PLAN-IT-B/BachelorProefTrappenMaar/Components/SnelheidViaESP/opstelling.jpg

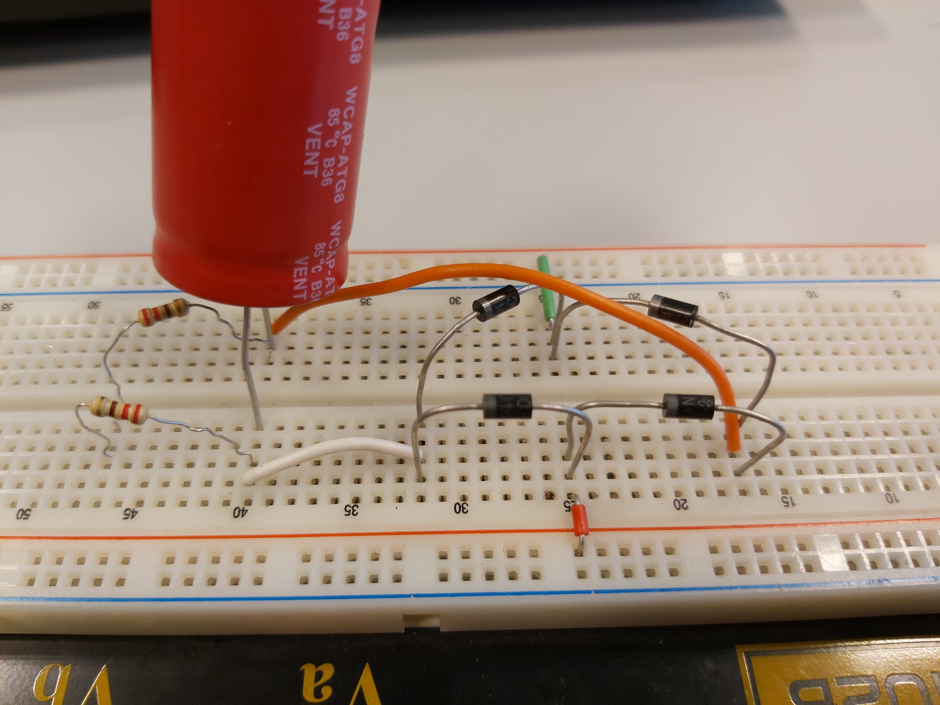
Components/SnelheidViaESP/opstelling.jpg
