PLAN-IT-B/BachelorProefTrappenMaar/documentatie/trappenMaar Gantt_chart.pdf

13 | 20 | 27
| 2/22 3/22 4/22 5/22
6 | 13 | 20 | 27 | 3 | 10 | 17 | 24 | 1 | 8 | 15
Gantt chart trappen maar | start | end | 0h | 0%
First Group (click to rename) | 14/02/22 | 17/05/22 | 0h | 0%
Planning maken | 14/02 | 20/02 | 0 | 0%
brainstormen | 21/02 | 21/02 | 0 | 0%
Opzoeken technologieën | 21/02 | 21/02 | 0 | 0%
onderdelen (stapsgewijs) testen | 21/02 | 22/03 | 0 | 0%
Componenten bestellen | 22/02 | 01/03 | 0 | 0%
Alles connecteren | 22/03 | 22/03 | 0 | 0%
PCB ontwerp maken | 23/03 | 29/03 | 0 | 0%
PCB etsen, testen en verifiëren | 29/03 | 29/03 | 0 | 0%
PCB bestellen | 12/04 | 12/04 | 0 | 0%
inkleding eigen puzzels | 08/03 | 03/05 | 0 | 0%
documentatie | 22/02 | 17/05 | 0 | 0%
presentatie maken | 10/05 | 17/05 | 0 | 0%
finale testing en presentatie | 17/05 | 17/05 | 0 | 0%
inkleding escape room | 19/04 | 03/05 | 0 | 0%
integratie alle opdrachten | 03/05 | 03/05 | 0 | 0%
1e test (wij) | 03/05 | 03/05 | 0 | 0%
2e test (derden) | 10/05 | 10/05 | 0 | 0%

Powered by TCPDF (www.tcpdf.org)
