PLAN-IT-B/BachelorProefTrappenMaar/documentatie/fotos voor presentatie/2014-flappybird-gr%20%281%29.jpg

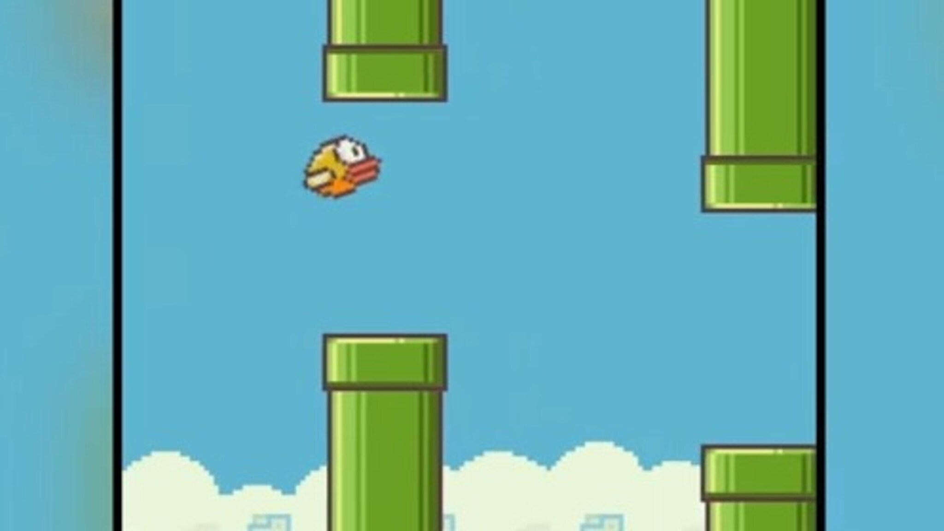
documentatie/fotos voor presentatie/2014-flappybird-gr%20%281%29.jpg
