PLAN-IT-B/BachelorProefTrappenMaar/documentatie/fotos voor presentatie/Desktop-Verstelbare-DC-DC-Converter-USB-en-Micro-USB-1-1500x1500w.jpg

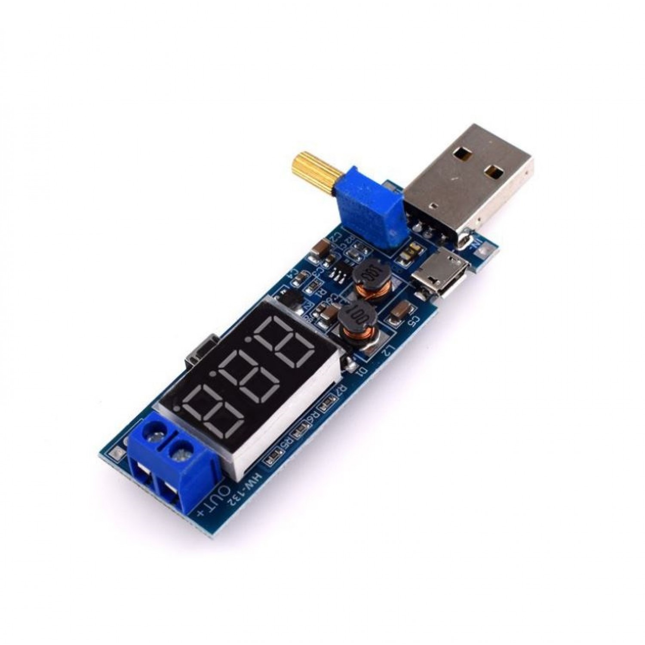
documentatie/fotos voor presentatie/Desktop-Verstelbare-DC-DC-Converter-USB-en-Micro-USB-1-1500x1500w.jpg
