PLAN-IT-B/BachelorProefTrappenMaar/documentatie/fotos voor presentatie/Geel licht.jpg

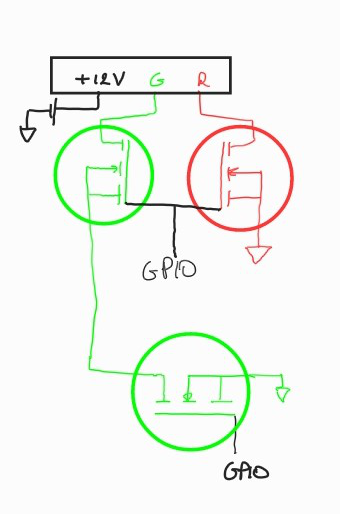
documentatie/fotos voor presentatie/Geel licht.jpg
