PLAN-IT-B/BachelorProefTrappenMaar/documentatie/fotos voor presentatie/uv.jpg

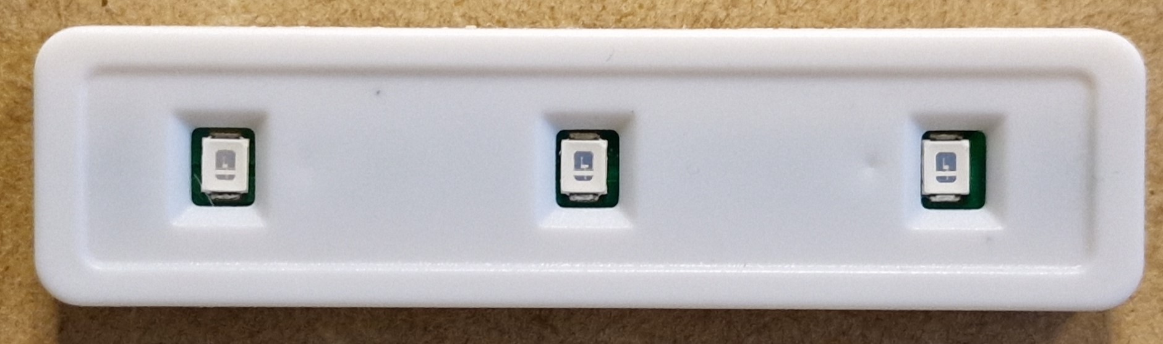
documentatie/fotos voor presentatie/uv.jpg
