PLAN-IT-B/BachelorProefTrappenMaar/documentatie/fotos voor presentatie/Vernieuwd geel licht_1.jpg

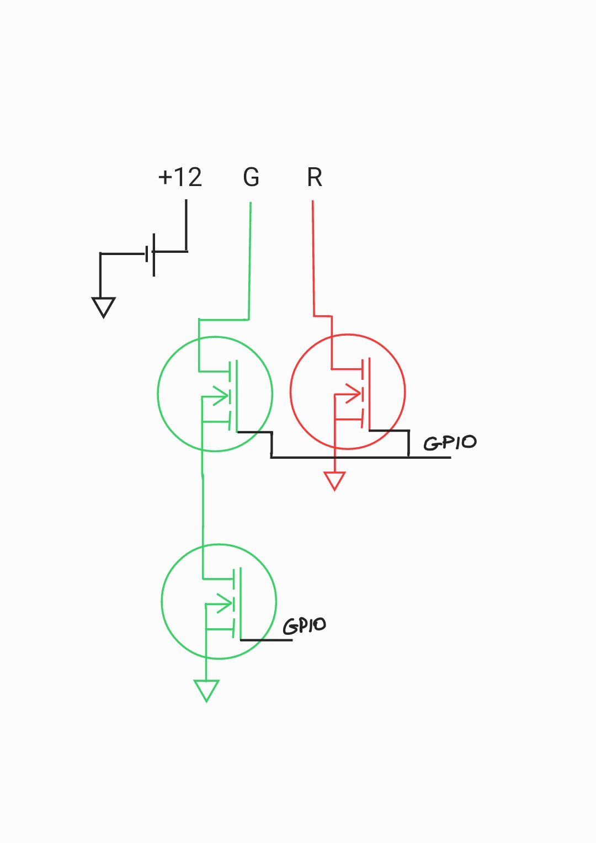
documentatie/fotos voor presentatie/Vernieuwd geel licht_1.jpg
