PLAN-IT-B/BachelorProefTrappenMaar/probeersels code/poging 1/rgbDriverOrangeYellow/WerkendeMetVeelTransistoren/20220328_114709.jpg

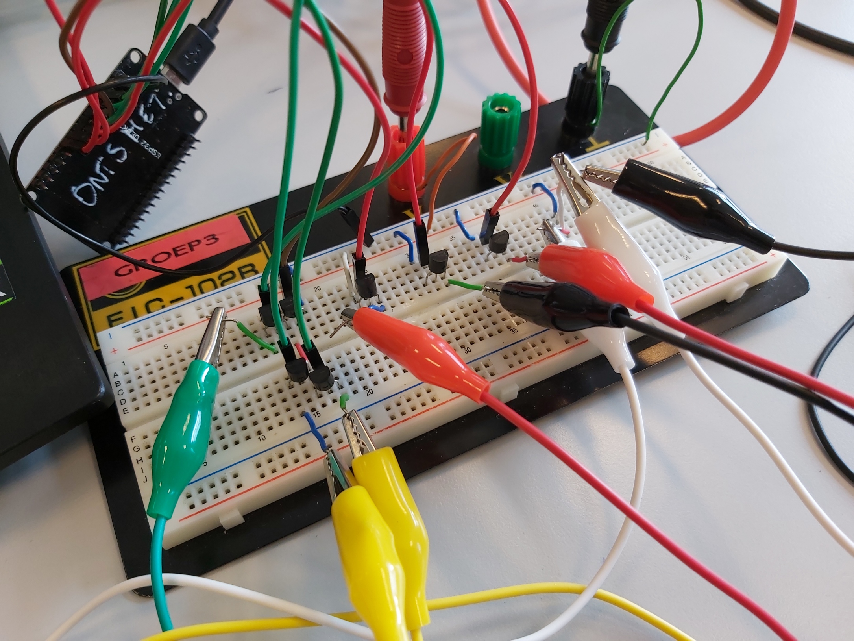
probeersels code/poging 1/rgbDriverOrangeYellow/WerkendeMetVeelTransistoren/20220328_114709.jpg
