PLAN-IT-B/BachelorProefTrappenMaar/Screenshot_1.png

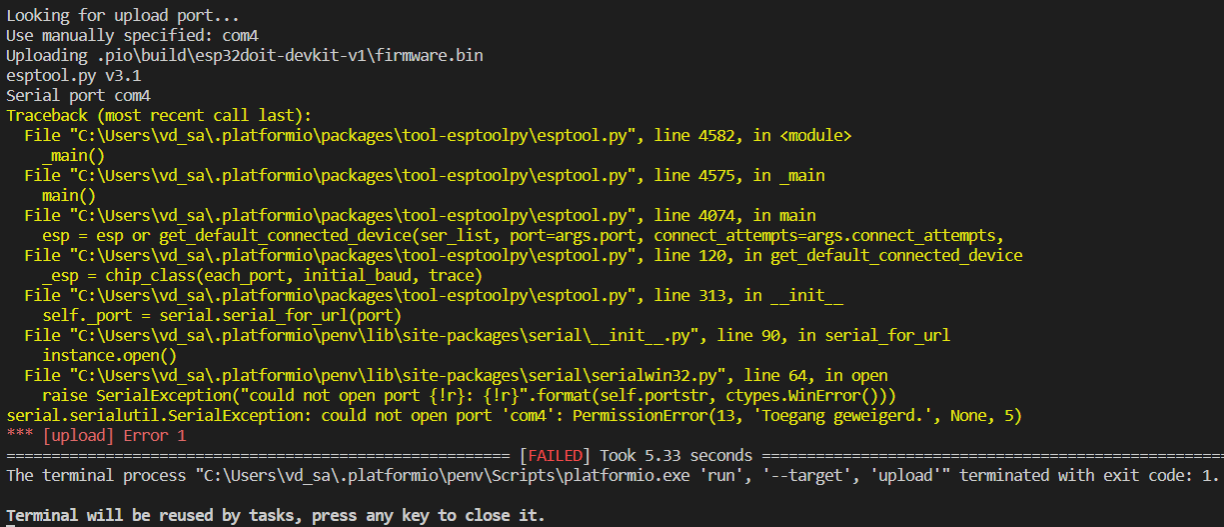
Screenshot_1.png
