PLAN-IT-B/BachelorProefTrappenMaar/website/blokschema.png

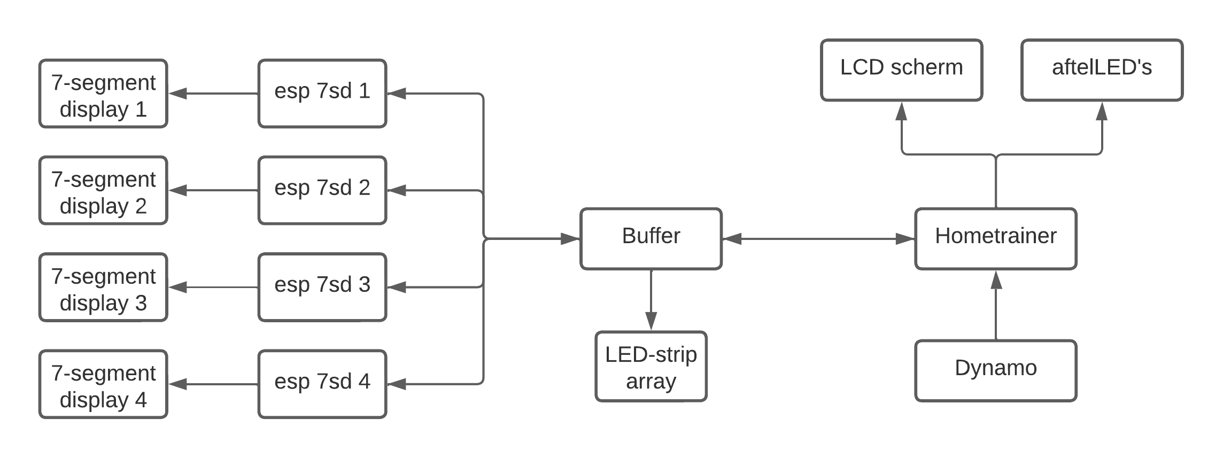
website/blokschema.png
