PLAN-IT-B/BachelorProefTrappenMaar/website/flowchart.png

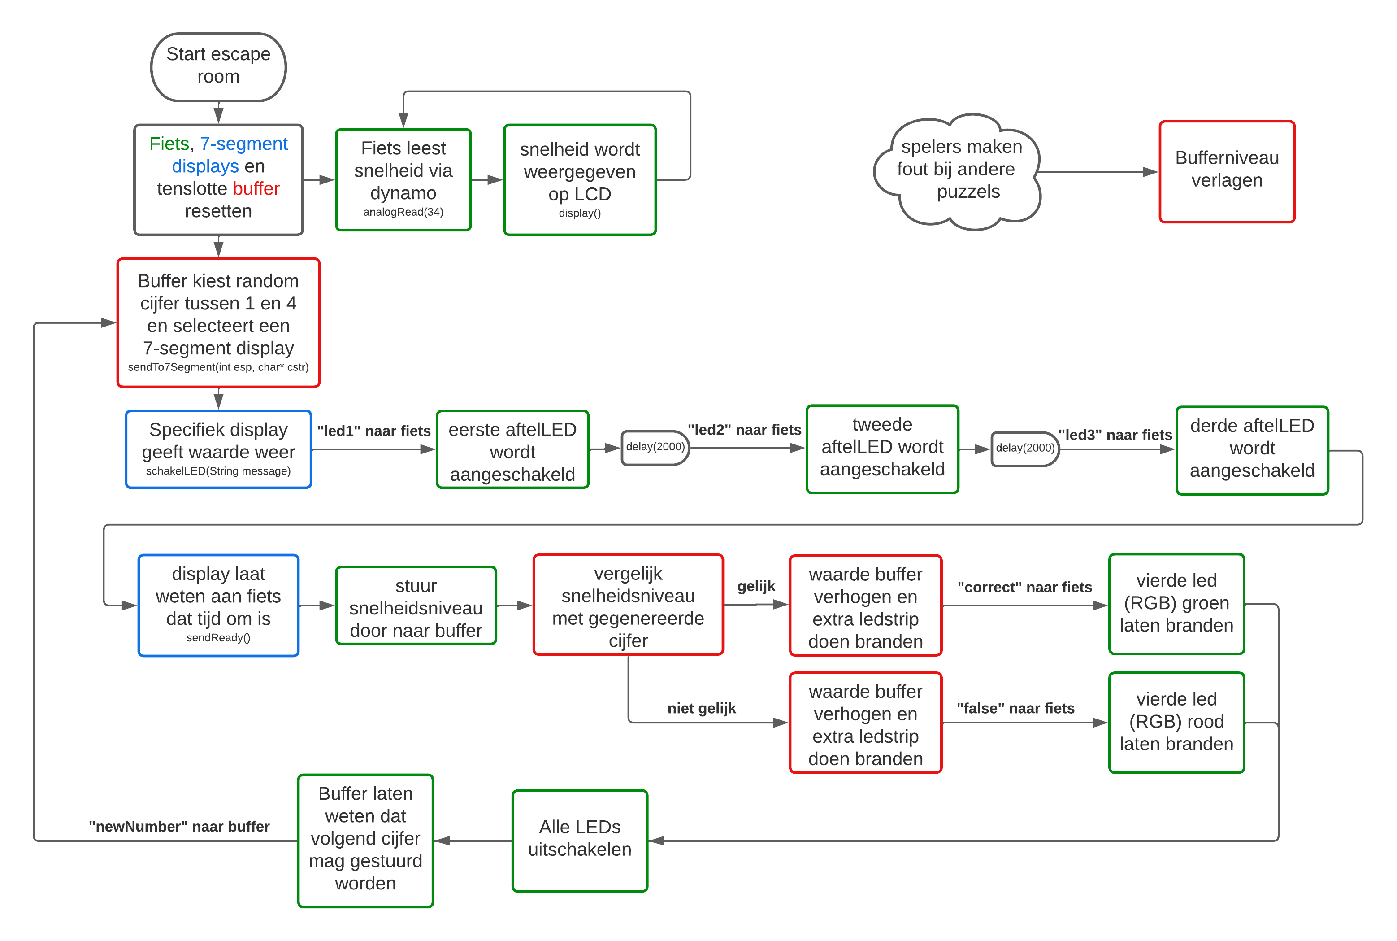
website/flowchart.png
