PLAN-IT-B/BachelorProefTrappenMaar/website/foto's/7segment/7segment.jpg

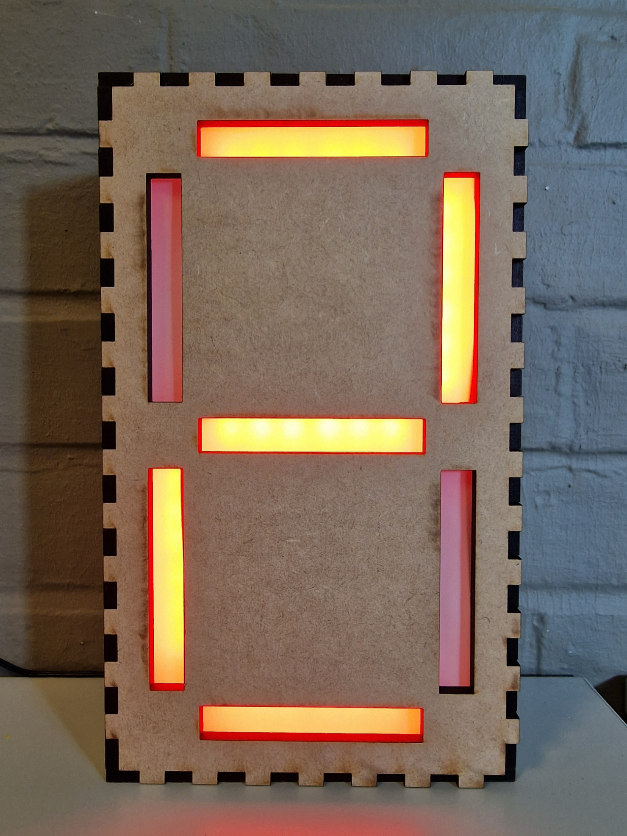
website/foto's/7segment/7segment.jpg
