PLAN-IT-B/BachelorProefTrappenMaar/website/foto's/alles.jpg

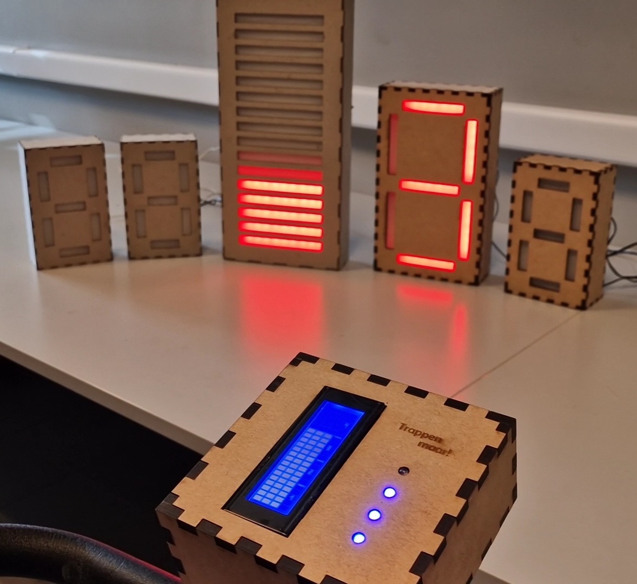
website/foto's/alles.jpg
