PLAN-IT-B/BachelorProefTrappenMaar/website/foto's/Buffer/20220517_134410.jpg

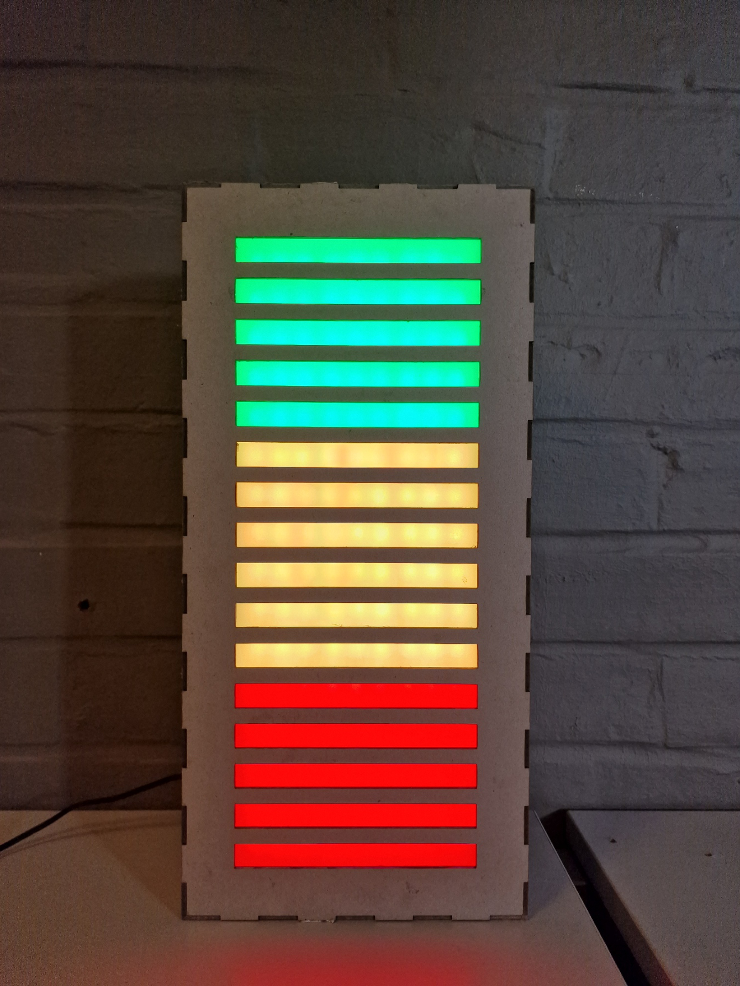
website/foto's/Buffer/20220517_134410.jpg
