PLAN-IT-B/BachelorProefTrappenMaar/website/foto's/Buffer/buffer.jpg

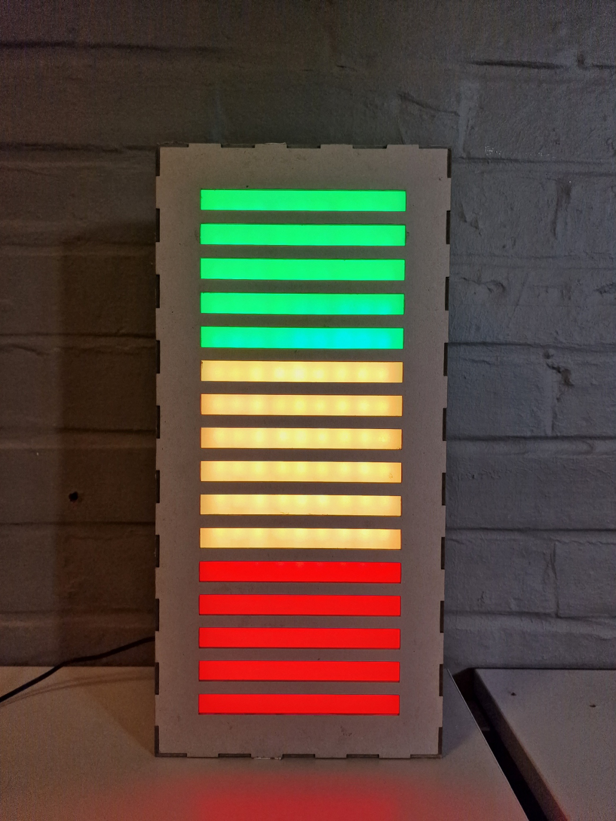
website/foto's/Buffer/buffer.jpg
