PLAN-IT-B/BachelorProefTrappenMaar/website/foto's/Fiets/20220517_134557.jpg

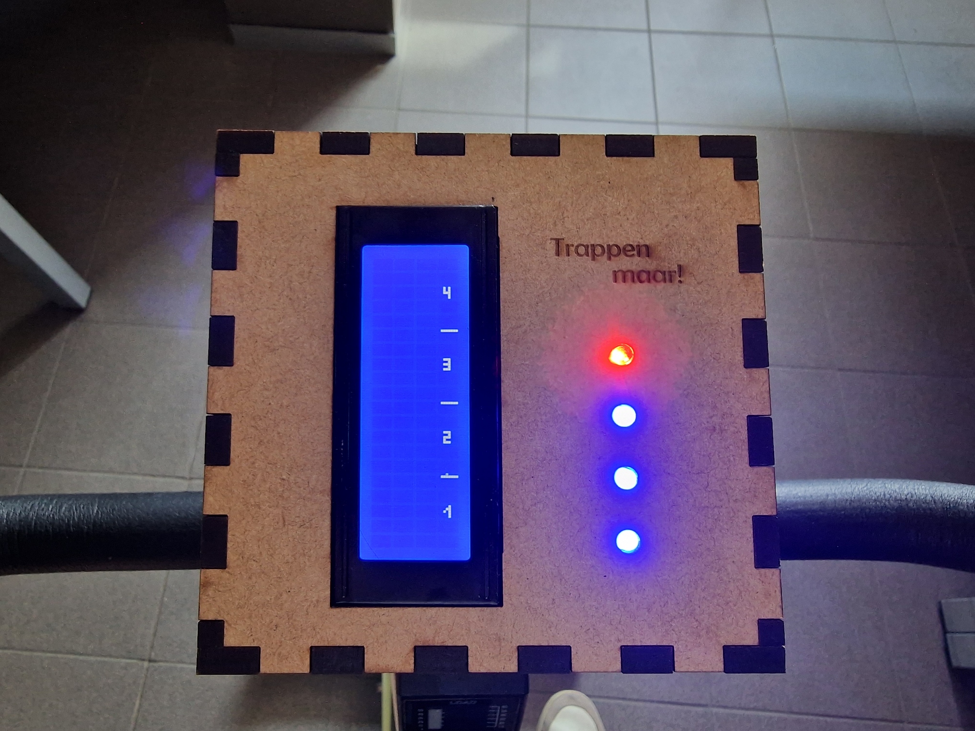
website/foto's/Fiets/20220517_134557.jpg
