PLAN-IT-B/BachelorProefTrappenMaar/website/foto's/Fiets/20220517_134650.jpg

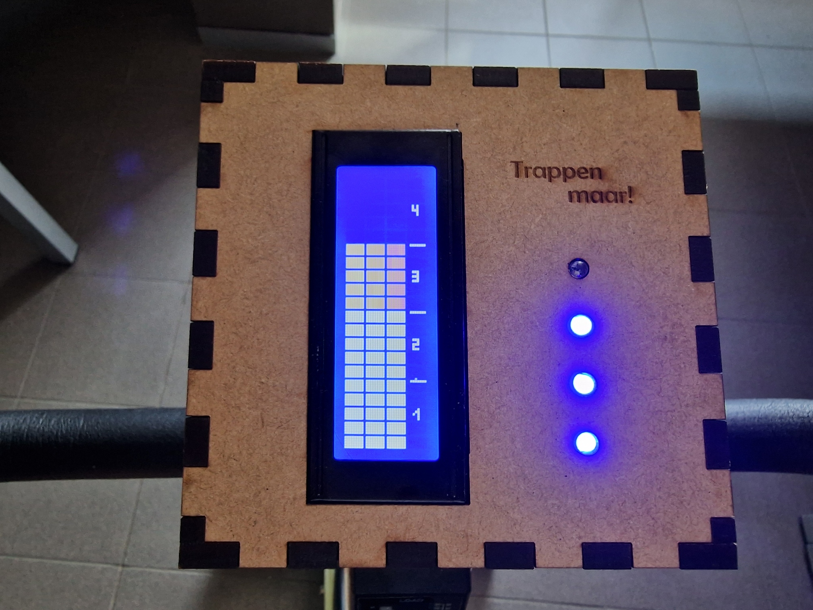
website/foto's/Fiets/20220517_134650.jpg
