PLAN-IT-B/BachelorProefTrappenMaar/website/foto's/Fiets/hometrainer.jpg

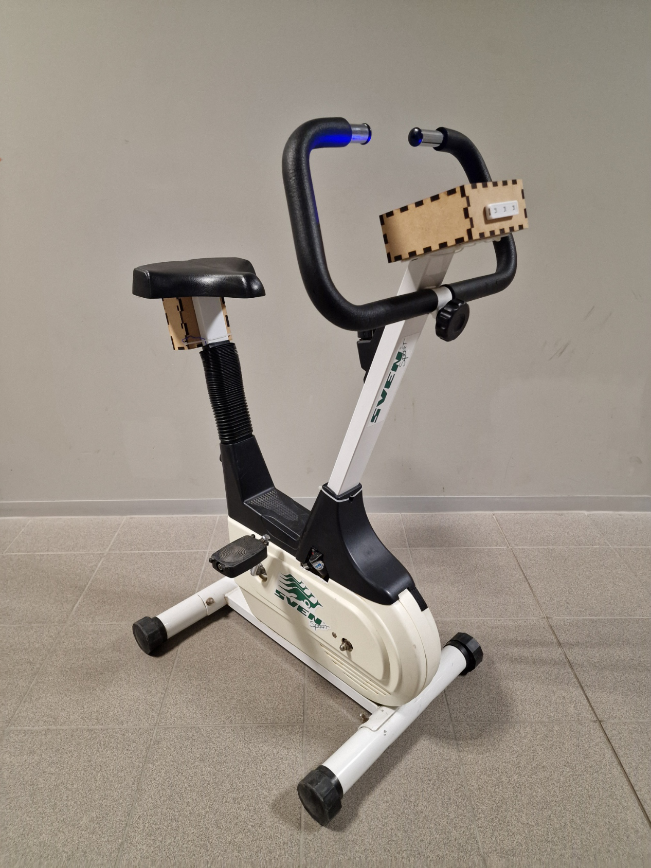
website/foto's/Fiets/hometrainer.jpg
