PLAN-IT-B/BachelorProefTrappenMaar/website/foto's/Fiets/juistGetrapt.jpg

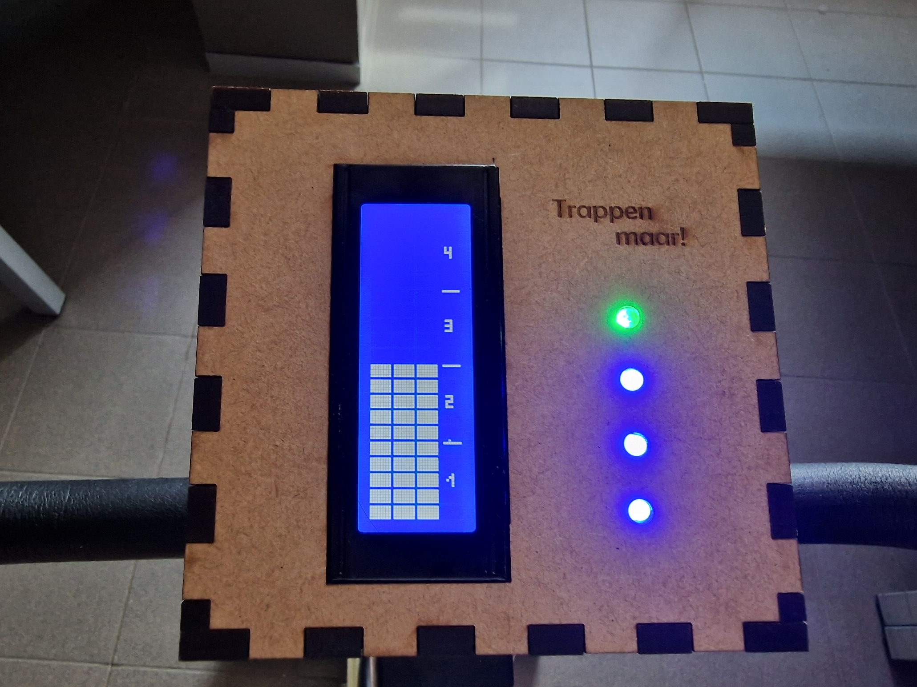
website/foto's/Fiets/juistGetrapt.jpg
