PLAN-IT-B/BachelorProefTrappenMaar/website/foto's/Fiets/lcd2.jpg

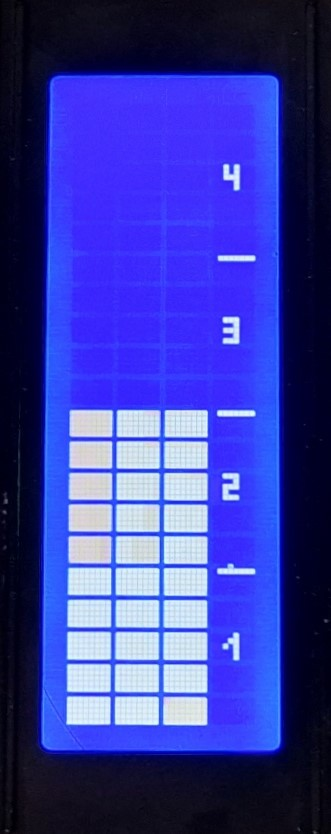
website/foto's/Fiets/lcd2.jpg
