PLAN-IT-B/BachelorProefTrappenMaar/website/foto's/Fiets/lcd.jpg

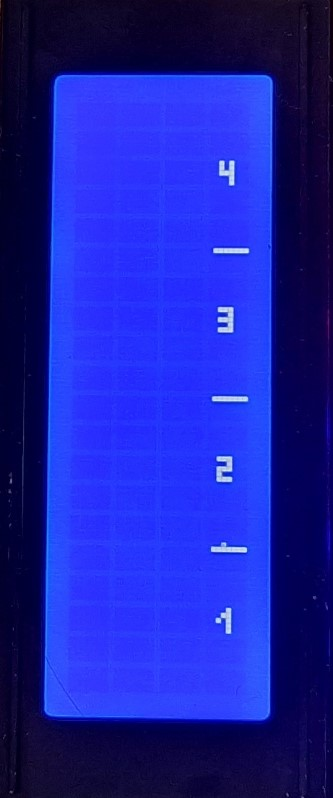
website/foto's/Fiets/lcd.jpg
