PLAN-IT-B/BachelorProefTrappenMaar/website/foto's/Fiets/lcd_collage.jpg

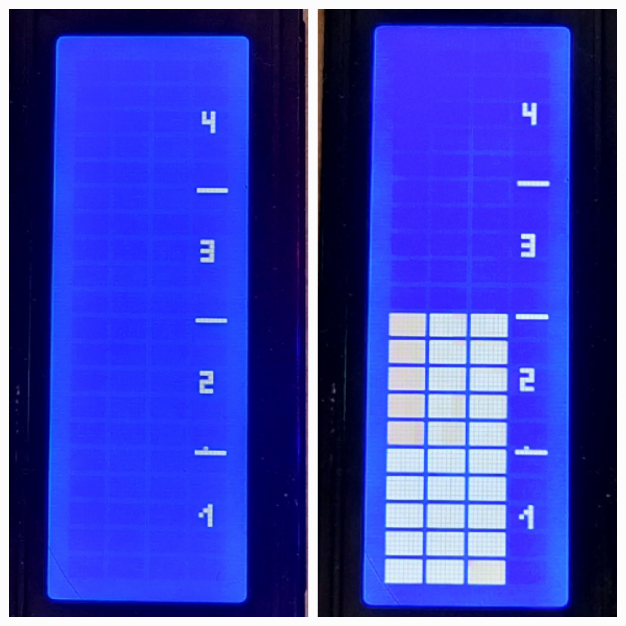
website/foto's/Fiets/lcd_collage.jpg
