PLAN-IT-B/BachelorProefTrappenMaar/website/Kicad_screenshots/7Segment/EEschema.png

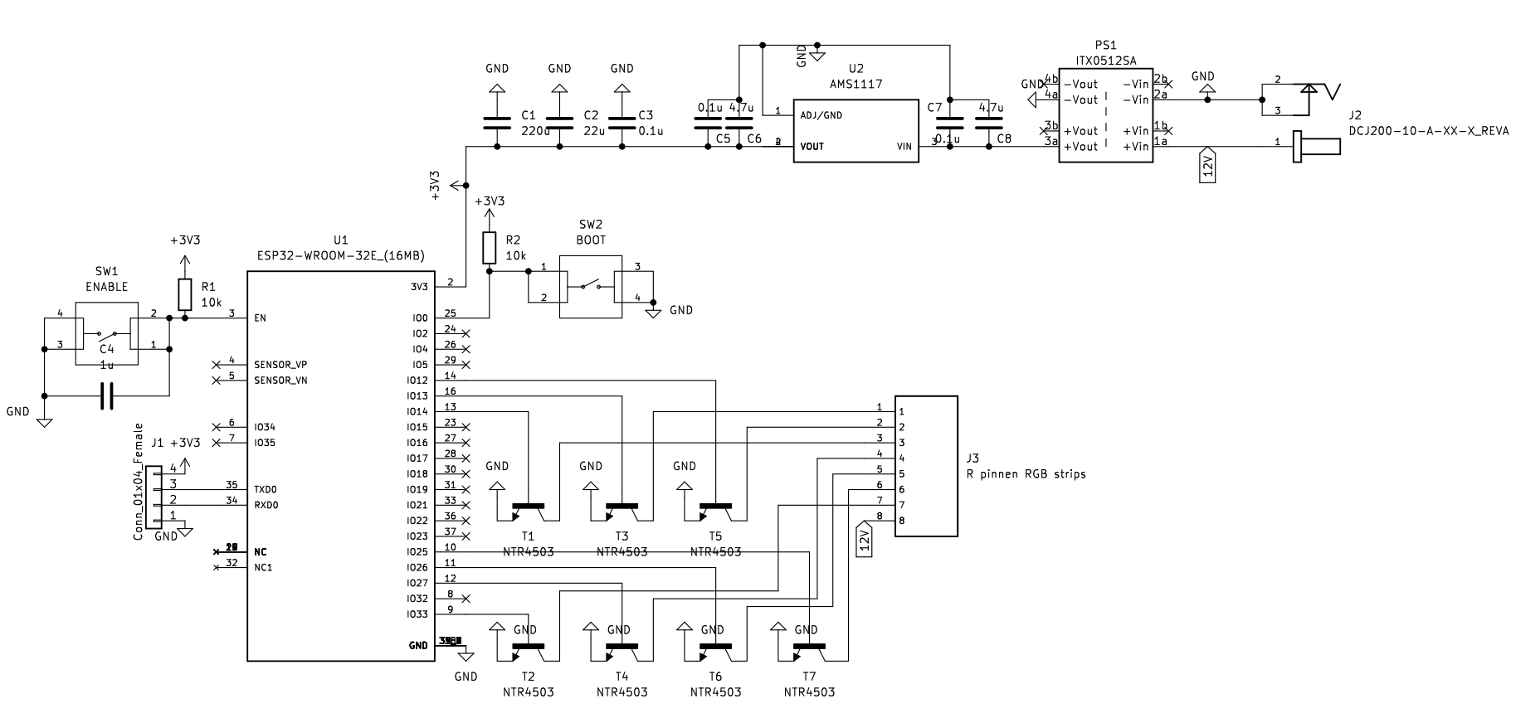
website/Kicad_screenshots/7Segment/EEschema.png
