PLAN-IT-B/BachelorProefTrappenMaar/website/Kicad_screenshots/7Segment/PCB_achterkant.png

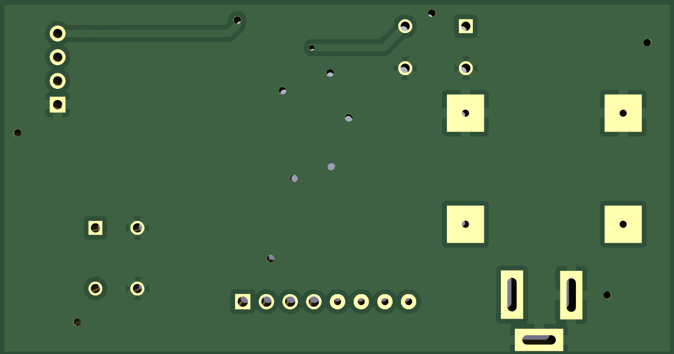
website/Kicad_screenshots/7Segment/PCB_achterkant.png
