PLAN-IT-B/BachelorProefTrappenMaar/website/Kicad_screenshots/7Segment/PCB_voorkant.png

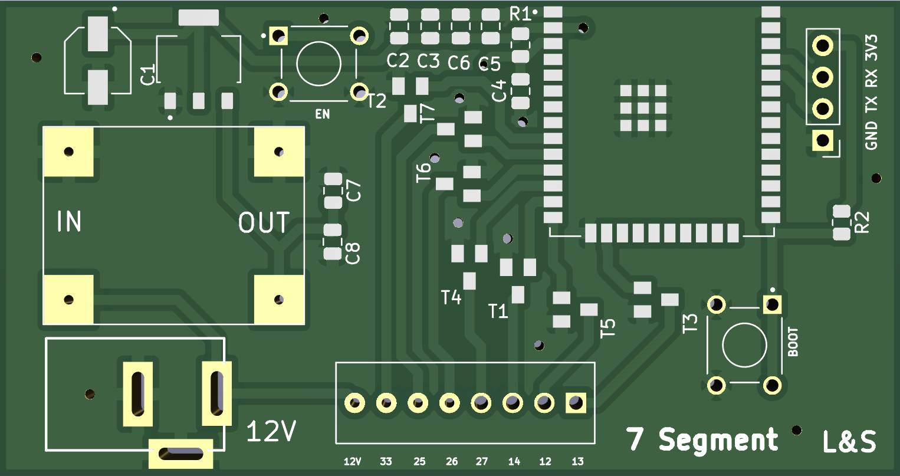
website/Kicad_screenshots/7Segment/PCB_voorkant.png
