PLAN-IT-B/BachelorProefTrappenMaar/website/Kicad_screenshots/Buffer/EEschema.png

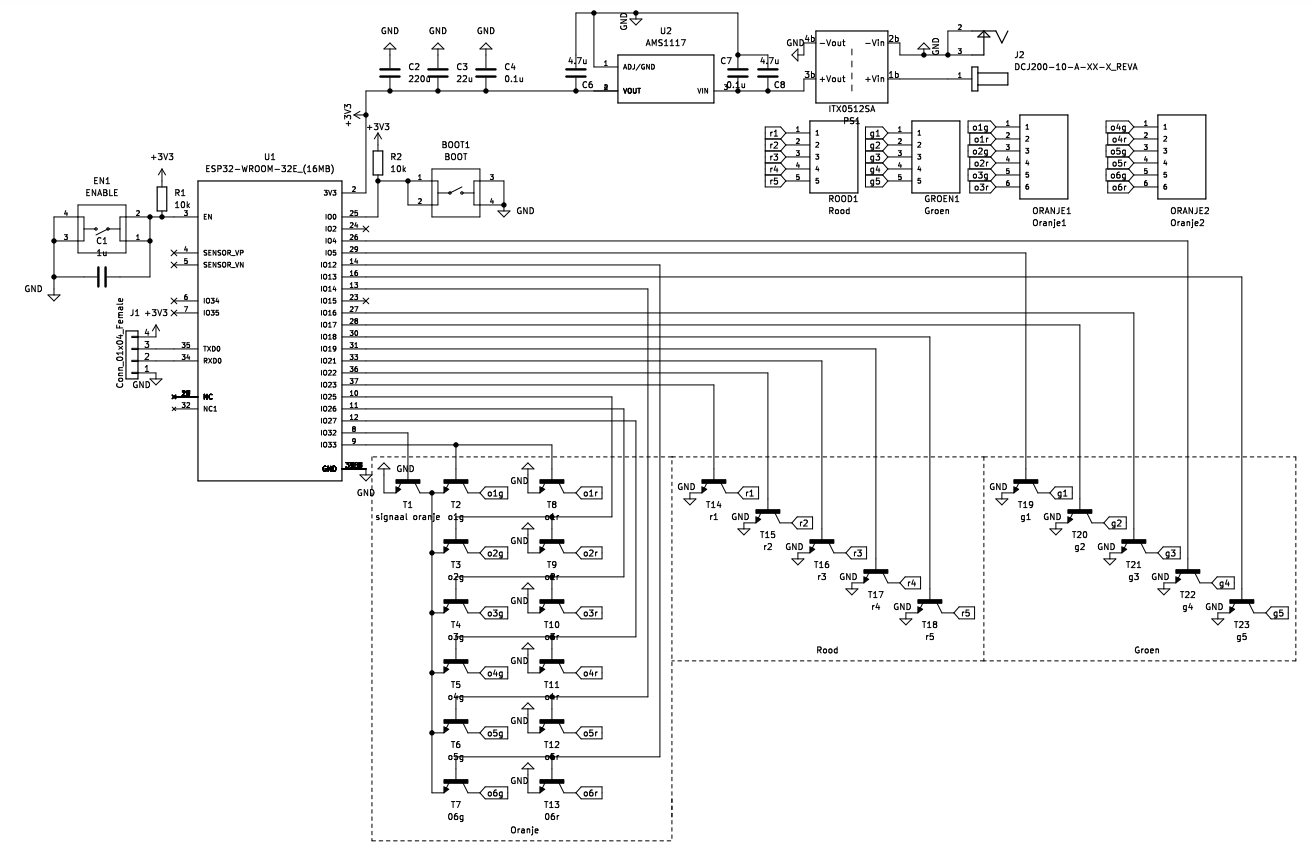
website/Kicad_screenshots/Buffer/EEschema.png
