PLAN-IT-B/BachelorProefTrappenMaar/website/Kicad_screenshots/Buffer/PCB_achterkant.png

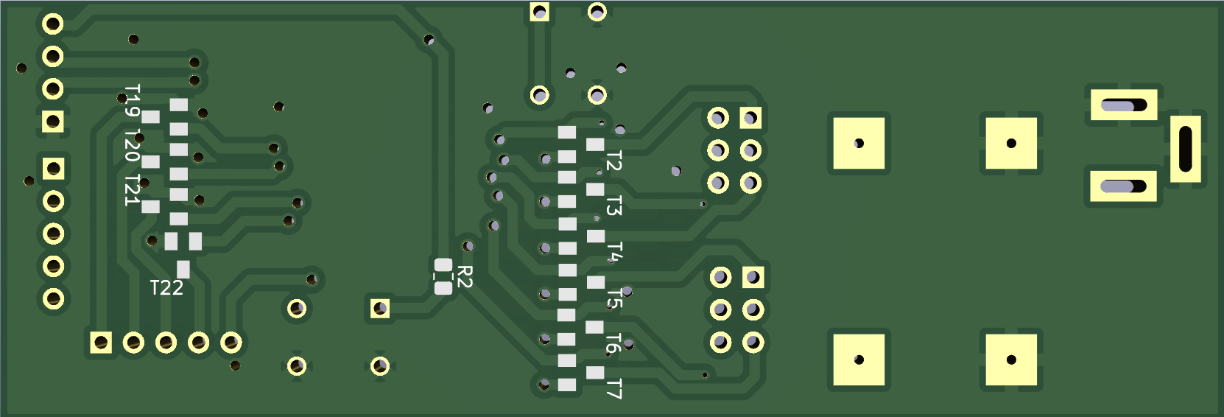
website/Kicad_screenshots/Buffer/PCB_achterkant.png
