PLAN-IT-B/BachelorProefTrappenMaar/website/Kicad_screenshots/Buffer/PCB_voorkant.png

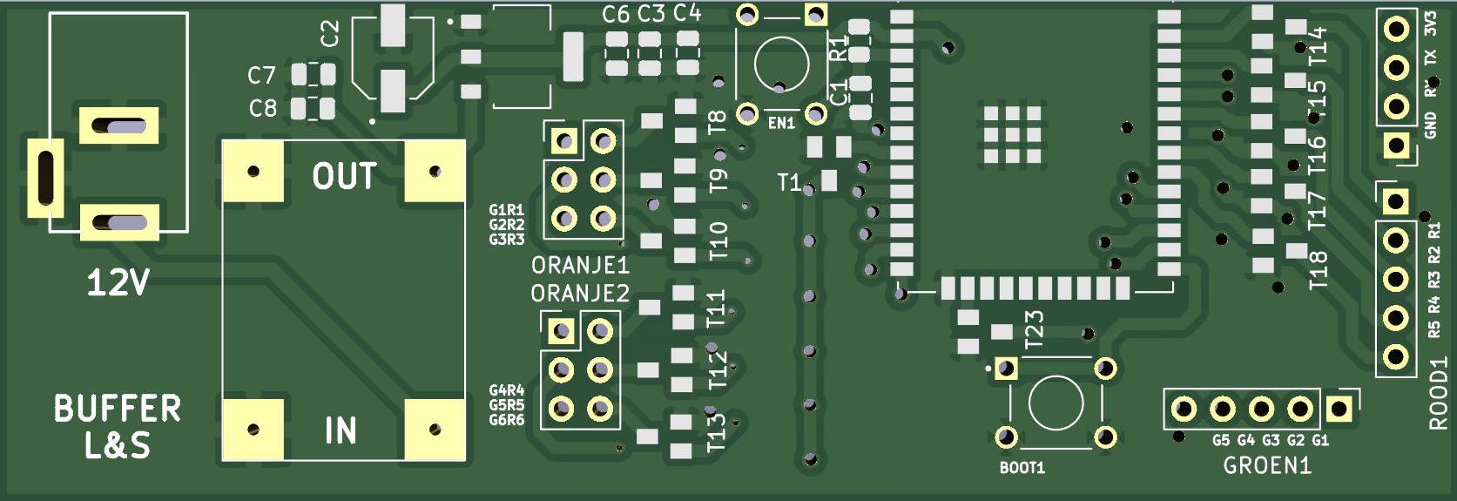
website/Kicad_screenshots/Buffer/PCB_voorkant.png
