PLAN-IT-B/BachelorProefTrappenMaar/website/Kicad_screenshots/Fiets/EEschema.png

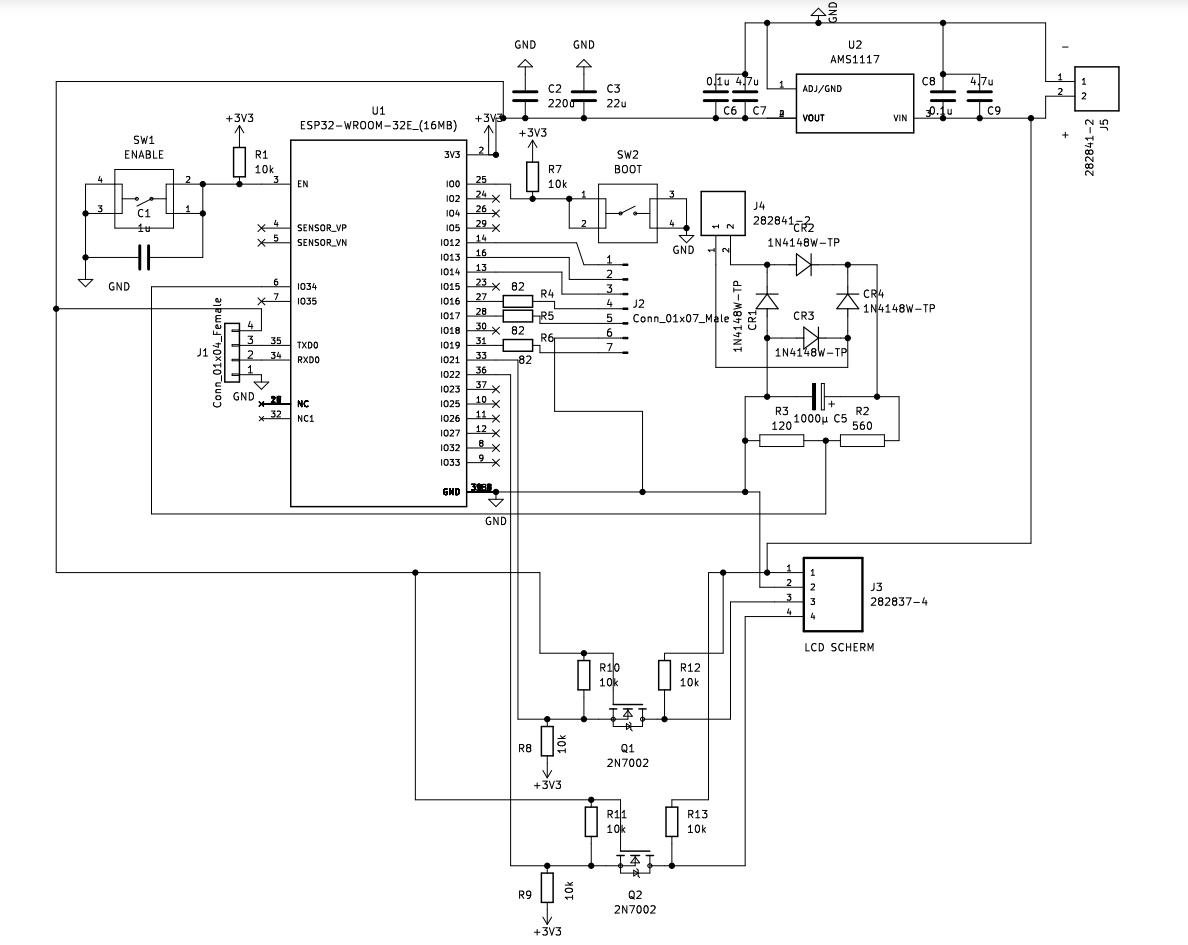
website/Kicad_screenshots/Fiets/EEschema.png
