PLAN-IT-B/BachelorProefTrappenMaar/website/Kicad_screenshots/Fiets/pcb.png

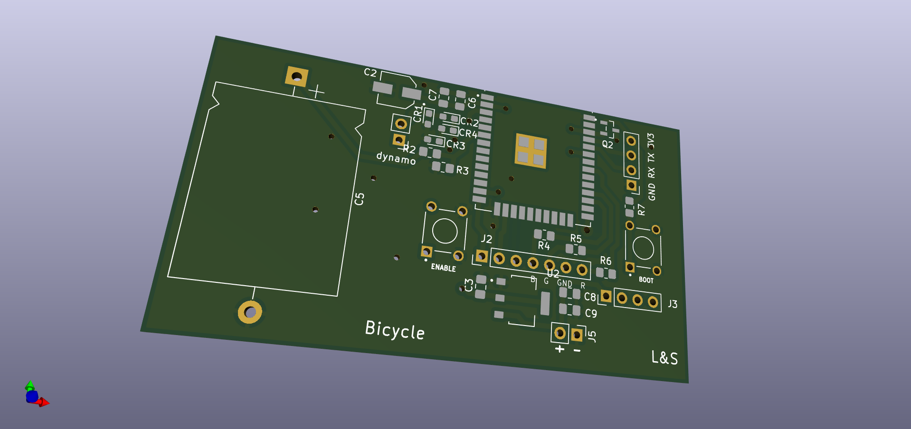
website/Kicad_screenshots/Fiets/pcb.png
