PLAN-IT-B/BachelorProefTrappenMaar/website/Kicad_screenshots/Fiets/PCB_achterkant.png

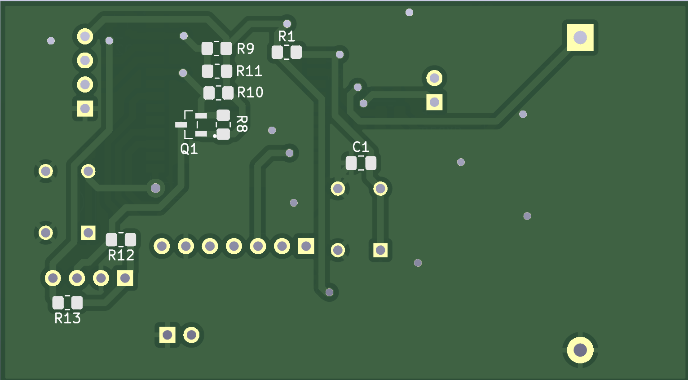
website/Kicad_screenshots/Fiets/PCB_achterkant.png
