PLAN-IT-B/BachelorProefTrappenMaar/website/Kicad_screenshots/Fiets/pcb_voorkant.png

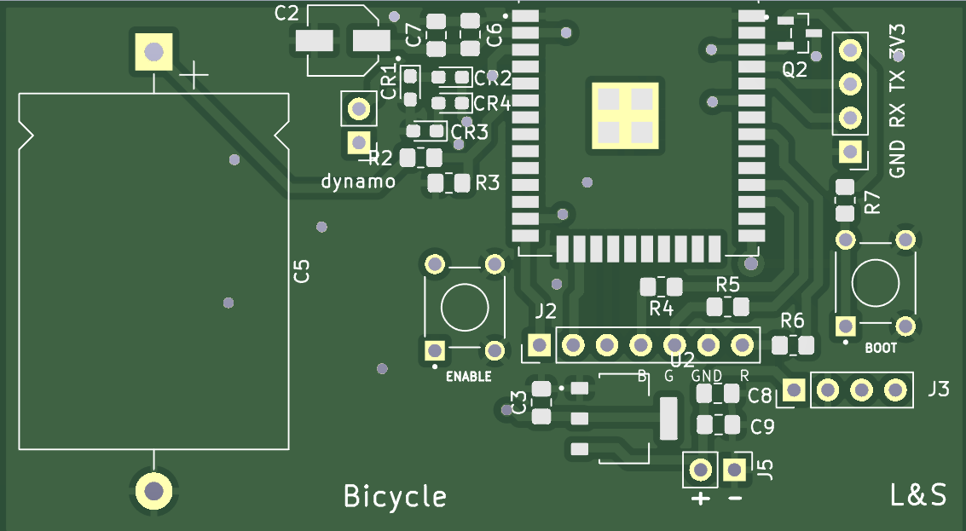
website/Kicad_screenshots/Fiets/pcb_voorkant.png
