PLAN-IT-B/BachelorProefTrappenMaar/documentatie/BOM.docx

# Verhaal schetsen om BOM op te stellen

Het fietsspel op zich bestaat uit:

De hometrainer met paneel

Verschillende 7 segment displays

Een buffer die dient opgevuld te worden

Op het wiel van de hometrainer monteren we een reed relay die aangesloten is op een esp32.

Diezelfde (?) esp is verbonden met het paneel van de fiets waarop het huidige snelheidsniveau, de score en de tijd worden weergegeven. Het paneel zal bestaan uit een lcd scherm om het snelheidsniveau aan te duiden, 2(?) 7-segment displays om de score weer te geven en 4 leds om af te tellen

De buffer zal bestaan uit gestapelde ledstrips die per horizontaal niveau kunnen aangestuurd worden (aan/uit + kleuronderscheid rood, oranje en groen).

# BOM

- Reed relay ( eventueel meerdere om defecten voor te zijn) + weerstand 1kOhm
- Lcd scherm → oke? Hebben we uit de les
- double 7-segment displays
- 4 leds (3 leds in een kleur bv WIT, 1 in een ander om de beslissende tel aan te duiden bv ROOD)
- 1 esp32 voor centrale puzzel

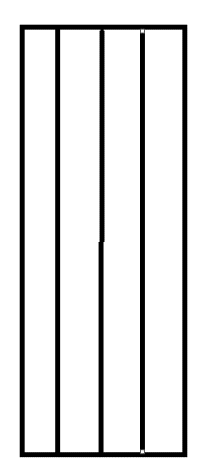
[picture p36: figure]

- 1 esp32 voor buffer
- Ledstrips voor elk niveau van de buffer ( eventueel door 1 lange ledstrip in stukken te knippen) https://www.youtube.com/watch?v=5M24QUVE0iU

2 opties:

a) Aantal ledstrips naast elkaar

Soorten ledstrips: WS2811 of WS2812B
(4 dollar per meter)
makkelijker te programmeren

Indien deze individueel adresseerbare leds binnen ons budget passen, is dit principe goed voor mij!

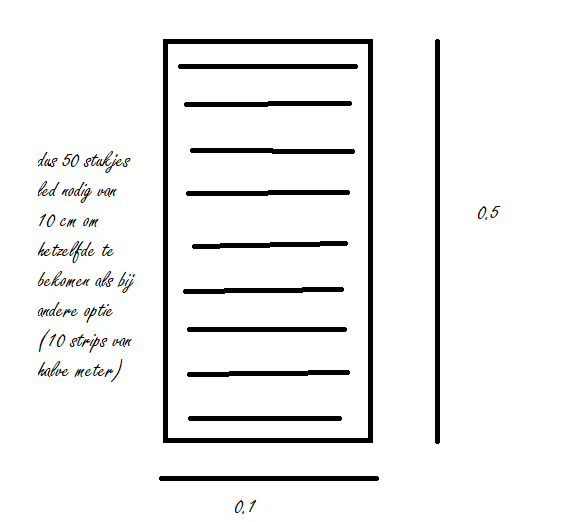
[picture p37: figure]

Bv: https://diamantled.nl/digitale-led-strip-los-ws2811-60led-m-ip20.html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

→kdenk da 5meter (en dan 10cm x 50cm breedte buffer) wel oke is

b) Aantal strips boven elkaar

SMD5050

(1 dollar per meter)

Moeilijker te programmeren, meer werk.. ipv 10strips hier 50 strips!

Deze methode kunnen we doen indien ons budget het anders niet aankan.

- (diffusers voor ledstrip)

Bv:

- https://www.edmundoptics.eu/p/100-x-100mm-Light-Diffusing-Film/45304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

OF

- https://www.lampdirect.be/nl/ledvance-led-strip-profile-cover-ls-ay-pc-r02-d-1-wit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

Dit zal de goedkoopste optie zijn

- 4 (?) esp32’s voor cijfers weer te geven
- 4 7-segment displays (eventueel wat grotere dan de standaard/zelf maken)
- https://www.youtube.com/watch?v=MxvVChXsETc
- https://www.youtube.com/watch?v=c-fH5WEvn8M

(zelfde principe als eerste link, maar minder mooi afgewerkt)

Denk dat eerste link inderdaad het mooiste resultaat gaat geven en ook wat minder prutswerk inhoudt

Benodigdheden (per 7-segment display):

1. Dik Isomo (1 à 2 cm doorsnede)
2. Dun isomo (zo dun mogelijk, werkt als diffuser voor leds)
3. 7 leds (zelfde kleur)
4. 7 koolweerstanden van 220 ohm
- Fietsgenerator

(zie vragen/opmerkingen hieronder)

VRAGEN BERT:

- Generator? Bike generator? Wat is er?

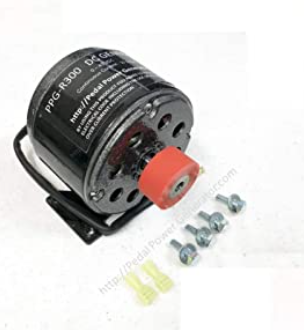
[picture p38: figure]

best zo principe, dat we da oranje dan tegen ons wiel kunnen zetten

Opties?

1) Fietsdynamo: produceert 6V (3W) maar dan is de vraag, welke lamp??
2) Grotere generator: maar dit kost veel.. hebben ze dit op de campus?
3) Eventueel gewone alternator (in alle vormen en maten verkrijgbaar)
4) Desnoods dc-motor aansluiten op wiel zodat die als alternator fungeert

Hoe zorgen we hier voor een constante stroom zodat de lamp weldegelijk kan aangedreven worden?
