PLAN-IT-B/BachelorProefTrappenMaar/documentatie/BOM(final version).xlsx

WAT | LINK | AANTAL | PRIJS/STUK | TOTAAL
blacklight | https://www.bol.com/be/nl/p/mini-16cm-uv-blacklight-met-zaklamp/9200000083518615/ | 1 | 16.44 | 16.44
kroonsteentje 2 | https://www.tinytronics.nl/shop/nl/kabels-en-connectoren/connectoren/schroefterminals/2-pin-schroef-terminal-block-connector-2.54mm-afstand | 1 | 0.3 | 0.3
kroonsteentje 4 | https://www.tinytronics.nl/shop/nl/kabels-en-connectoren/connectoren/schroefterminals/4-pin-schroef-terminal-block-connector-2.54mm-afstand | 1 | 0.45 | 0.45
kroonsteentje 5 | https://www.tinytronics.nl/shop/nl/kabels-en-connectoren/connectoren/schroefterminals/5-pin-schroef-terminal-block-connector-2.54mm-afstand | 2 | 0.5 | 1 |  | (eventuele) EXTRA KOSTEN
kroonsteentje 8 | https://www.tinytronics.nl/shop/nl/kabels-en-connectoren/connectoren/schroefterminals/8-pin-schroef-terminal-block-connector-2.54mm-afstand | 4 | 0.8 | 3.2 |  | lasercutten | ongeveerd 20 euro
ldo ams1117 |  | 6 | 0.25 | 1.5 |  | hometrainer | -
level shifter |  | 1 |  |  |  | fietsdynamo | -
buck converter |  | 5 | 2.39 | 11.95
esp |  | 6 | 4 | 24
pin header Female 4 |  | 6 | 0.4 | 0.4
dc jack |  | 5 | 0.5 | 2.5
buttons |  | 12 | 0.15 | 1.8
C 100uF |  | 6
C 22uF |  | 6
C 0.1uF |  | 18
C 1mF (THT) |  | 1
C 1uF |  | 6
C 4.7uF |  | 12 |  |  | 2 euro
R 10k |  | 12
R 560 |  | 1
R 120 |  | 1
R 82 |  | 3
mosfet NTR4503 |  | 51 |  |  | n-kanaals mosfet met toegelaten source-drainspanning van minstens 20V
ledstrip |  | 1 | 9 | 9 | RGB-ledstrip (hoeven geen afzonderlijk adresseerbare leds te zijn)
 |  |  |  | 74.54
AANTAL COMPONENTEN PER PCB
7 segments (4) |  |  |  |  |  |  |  | buffer |  |  | fiets
C 100uF |  | 1 | 4 |  |  |  |  | C 100uF | 1 |  | C 100uF | 1
C 22uF |  | 1 | 4 |  |  |  |  | C 22uF | 1 |  | C 22uF | 1
C 0.1uF |  | 3 | 12 |  |  |  |  | C 0.1uF | 3 |  | C 0.1uF | 3
C 1uF |  | 1 | 4 |  |  |  |  | C 1uF | 1 |  | C 1uF | 1
C 4.7uF |  | 2 | 8 |  |  |  |  | C 4.7uF | 2 |  | C 4.7uF | 2
R 10k |  | 2 | 8 |  |  |  |  | R 10k | 2 |  | R 10k | 2
pin header Female 4 |  | 1 | 4 |  |  |  |  | pin header Female 4 | 1 |  | pin header Female 4 | 1
kroonsteen 2 |  | 1 | 4 |  |  |  |  | dc jack female (laptoplader) | 1 |  | buttons | 2
kroonsteen 8 |  | 1 | 4 |  |  |  |  | kroonsteen 5 | 2 |  | C 1mF (THT) | 1
buck converter |  | 1 | 4 |  |  |  |  | buck converter | 1 |  | diode 1n4148 | 4 | gelijkrichter (brug van Graetz)
buttons |  | 2 | 8 |  |  |  |  | buttons | 2 |  | kroonsteen 4 | 1
mosfet NTR4503 |  | 7 | 28 |  | n-kanaals mosfet met toegelaten source-drainspanning van minstens 20V |  |  | mosfet NTR4503 | 23 | n-kanaals mosfet met toegelaten source-drainspanning van minstens 20V | R 560 | 1
esp |  | 1 | 4 |  |  |  |  | esp | 1 |  | R 120 | 1
ldo ams1117 |  | 1 | 4 |  |  |  |  | ldo ams1117 | 1 |  | R 82 | 3
 |  |  |  |  |  |  |  |  |  |  | esp | 1
 |  |  |  |  |  |  |  |  |  |  | ldo ams1117 | 1
 |  |  |  |  |  |  |  |  |  |  | level shifter | 1
