PLAN-IT-B/BachelorProefTrappenMaar/documentatie/BOM.xlsx

BOM 2e aankoop
WAT | LINK | AANTAL | PRIJS/STUK | TOTAAL
energie opwekken met fiets
blacklight | https://www.bol.com/be/nl/p/mini-16cm-uv-blacklight-met-zaklamp/9200000083518615/ | 1 | 16.44 | 16.44
BOM
WAT | LINK | AANTAL | PRIJS/STUK | TOTAAL
snelheidsmeter
reed relay | https://www.tinytronics.nl/shop/nl/schakelaars/magneetschakelaars/reed-relais-2*14mm | 2 | 0.3 | 0.6
Weerstand 1kOhm | / | 1 | /
lcd scherm 4x20 | / | 1 | / | / | (aanwezig op school)
7 segment display | https://www.tinytronics.nl/shop/nl/displays/segmenten/segmenten-display-1-karakter-rood | 1 | 0.75 | 0.75
blauwe leds | https://www.tinytronics.nl/shop/nl/componenten/led's/led's/blauwe-led-5mm-diffuus | 3 | 0.1 | 0.3
groene led | https://www.tinytronics.nl/shop/nl/componenten/led's/led's/groene-led-5mm-diffuus | 1 | 0.1 | 0.1
esp 32 | / | 1 | / | /
buffer
esp 32 | / | 1 | / | /
ledstrip ??? |  |  |  |  | 3 meter liefst individueel adresseerbare leds maar indien dit niet haalbaar is, kunnen we ook werken met de goedkopere variant
Fietsspel
esp 32 | / | 4 | / | /
ledstrip (domme) | https://www.action.com/nl-be/p/grundig-multicolor-ledstrip/ | 1 | 9.95 | 9.95 | 3 meter, gaan we statisch houden qua kleur (rood), mogen dus heel simpele leds zijn
Generator Fiets
dynamo?
