PLAN-IT-B/BachelorProefTrappenMaar/boxes/7segmentGroot/assembly/assembly.SLDASM

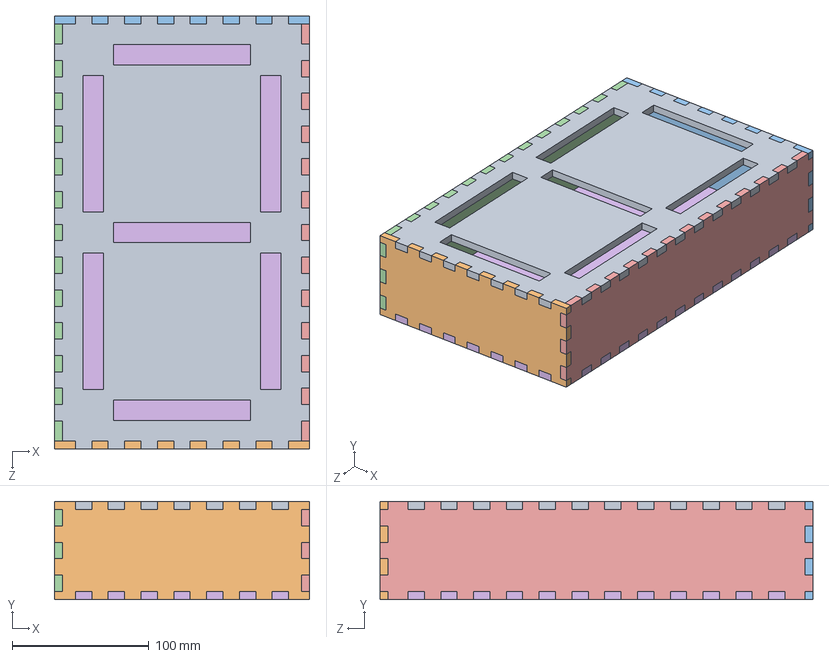
[picture p39: CAD file, 2022-04-26]
boxes/7segmentGroot/assembly/assembly.SLDASM
187.0 x 72.0 x 317.0 mm
TOP_PLANE
FRONT_PLANE
BACK_PLANE
LEFT_SIDE_PLANE
RIGHT_SIDE_PLANE
BOTTOM_PLANE
