PLAN-IT-B/BachelorProefTrappenMaar/boxes/7segmentKlein/assembly/3mm_Assem1.SLDASM

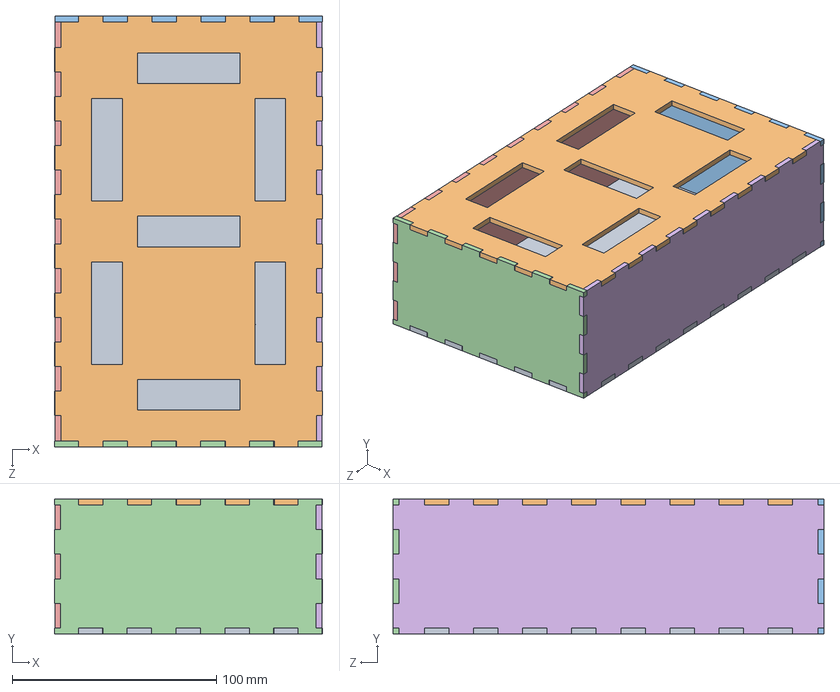
[picture p40: CAD file, 2022-05-09]
boxes/7segmentKlein/assembly/3mm_Assem1.SLDASM
131.2 x 66.0 x 211.0 mm
BOTTOM_PLANE
TOP_PLANE
BACK_PLANE
FRONT_PLANE
LEFT_SIDE_PLANE
RIGHT_SIDE_PLANE
