PLAN-IT-B/BachelorProefTrappenMaar/boxes/Buffer/hout_6mm/Assem1.SLDASM

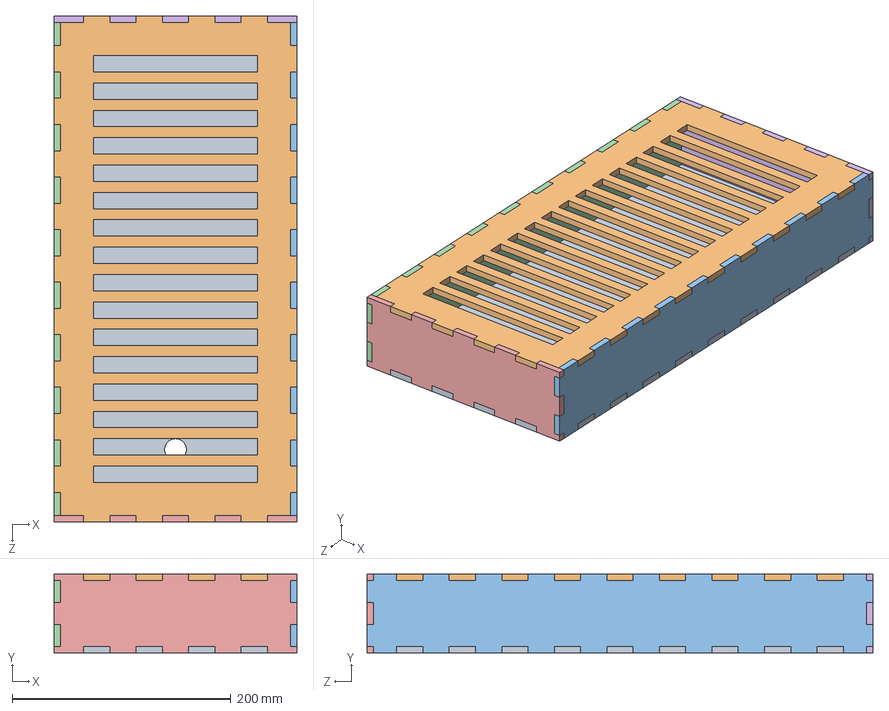
[picture p41: CAD file, 2022-05-03]
boxes/Buffer/hout_6mm/Assem1.SLDASM
222.0 x 72.0 x 462.0 mm
onderkant
bovenkant
lange_zijkant2
lange_zijkant1
voorkant
achterkant
