PLAN-IT-B/BachelorProefTrappenMaar/boxes/Buffer/karton_3mm/Assem1.SLDASM

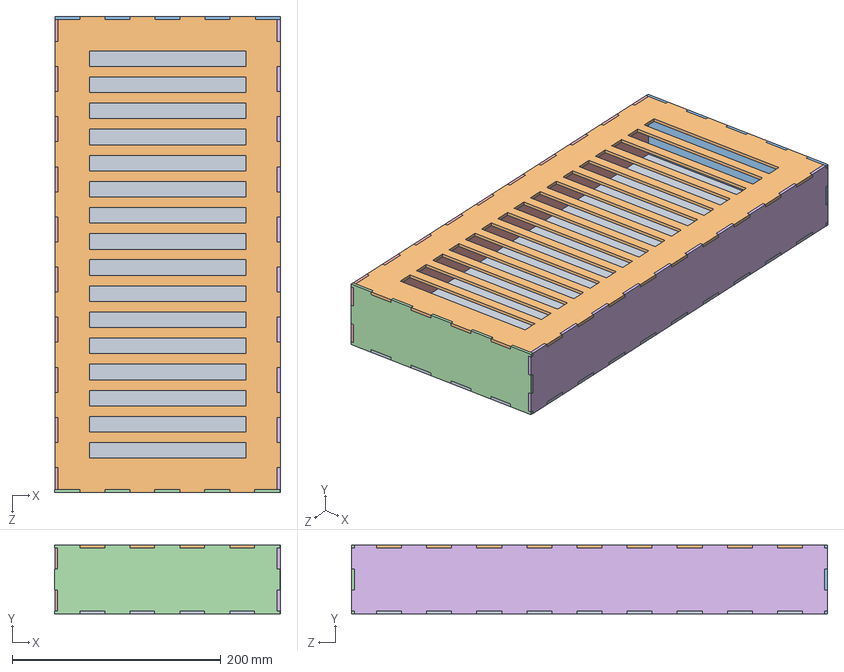
[picture p42: CAD file, 2022-05-09]
boxes/Buffer/karton_3mm/Assem1.SLDASM
216.4 x 66.0 x 456.0 mm
onderkant
bovenkant
achterkant
voorkant
lange_zijkant1
lange_zijkant2
