PLAN-IT-B/BachelorProefTrappenMaar/boxes/Fiets/parts + assembly/BOX.SLDASM

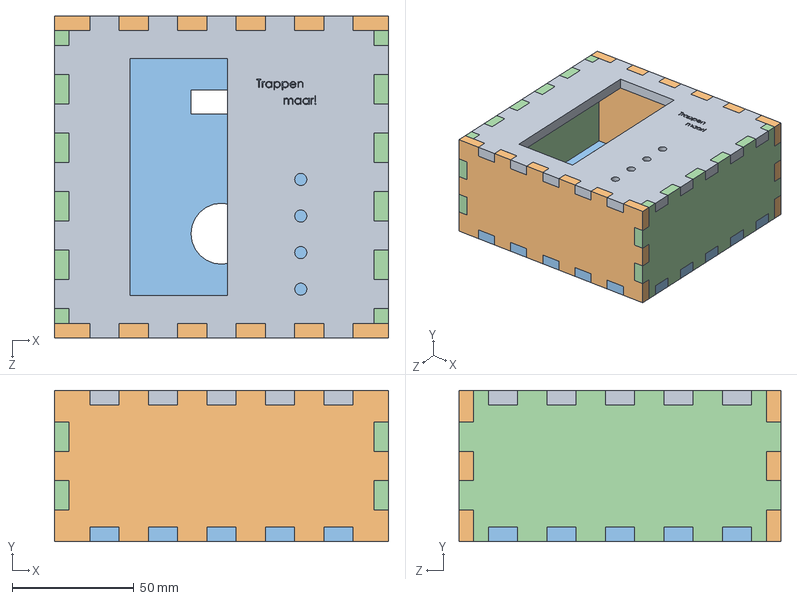
[picture p43: CAD file, 2022-05-02]
boxes/Fiets/parts + assembly/BOX.SLDASM
137.0 x 62.0 x 132.0 mm
bovenkant
korte zijkant x 2
onderkant
lange zijkant x 2
