PLAN-IT-B/BachelorProefTrappenMaar/boxes/7segmentKlein/assembly/Assem1.SLDASM

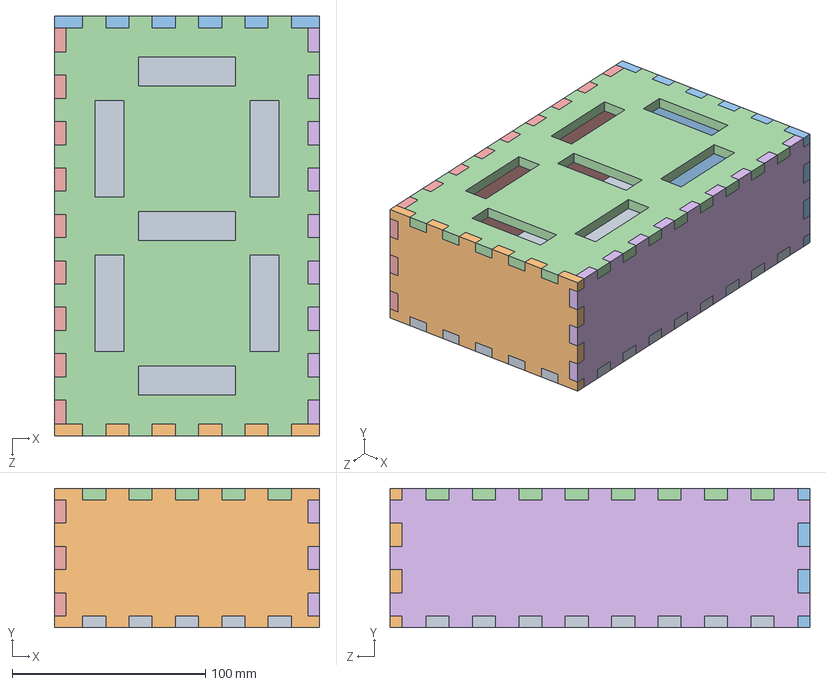
[picture p44: CAD file, 2022-05-02]
boxes/7segmentKlein/assembly/Assem1.SLDASM
137.0 x 72.0 x 217.0 mm
BOTTOM_PLANE
BACK_PLANE
TOP_PLANE
RIGHT_SIDE_PLANE
LEFT_SIDE_PLANE
