PLAN-IT-B/BachelorProefTrappenMaar/boxes/7segmentGroot/assembly/front plane in solidworks/Bovenzijde.SLDPRT

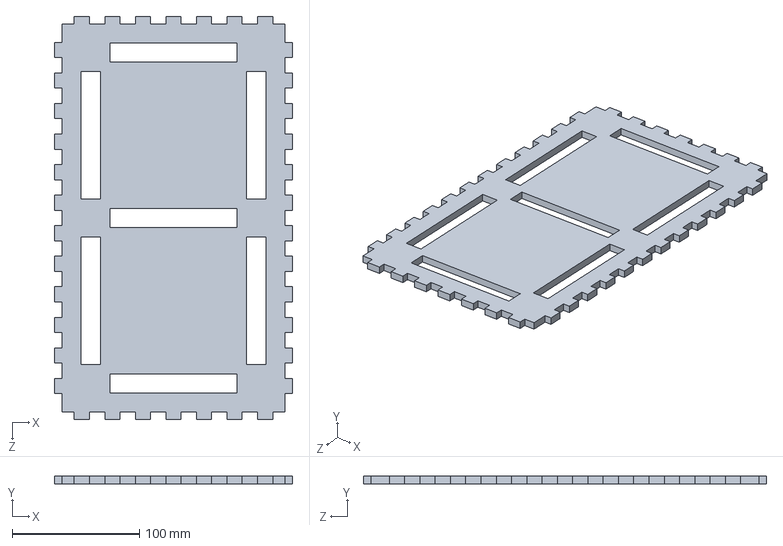
[picture p45: CAD file, 2022-04-19]
boxes/7segmentGroot/assembly/front plane in solidworks/Bovenzijde.SLDPRT
187.0 x 6.00 x 317.0 mm
