PLAN-IT-B/BachelorProefTrappenMaar/boxes/7segmentKlein/parts/hout 6mm/BACK_PLANE.SLDPRT

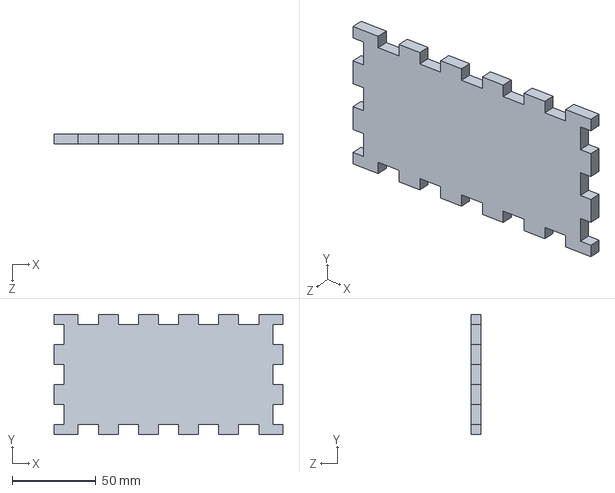
[picture p48: CAD file, 2022-05-09]
boxes/7segmentKlein/parts/hout 6mm/BACK_PLANE.SLDPRT
137.0 x 72.0 x 6.00 mm
