PLAN-IT-B/BachelorProefTrappenMaar/boxes/7segmentKlein/parts/karton 3mm/TOP_PLANE.SLDPRT

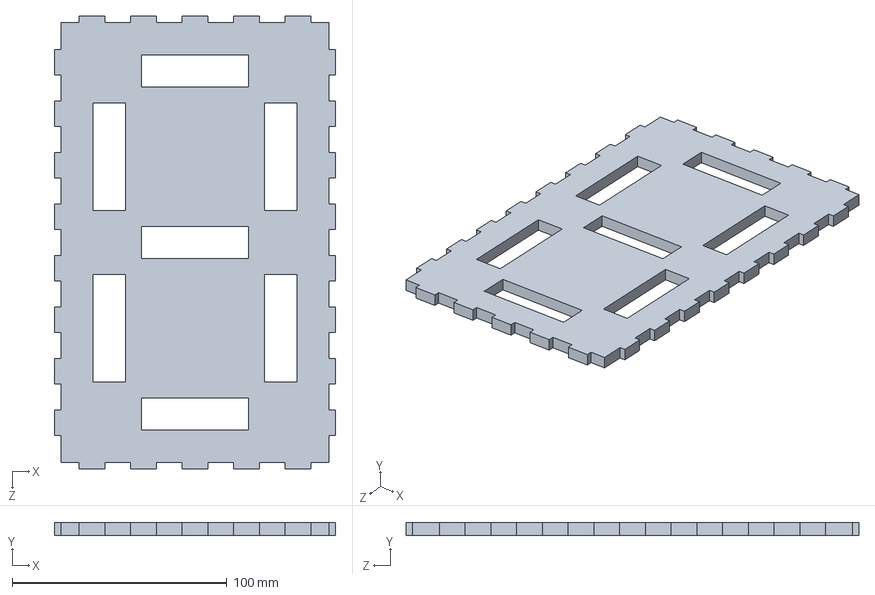
[picture p49: CAD file, 2022-05-09]
boxes/7segmentKlein/parts/karton 3mm/TOP_PLANE.SLDPRT
131.0 x 6.00 x 211.0 mm
