PLAN-IT-B/BachelorProefTrappenMaar/boxes/Buffer/hout_6mm/Parts/onderkant.SLDPRT

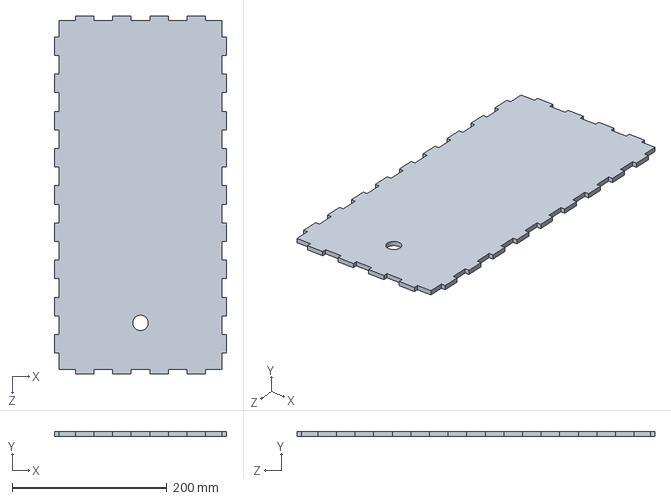
[picture p50: CAD file, 2022-05-03]
boxes/Buffer/hout_6mm/Parts/onderkant.SLDPRT
222.0 x 6.00 x 462.0 mm
