PLAN-IT-B/BachelorProefTrappenMaar/boxes/Buffer/karton_3mm/parts/voorkant.SLDPRT

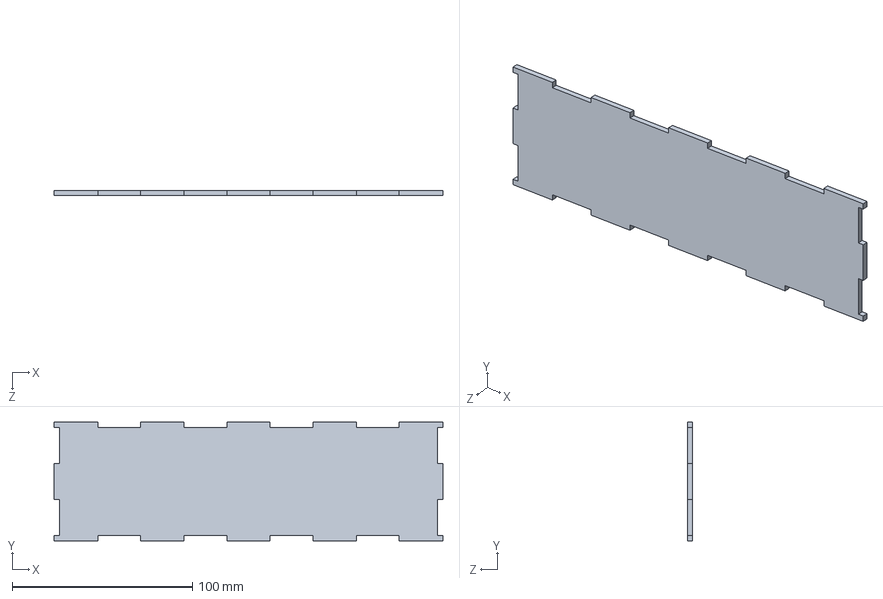
[picture p51: CAD file, 2022-05-09]
boxes/Buffer/karton_3mm/parts/voorkant.SLDPRT
216.0 x 66.0 x 3.00 mm
