PLAN-IT-B/BachelorProefTrappenMaar/boxes/Fiets/parts to lasercut (dxf)/bovenkant.DXF

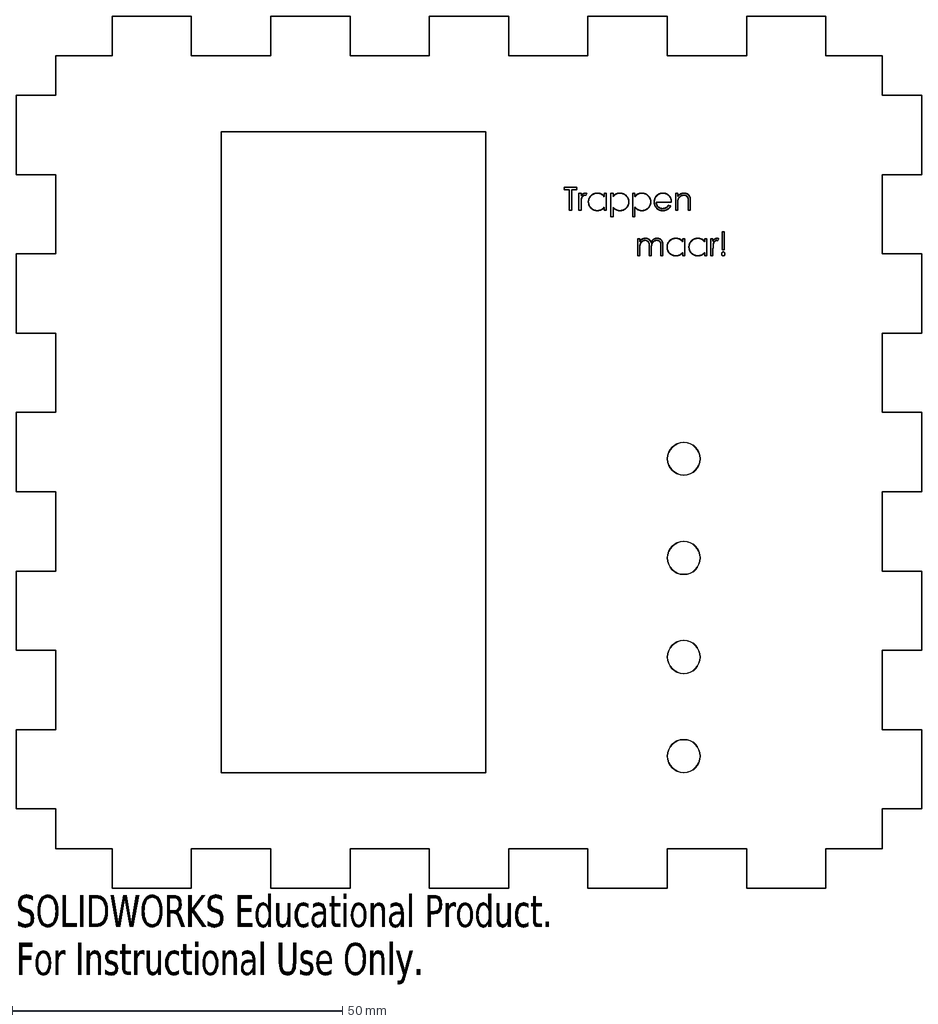
[picture p52: CAD file, 2022-05-02]
boxes/Fiets/parts to lasercut (dxf)/bovenkant.DXF
SOLIDWORKS Educational Product.
For Instructional Use Only.
