PLAN-IT-B/BachelorProefTrappenMaar/KiCad/Kicad-versie Bert/Fiets - zelfgemaakte level shifter/Fiets - zelfgemaakte level shifter/ESP32-WROOM-32_8MB_ - Copy.step

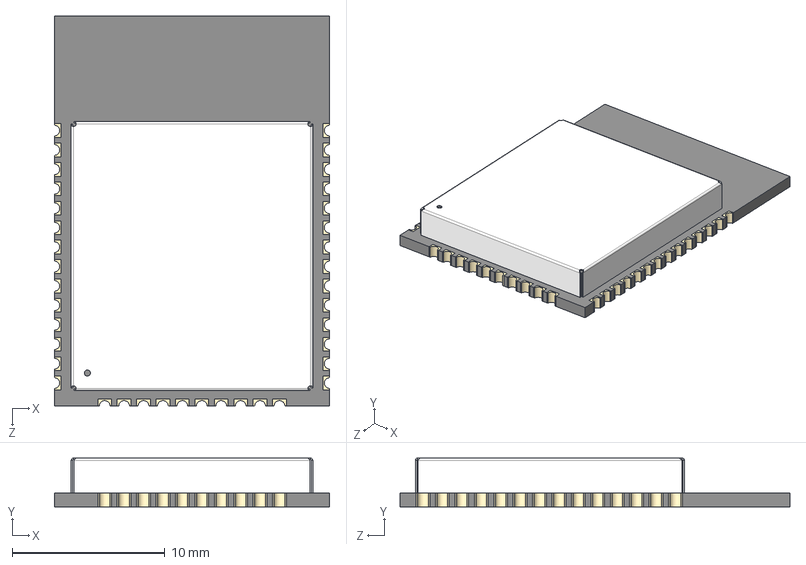
[picture p53: CAD file, 2022-04-19]
KiCad/Kicad-versie Bert/Fiets - zelfgemaakte level shifter/Fiets - zelfgemaakte level shifter/ESP32-WROOM-32_8MB_ - Copy.step
18.0 x 3.20 x 25.5 mm
