PLAN-IT-B/BachelorProefTrappenMaar/boxes/7segmentKlein/parts/hout 6mm/TOP_PLANE.SLDPRT

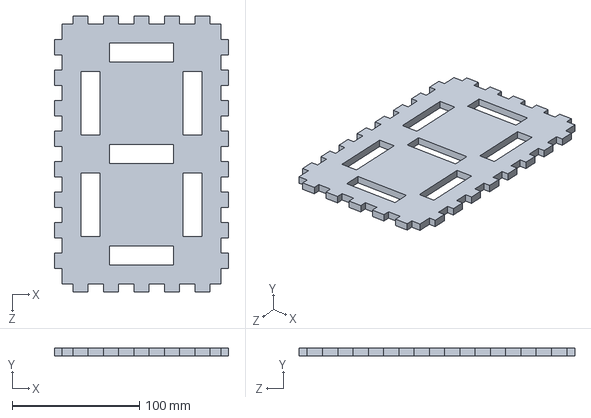
[picture p56: CAD file, 2022-05-02]
boxes/7segmentKlein/parts/hout 6mm/TOP_PLANE.SLDPRT
137.0 x 6.00 x 217.0 mm
