PLAN-IT-B/BachelorProefTrappenMaar/boxes/7segmentKlein/parts/karton 3mm/RIGHT_SIDE_PLANE.SLDPRT

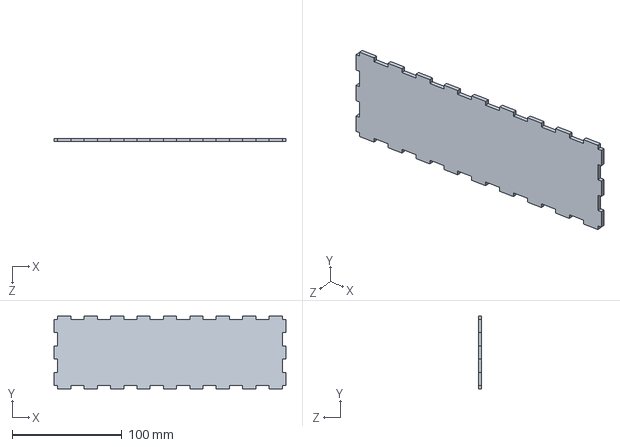
[picture p57: CAD file, 2022-05-09]
boxes/7segmentKlein/parts/karton 3mm/RIGHT_SIDE_PLANE.SLDPRT
211.0 x 66.0 x 3.00 mm
