PLAN-IT-B/BachelorProefTrappenMaar/boxes/Buffer/karton_3mm/parts/bovenkant.SLDPRT

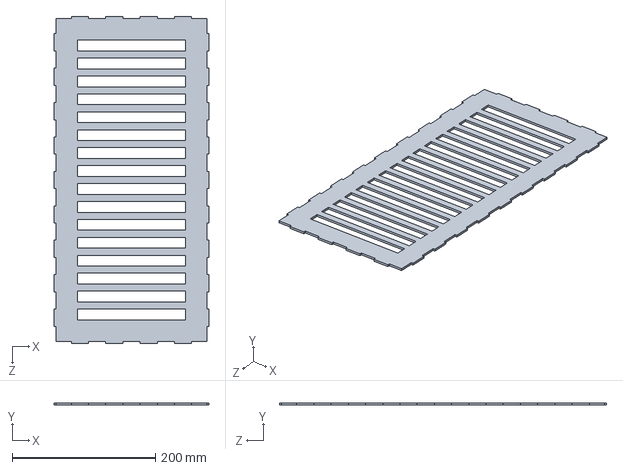
[picture p58: CAD file, 2022-05-09]
boxes/Buffer/karton_3mm/parts/bovenkant.SLDPRT
216.0 x 3.00 x 456.0 mm
