PLAN-IT-B/BachelorProefTrappenMaar/boxes/Fiets/parts + assembly/bovenkant.SLDPRT

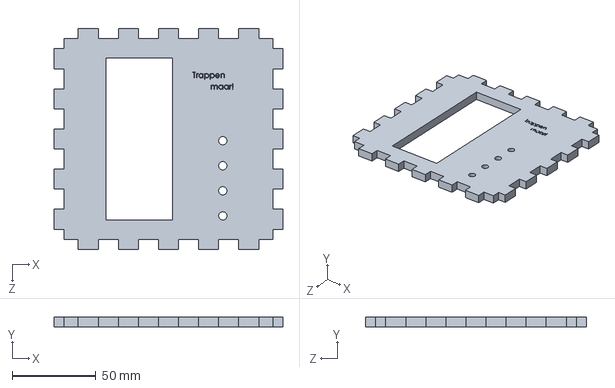
[picture p59: CAD file, 2022-05-02]
boxes/Fiets/parts + assembly/bovenkant.SLDPRT
137.0 x 6.00 x 132.0 mm
