PLAN-IT-B/BachelorProefTrappenMaar/boxes/7segmentKlein/parts/karton 3mm/FRONT_PLANE.SLDPRT

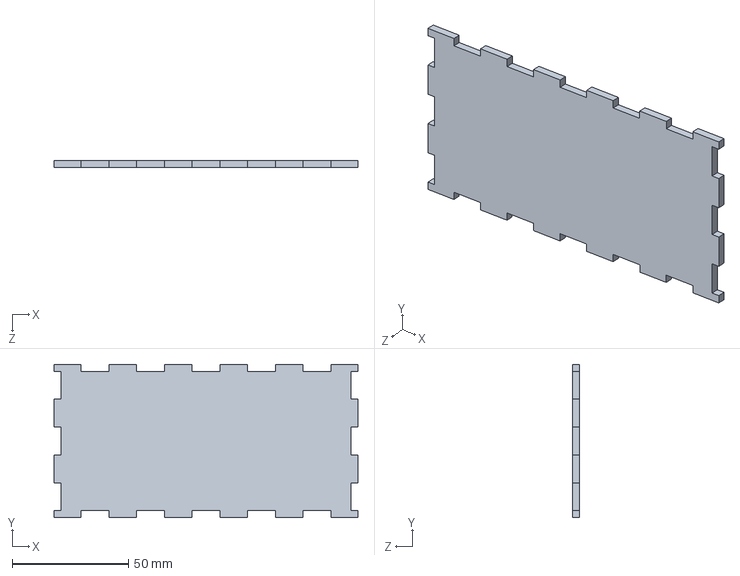
[picture p64: CAD file, 2022-05-09]
boxes/7segmentKlein/parts/karton 3mm/FRONT_PLANE.SLDPRT
131.0 x 66.0 x 3.00 mm
