PLAN-IT-B/BachelorProefTrappenMaar/boxes/Buffer/hout_6mm/Parts/bovenkant.SLDPRT

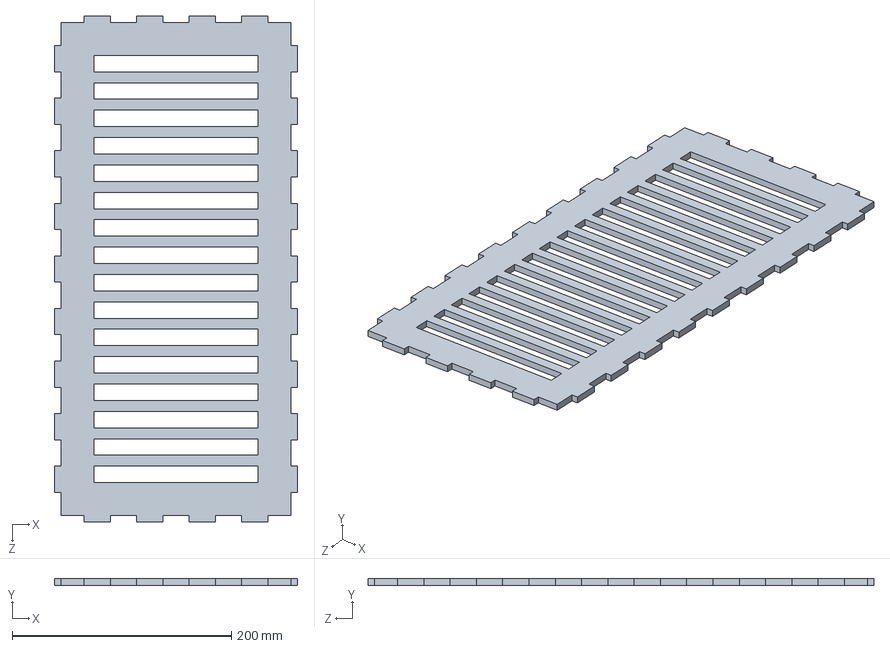
[picture p65: CAD file, 2022-05-03]
boxes/Buffer/hout_6mm/Parts/bovenkant.SLDPRT
222.0 x 6.00 x 462.0 mm
