PLAN-IT-B/BachelorProefTrappenMaar/boxes/Fiets/parts + assembly/onderkant.SLDPRT

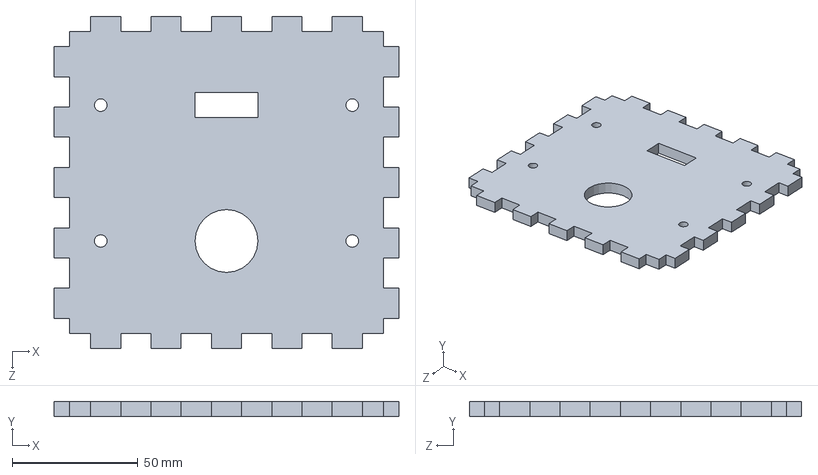
[picture p66: CAD file, 2022-05-02]
boxes/Fiets/parts + assembly/onderkant.SLDPRT
137.0 x 6.00 x 132.0 mm
