PLAN-IT-B/BachelorProefTrappenMaar/boxes/Fiets/parts to lasercut (dxf)/korte zijkant.DXF

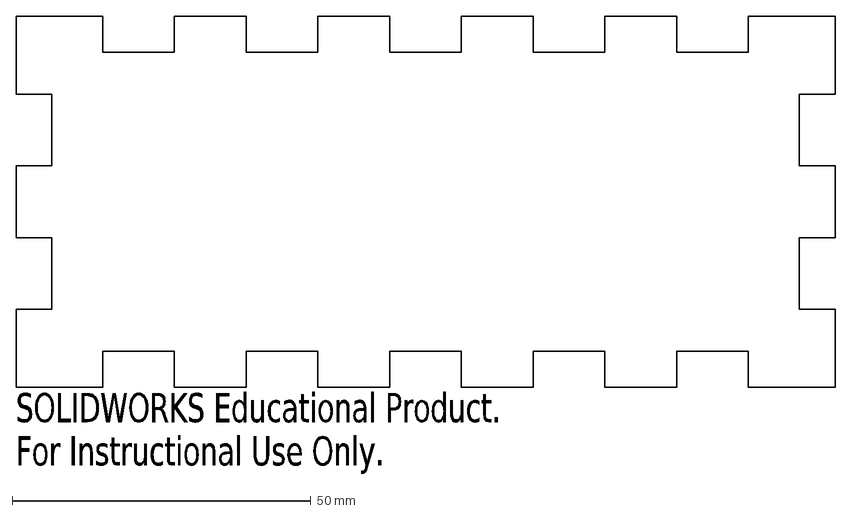
[picture p67: CAD file, 2022-05-02]
boxes/Fiets/parts to lasercut (dxf)/korte zijkant.DXF
SOLIDWORKS Educational Product.
For Instructional Use Only.
