PLAN-IT-B/BachelorProefTrappenMaar/boxes/7segmentKlein/parts/hout 6mm/RIGHT_SIDE_PLANE.SLDPRT

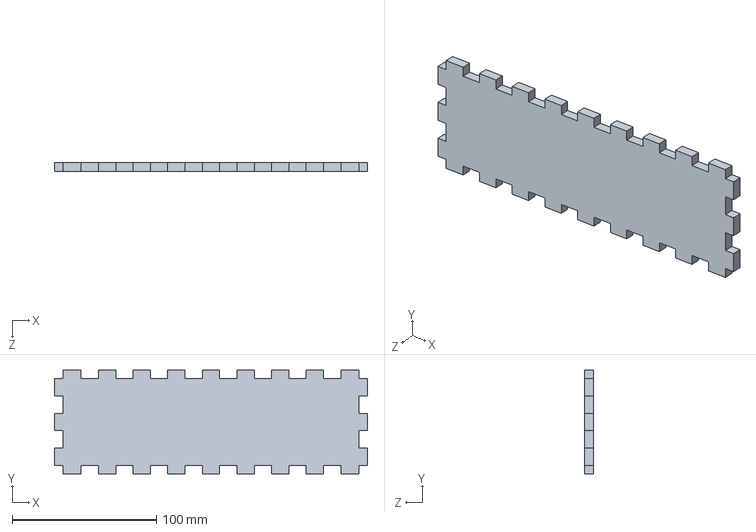
[picture p70: CAD file, 2022-05-02]
boxes/7segmentKlein/parts/hout 6mm/RIGHT_SIDE_PLANE.SLDPRT
217.0 x 72.0 x 6.00 mm
