PLAN-IT-B/BachelorProefTrappenMaar/boxes/Buffer/hout_6mm/Parts/lange_zijkant1.SLDPRT

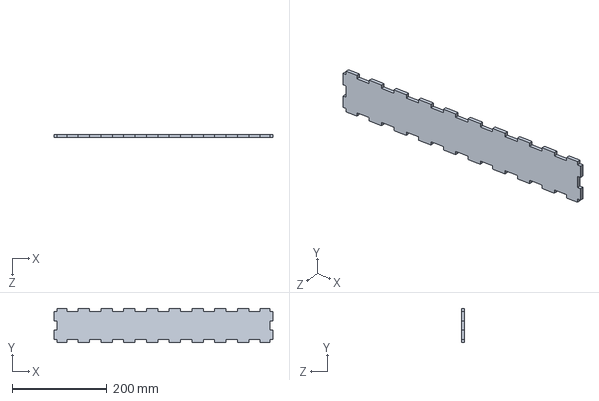
[picture p71: CAD file, 2022-05-03]
boxes/Buffer/hout_6mm/Parts/lange_zijkant1.SLDPRT
462.0 x 72.0 x 6.00 mm
