PLAN-IT-B/BachelorProefTrappenMaar/boxes/Buffer/karton_3mm/parts/lange_zijkant1.SLDPRT

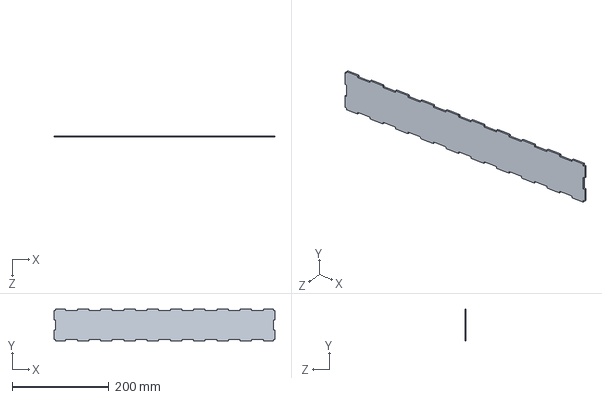
[picture p72: CAD file, 2022-05-09]
boxes/Buffer/karton_3mm/parts/lange_zijkant1.SLDPRT
456.0 x 66.0 x 3.00 mm
