PLAN-IT-B/BachelorProefTrappenMaar/boxes/Fiets/parts + assembly/korte zijkant.SLDPRT

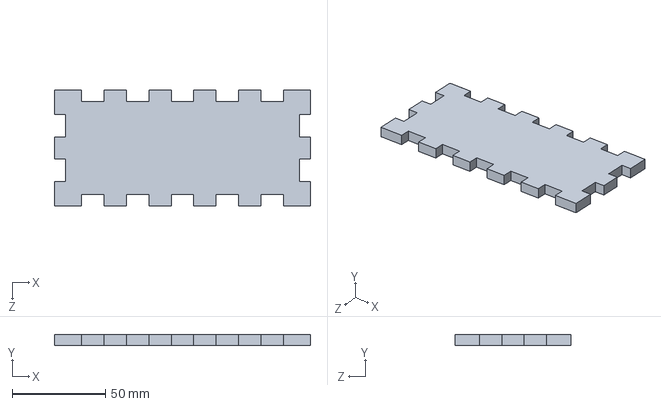
[picture p73: CAD file, 2022-04-26]
boxes/Fiets/parts + assembly/korte zijkant.SLDPRT
137.0 x 6.00 x 62.0 mm
