PLAN-IT-B/BachelorProefTrappenMaar/boxes/Fiets/parts to lasercut (dxf)/lange zijkant2.DXF

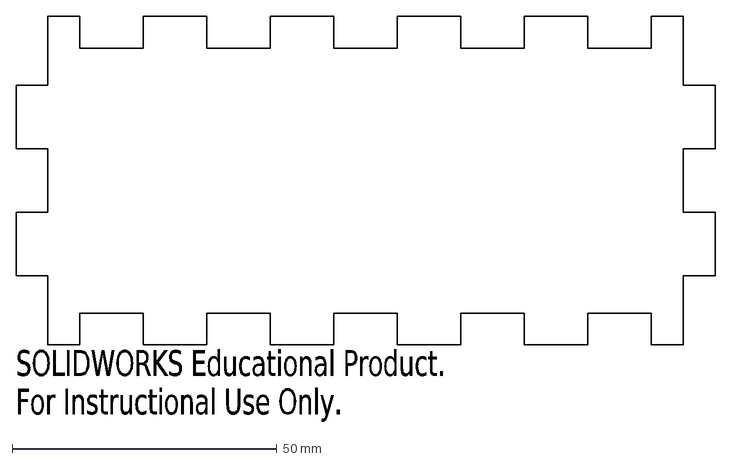
[picture p74: CAD file, 2022-05-02]
boxes/Fiets/parts to lasercut (dxf)/lange zijkant2.DXF
SOLIDWORKS Educational Product.
For Instructional Use Only.
