PLAN-IT-B/BachelorProefTrappenMaar/boxes/Fiets/parts + assembly/lange zijkant.SLDPRT

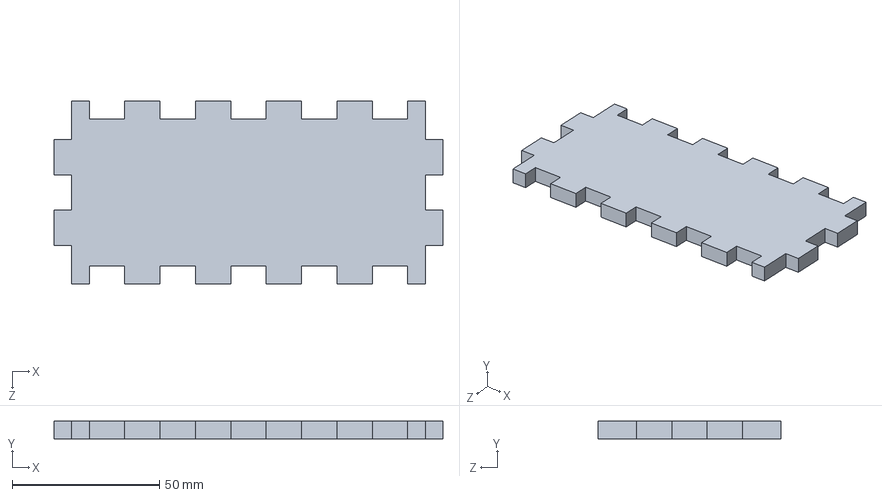
[picture p77: CAD file, 2022-04-26]
boxes/Fiets/parts + assembly/lange zijkant.SLDPRT
132.0 x 6.00 x 62.0 mm
