PLAN-IT-B/BachelorProefTrappenMaar/boxes/Fiets/parts to lasercut (dxf)/onderkant.DXF

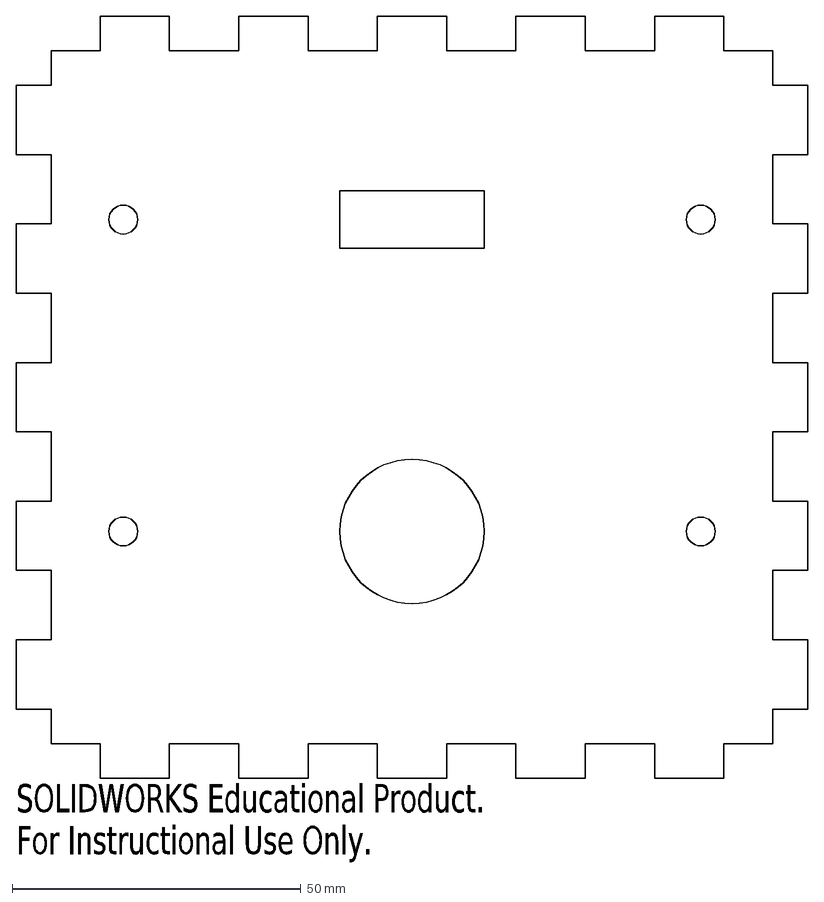
[picture p78: CAD file, 2022-05-02]
boxes/Fiets/parts to lasercut (dxf)/onderkant.DXF
SOLIDWORKS Educational Product.
For Instructional Use Only.
