PLAN-IT-B/BachelorProefTrappenMaar/boxes/7segmentKlein/parts to lasercut (dxf)/hout_6mm/RIGHT_SIDE_PLANE.DXF

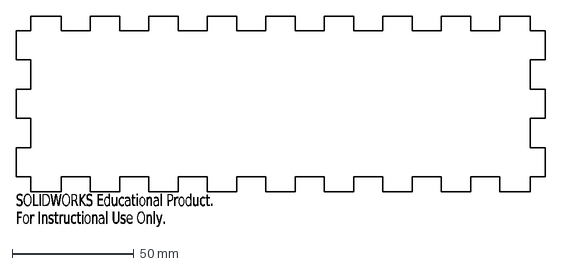
[picture p79: CAD file, 2022-05-02]
boxes/7segmentKlein/parts to lasercut (dxf)/hout_6mm/RIGHT_SIDE_PLANE.DXF
SOLIDWORKS Educational Product.
For Instructional Use Only.
