PLAN-IT-B/BachelorProefTrappenMaar/boxes/7segmentKlein/parts to lasercut (dxf)/karton_3mm/TOP_PLANE.DXF

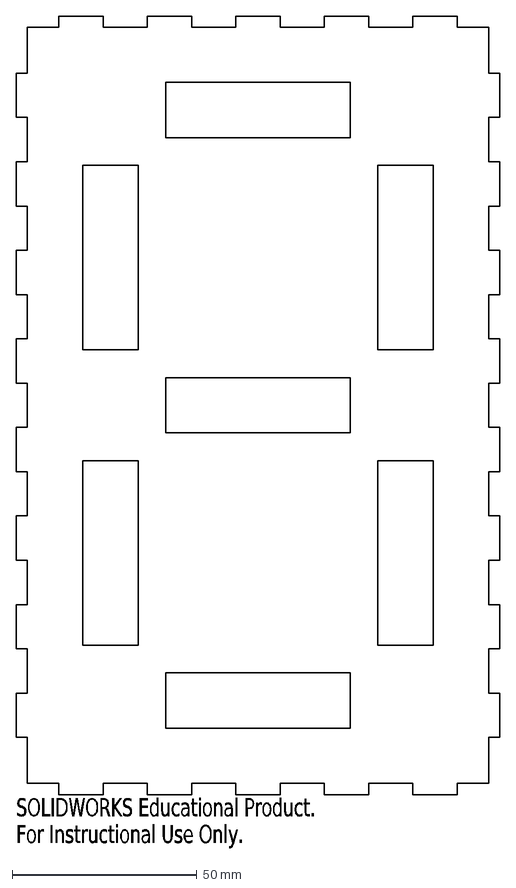
[picture p80: CAD file, 2022-05-09]
boxes/7segmentKlein/parts to lasercut (dxf)/karton_3mm/TOP_PLANE.DXF
SOLIDWORKS Educational Product.
For Instructional Use Only.
