PLAN-IT-B/BachelorProefTrappenMaar/boxes/Fiets/parts to lasercut (dxf)/lange zijkant.DXF

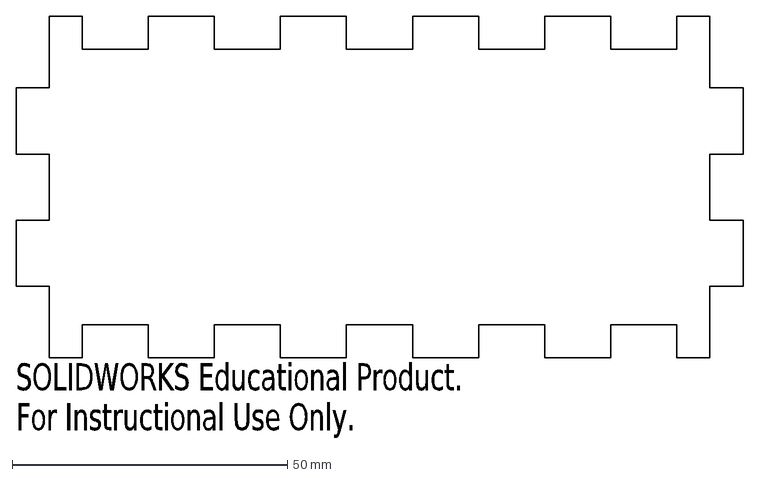
[picture p82: CAD file, 2022-05-02]
boxes/Fiets/parts to lasercut (dxf)/lange zijkant.DXF
SOLIDWORKS Educational Product.
For Instructional Use Only.
