PLAN-IT-B/BachelorProefTrappenMaar/(list of files, cad)

Other CAD files:
boxes/7segmentGroot/assembly/front plane/front plane.SLDPRT
boxes/7segmentGroot/assembly/Part4.SLDPRT
boxes/Buffer/hout_6mm/buffer_klein_doosje.dxf
boxes/Buffer/hout_6mm/Parts/voorkant.SLDPRT
boxes/7segmentGroot/assembly/Part5.SLDPRT
boxes/7segmentKlein/assembly/Part1.SLDPRT
boxes/Buffer/karton_3mm/parts/achterkant.SLDPRT
boxes/7segmentGroot/assembly/Part6.SLDPRT
boxes/7segmentKlein/parts/karton 3mm/BACK_PLANE.SLDPRT
boxes/7segmentGroot/assembly/back plane.SLDPRT
boxes/7segmentKlein/parts/hout 6mm/LEFT_SIDE_PLANE.SLDPRT
boxes/7segmentKlein/parts/karton 3mm/BOTTOM_PLANE.SLDPRT
boxes/Buffer/hout_6mm/Parts/achterkant.SLDPRT
boxes/Buffer/karton_3mm/parts/lange_zijkant2.SLDPRT
boxes/7segmentKlein/parts/hout 6mm/FRONT_PLANE.SLDPRT
boxes/7segmentKlein/parts/karton 3mm/LEFT_SIDE_PLANE.SLDPRT
boxes/Buffer/hout_6mm/Parts/lange_zijkant2.SLDPRT
boxes/7segmentGroot/parts to lasercut (dxf)/BACK_PLANE.DXF
boxes/7segmentGroot/parts to lasercut (dxf)/BOTTOM_PLANE.DXF
boxes/7segmentGroot/parts to lasercut (dxf)/FRONT_PLANE.DXF
boxes/7segmentGroot/parts to lasercut (dxf)/LEFT_SIDE_PLANE.DXF
boxes/7segmentGroot/parts to lasercut (dxf)/RIGHT_SIDE_PLANE.DXF
boxes/7segmentGroot/parts to lasercut (dxf)/TOP_PLANE.DXF
boxes/7segmentGroot/parts/BACK_PLANE.SLDPRT
boxes/7segmentGroot/parts/BOTTOM_PLANE.SLDPRT
boxes/7segmentGroot/parts/FRONT_PLANE.SLDPRT
boxes/7segmentGroot/parts/LEFT_SIDE_PLANE.SLDPRT
boxes/7segmentGroot/parts/RIGHT_SIDE_PLANE.SLDPRT
boxes/7segmentGroot/parts/TOP_PLANE.SLDPRT
boxes/Buffer/hout_6mm/dxf files/achterkant.DXF
boxes/Buffer/hout_6mm/dxf files/bovenkant.DXF
boxes/Buffer/hout_6mm/dxf files/lange_zijkant1.DXF
boxes/Buffer/hout_6mm/dxf files/lange_zijkant2.DXF
boxes/Buffer/hout_6mm/dxf files/onderkant.DXF
boxes/Buffer/hout_6mm/dxf files/voorkant.DXF
boxes/Buffer/karton_3mm/dxf files/achterkant.DXF
boxes/Buffer/karton_3mm/dxf files/bovenkant.DXF
boxes/Buffer/karton_3mm/dxf files/lange_zijkant1.DXF
boxes/Buffer/karton_3mm/dxf files/lange_zijkant2.DXF
boxes/Buffer/karton_3mm/dxf files/onderkant.DXF
boxes/Buffer/karton_3mm/dxf files/voorkant.DXF
