PLAN-IT-B/BachelorProefTrappenMaar/website/Solidworks/Assembly7Segment.png

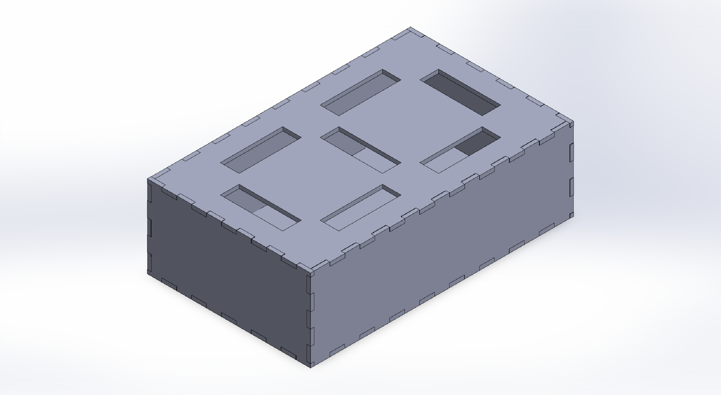
website/Solidworks/Assembly7Segment.png
