PLAN-IT-B/BachelorProefTrappenMaar/website/Solidworks/Assembly7Segment_screen.png

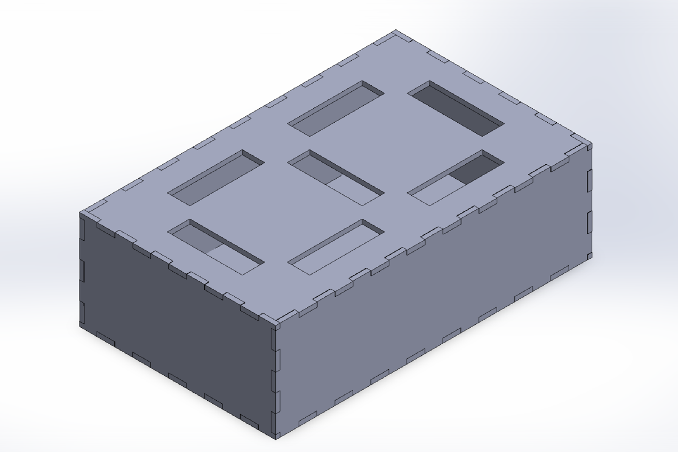
website/Solidworks/Assembly7Segment_screen.png
