PLAN-IT-B/BachelorProefTrappenMaar/website/Solidworks/AssemblyBuffer.png

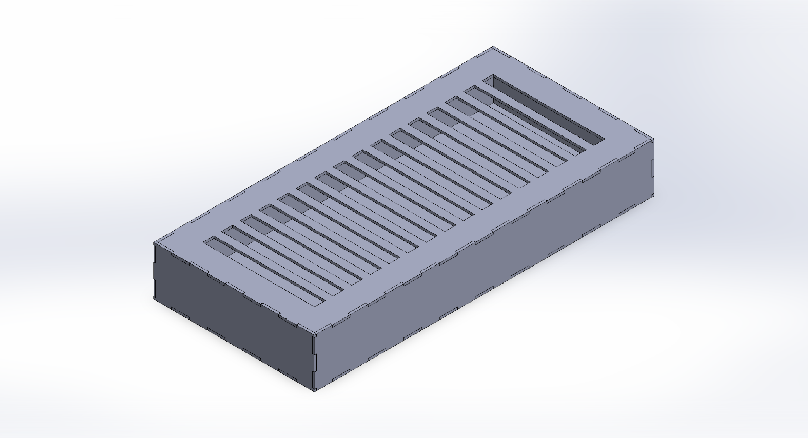
website/Solidworks/AssemblyBuffer.png
