PLAN-IT-B/BachelorProefTrappenMaar/website/Solidworks/AssemblyFiets.png

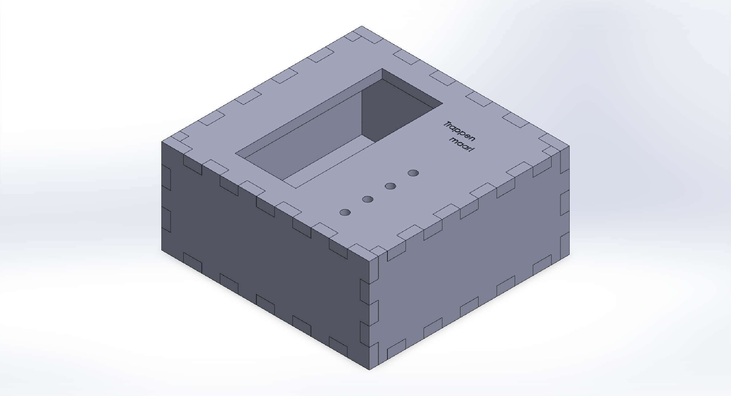
website/Solidworks/AssemblyFiets.png
