PLAN-IT-B/BachelorProefTrappenMaar/website/Kicad_screenshots/7Segment/EEschema.pdf

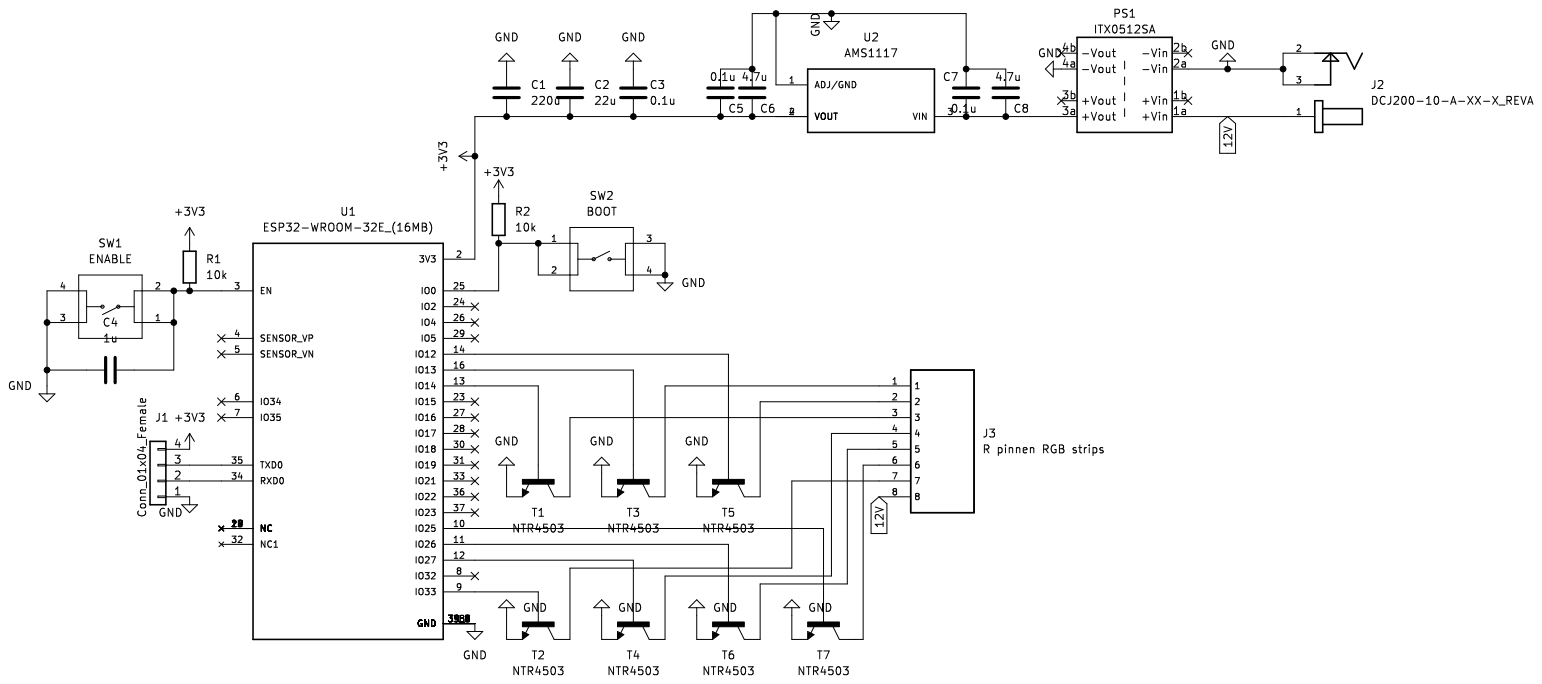
[picture p87: page 1]
