PLAN-IT-B/BachelorProefTrappenMaar/website/Kicad_screenshots/Buffer/EESchema.pdf

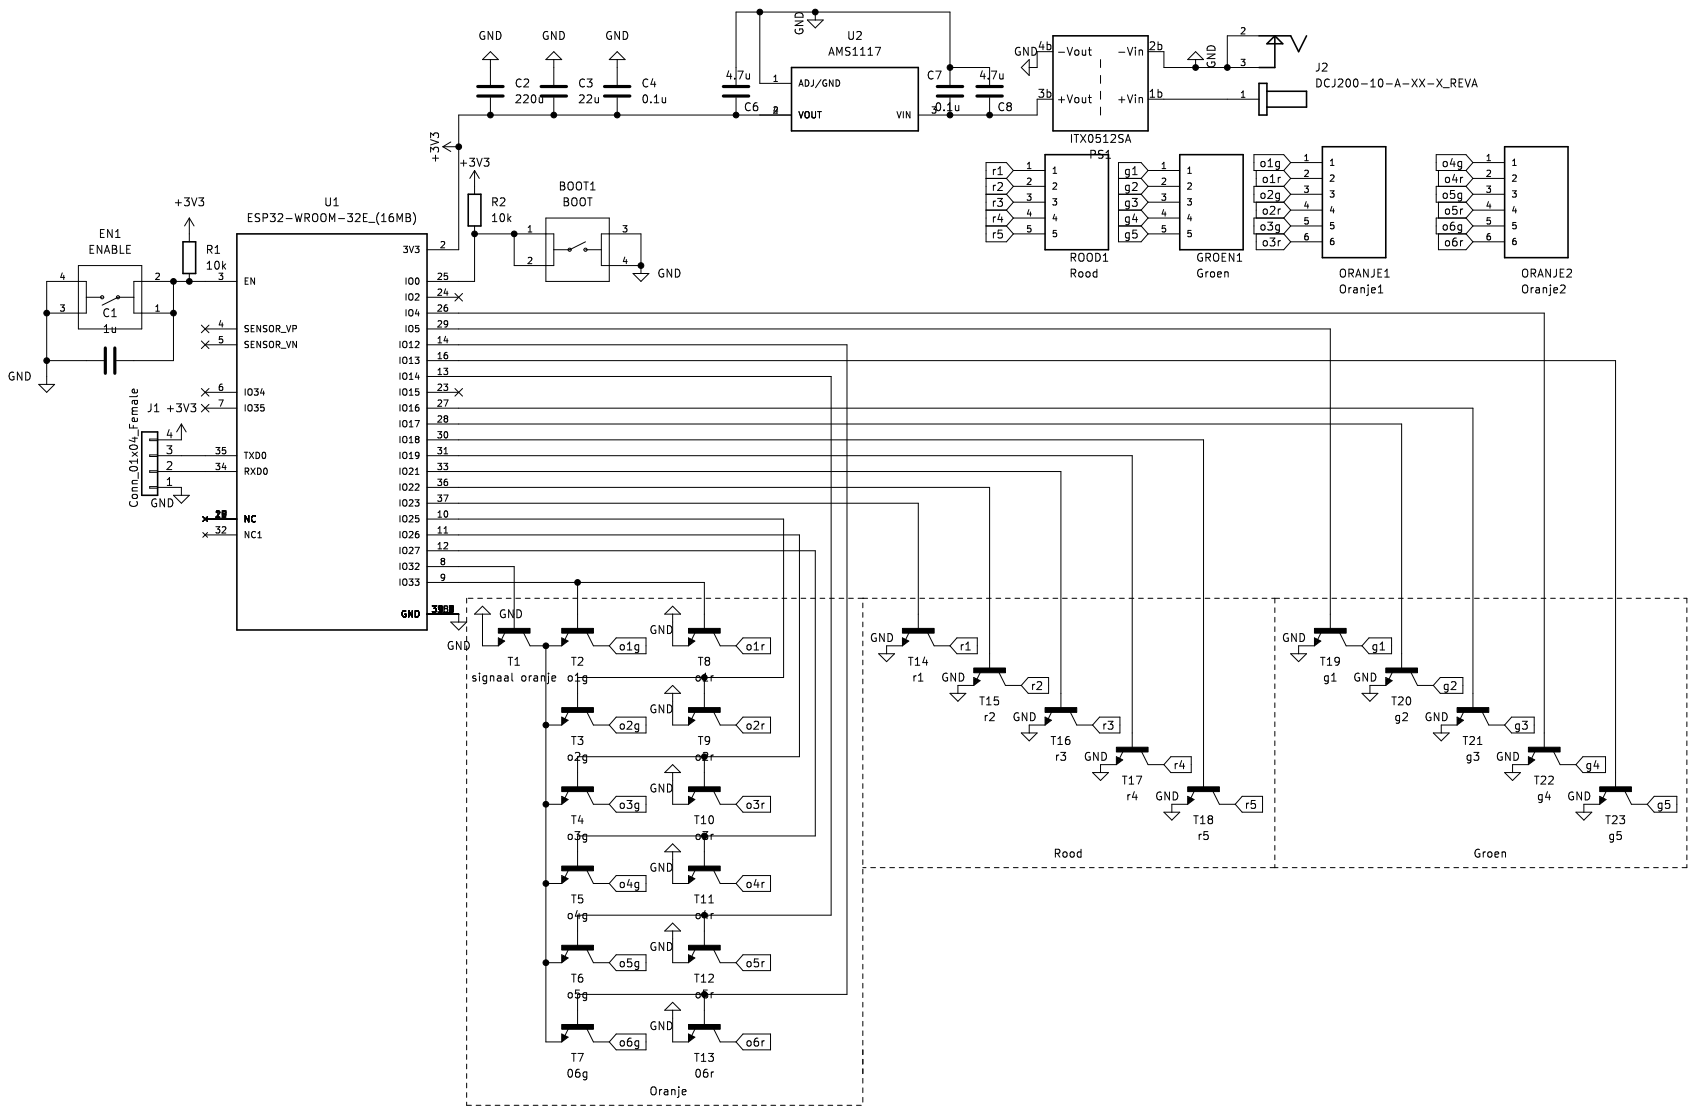
[picture p88: page 1]
