PLAN-IT-B/BachelorProefTrappenMaar/website/Kicad_screenshots/Fiets/eeschema.pdf

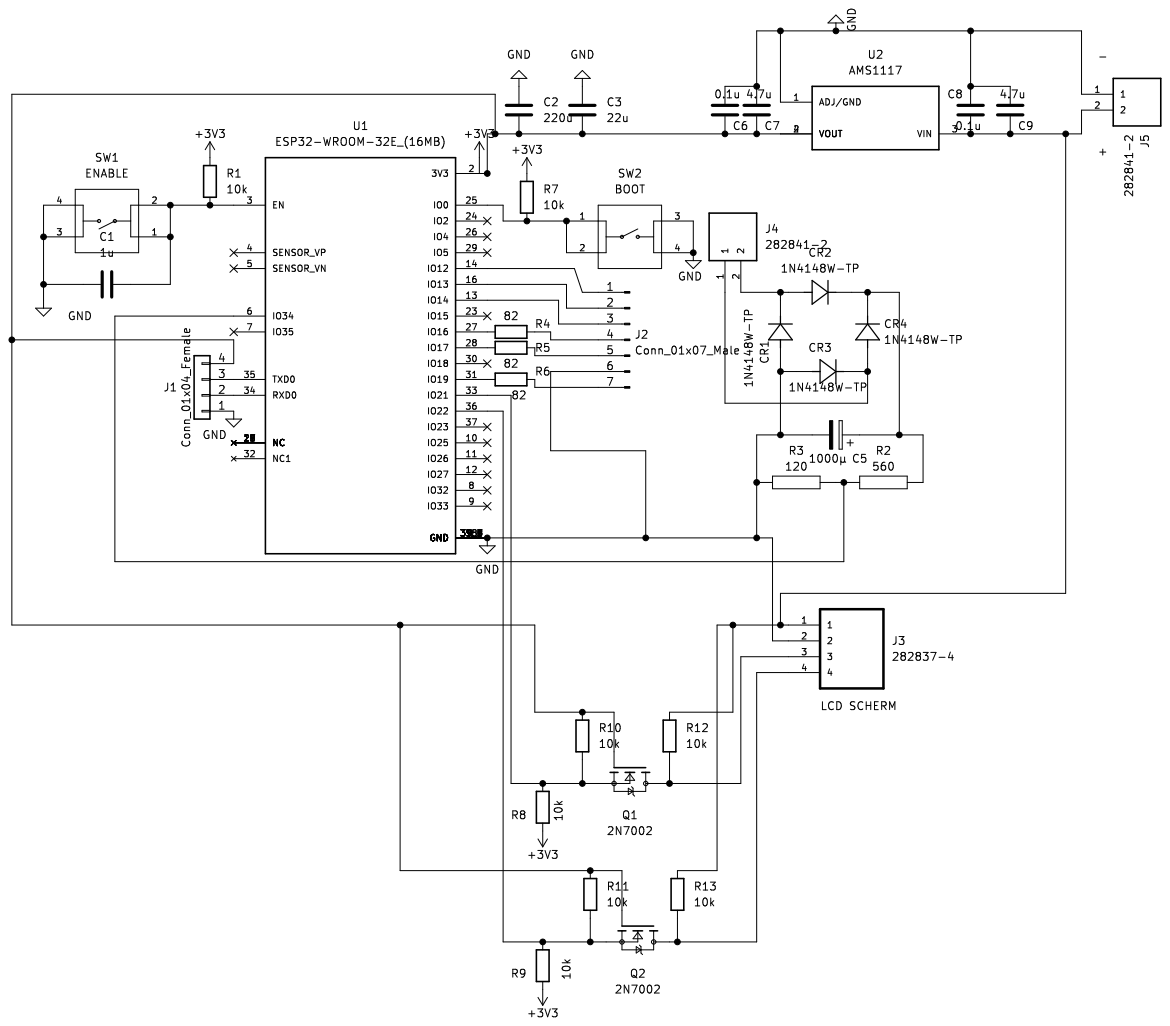
[picture p89: page 1]
