PLAN-IT-B/BachelorProefTrappenMaar/KiCad/Kicad-versie Bert/7 segment/7 segment/BCU.pdf

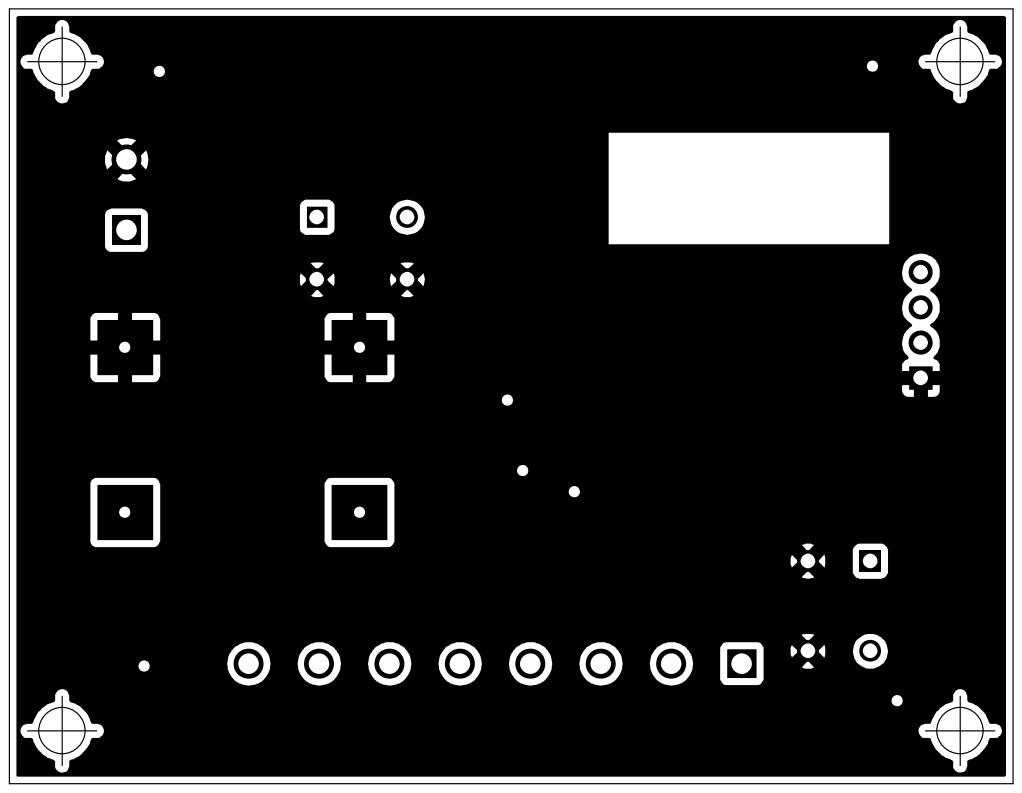
[picture p90: page 1]
