PLAN-IT-B/BachelorProefTrappenMaar/KiCad/Kicad-versie Bert/7 segment/7 segment/FCU.pdf

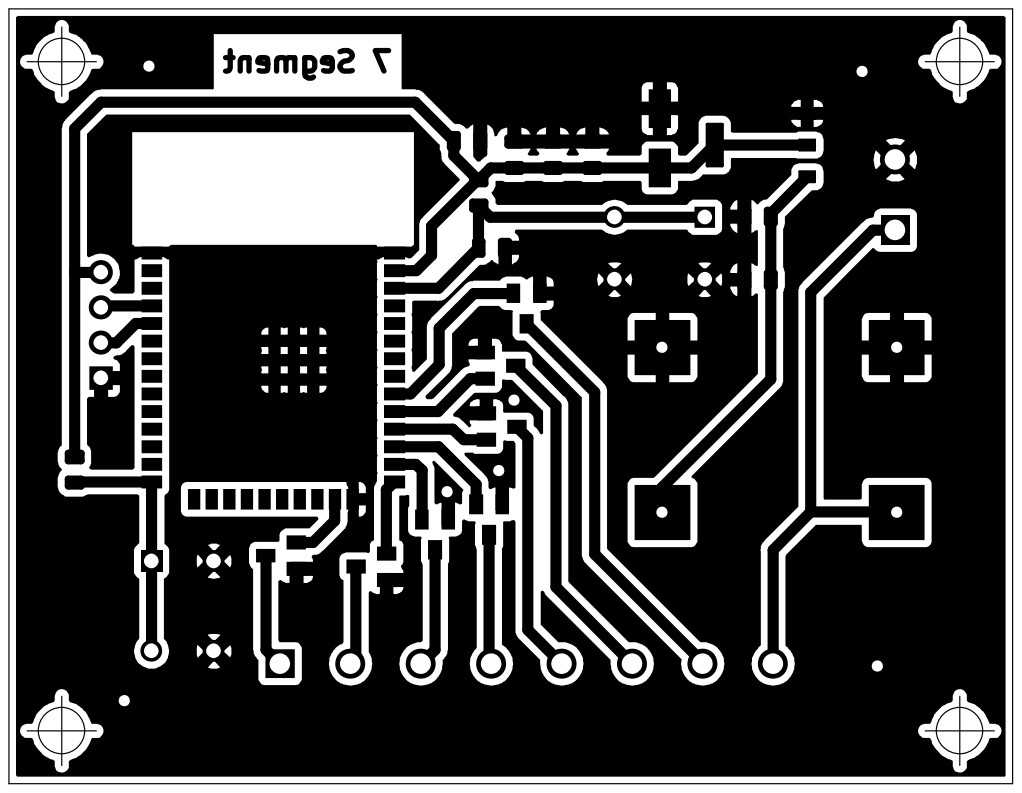
[picture p91: page 1]
