PLAN-IT-B/BachelorProefTrappenMaar/KiCad/Kicad-versie Bert/Buffer/Buffer/namen en waarden.pdf

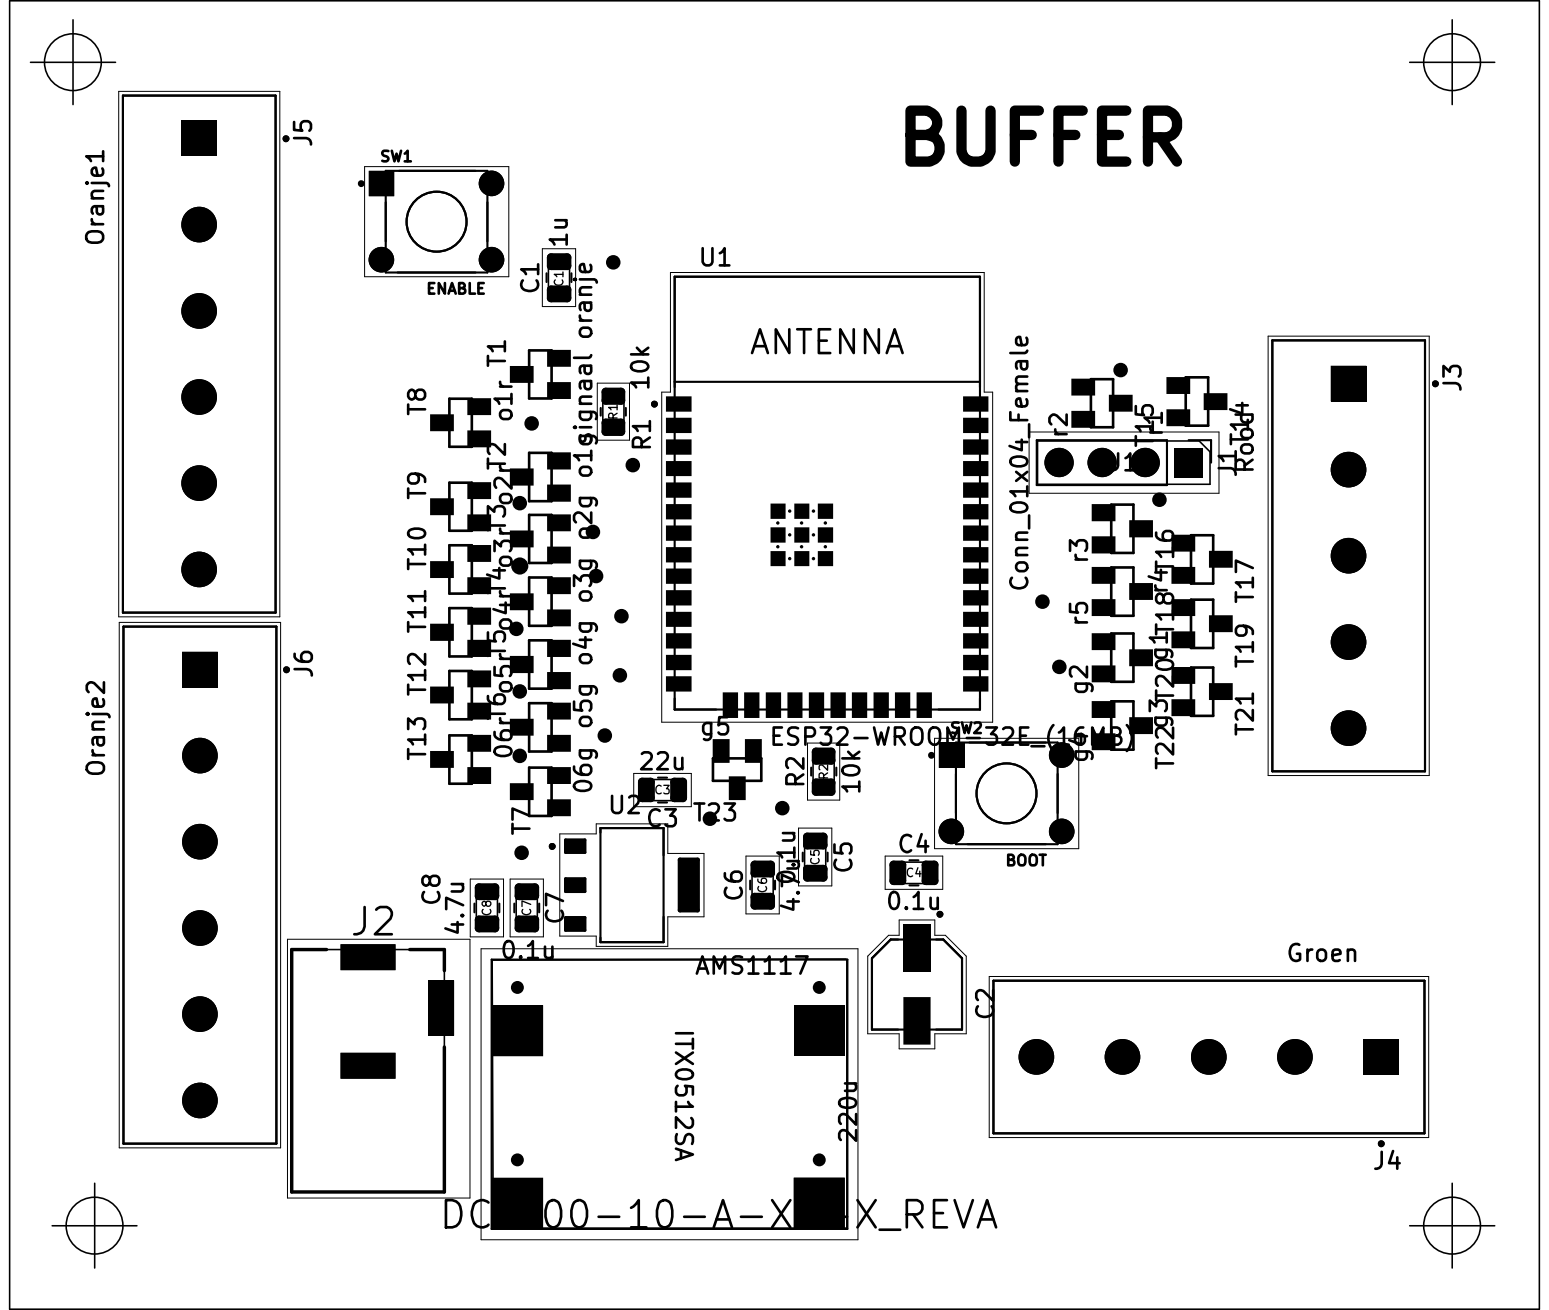
[picture p92: page 1]
