PLAN-IT-B/BachelorProefTrappenMaar/KiCad/Kicad-versie Bert/Fiets - zelfgemaakte level shifter/Fiets - zelfgemaakte level shifter/standaard.kicad_pcb

## KiCad design KiCad/Kicad-versie Bert/Fiets - zelfgemaakte level shifter/Fiets - zelfgemaakte level shifter/standaard.kicad_pcb (2022-05-15)

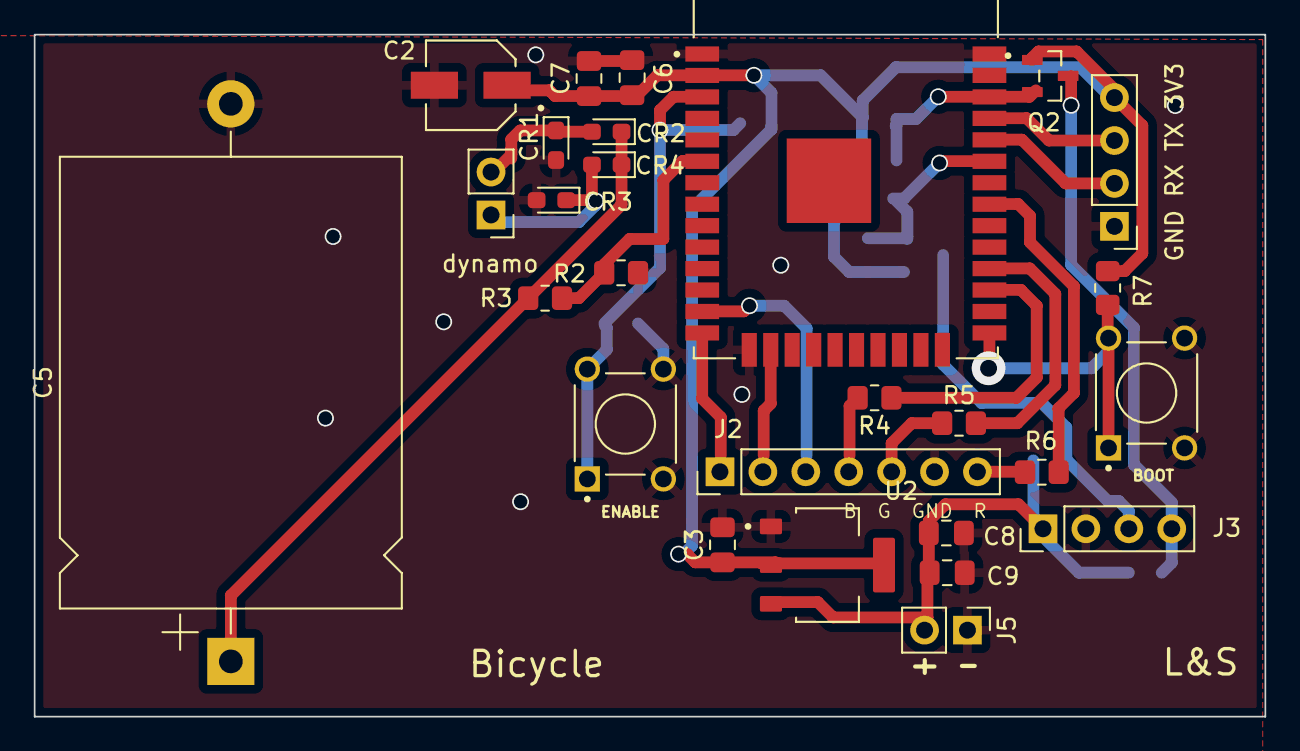
[picture p93: board standaard.kicad_pcb from above]

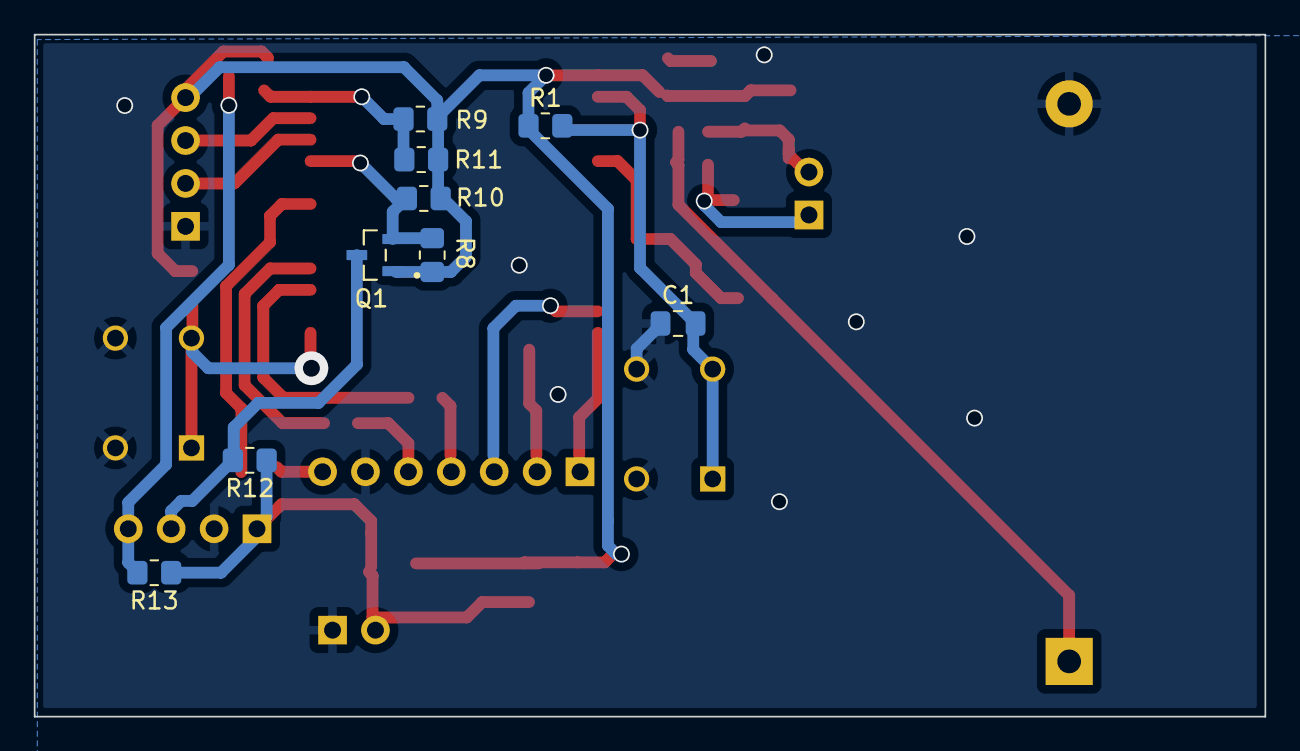
[picture p94: board standaard.kicad_pcb from below]

Board: 2 copper layers, 72.8 x 40.4 mm, 36 parts (9 on the bottom side), 24 nets.

Parts:
C1: 1u; C_0805_2012Metric_Pad1.18x1.45mm_HandSolder
C2: 220u; CAP_EEE0JA101WR
C3: 22u; C_0805_2012Metric_Pad1.18x1.45mm_HandSolder
C5: 1000µ; CP_Axial_L26.5mm_D20.0mm_P33.00mm_Horizontal
C6, C8: 0.1u; C_0805_2012Metric_Pad1.18x1.45mm_HandSolder
C7, C9: 4.7u; C_0805_2012Metric_Pad1.18x1.45mm_HandSolder
CR1, CR2, CR3, CR4: 1N4148W-TP; D_0603_1608Metric_Pad1.05x0.95mm_HandSolder
J1: Conn_01x04_Female; PinHeader_1x04_P2.54mm_Vertical
J2: Conn_01x07_Male; PinHeader_1x07_P2.54mm_Vertical
J3: 282837-4; PinHeader_1x04_P2.54mm_Vertical
J4, J5: 282841-2; PinHeader_1x02_P2.54mm_Vertical
Q1, Q2: 2N7002; SOT95P240X111-3N
R1, R7, R8, R9, R10, R11, R12, R13: 10k; R_0805_2012Metric_Pad1.20x1.40mm_HandSolder
R2: 120; R_0805_2012Metric_Pad1.20x1.40mm_HandSolder
R3: 560; R_0805_2012Metric_Pad1.20x1.40mm_HandSolder
R4, R5, R6: 82; R_0805_2012Metric_Pad1.20x1.40mm_HandSolder
SW1: ENABLE; SW_1825910-6-4
SW2: BOOT; SW_1825910-6-4
U1: ESP32-WROOM-32E_(16MB); MODULE_ESP32-WROOM-32(8MB)
U2: AMS1117; SOT229P700X180-4N

Connections:
+3V3: C2.1, C3.1, C6.1, C7.1, J1.4, Q1.1, Q2.1, R1.1, R7.1, R8.1, R9.1, R10.1, R11.1, U1.2 (3V3), U2.2 (VOUT), U2.4 (VOUT)
GND: C1.1, C2.2, C3.2, C5.2, C6.2, C7.2, C8.1, C9.2, CR1.2, CR3.2, J1.1, J2.6, J3.2, J5.1, R2.1, SW1.3, SW1.4, SW2.3, SW2.4, U1.1 (GND), U1.15 (GND), U1.38 (GND), U2.1 (ADJ/GND)
unnamed: C1.2, R1.2, SW1.1, SW1.2, U1.3 (EN)
unnamed: C5.1, CR2.1, CR4.1, R3.2
unnamed: C8.2, C9.1, J3.1, J5.2, R12.1, R13.1, U2.3 (VIN)
unnamed: CR1.1, CR2.2, J4.2
unnamed: CR3.1, CR4.2, J4.1
unnamed: J1.2, U1.34 (RXD0)
unnamed: J1.3, U1.35 (TXD0)
unnamed: J2.1, U1.14 (IO12)
unnamed: J2.2, U1.16 (IO13)
unnamed: J2.3, U1.13 (IO14)
unnamed: J2.4, R4.2
unnamed: J2.5, R5.2
unnamed: J2.7, R6.2
unnamed: J3.3, Q1.3, R12.2
unnamed: J3.4, Q2.3, R13.2
unnamed: Q1.2, R8.2, R10.2, U1.33 (IO21)
unnamed: Q2.2, R9.2, R11.2, U1.36 (IO22)
unnamed: R2.2, R3.1, U1.6 (IO34)
unnamed: R4.1, U1.27 (IO16)
unnamed: R5.1, U1.28 (IO17)
unnamed: R6.1, U1.31 (IO19)
unnamed: R7.2, SW2.1, SW2.2, U1.25 (IO0)
