PLAN-IT-B/BachelorProefTrappenMaar/KiCad/Kicad-versie Bert/7 segment/7 segment/7segments_beide_groundplane.kicad_pcb

## KiCad design KiCad/Kicad-versie Bert/7 segment/7 segment/7segments_beide_groundplane.kicad_pcb (2022-04-19)

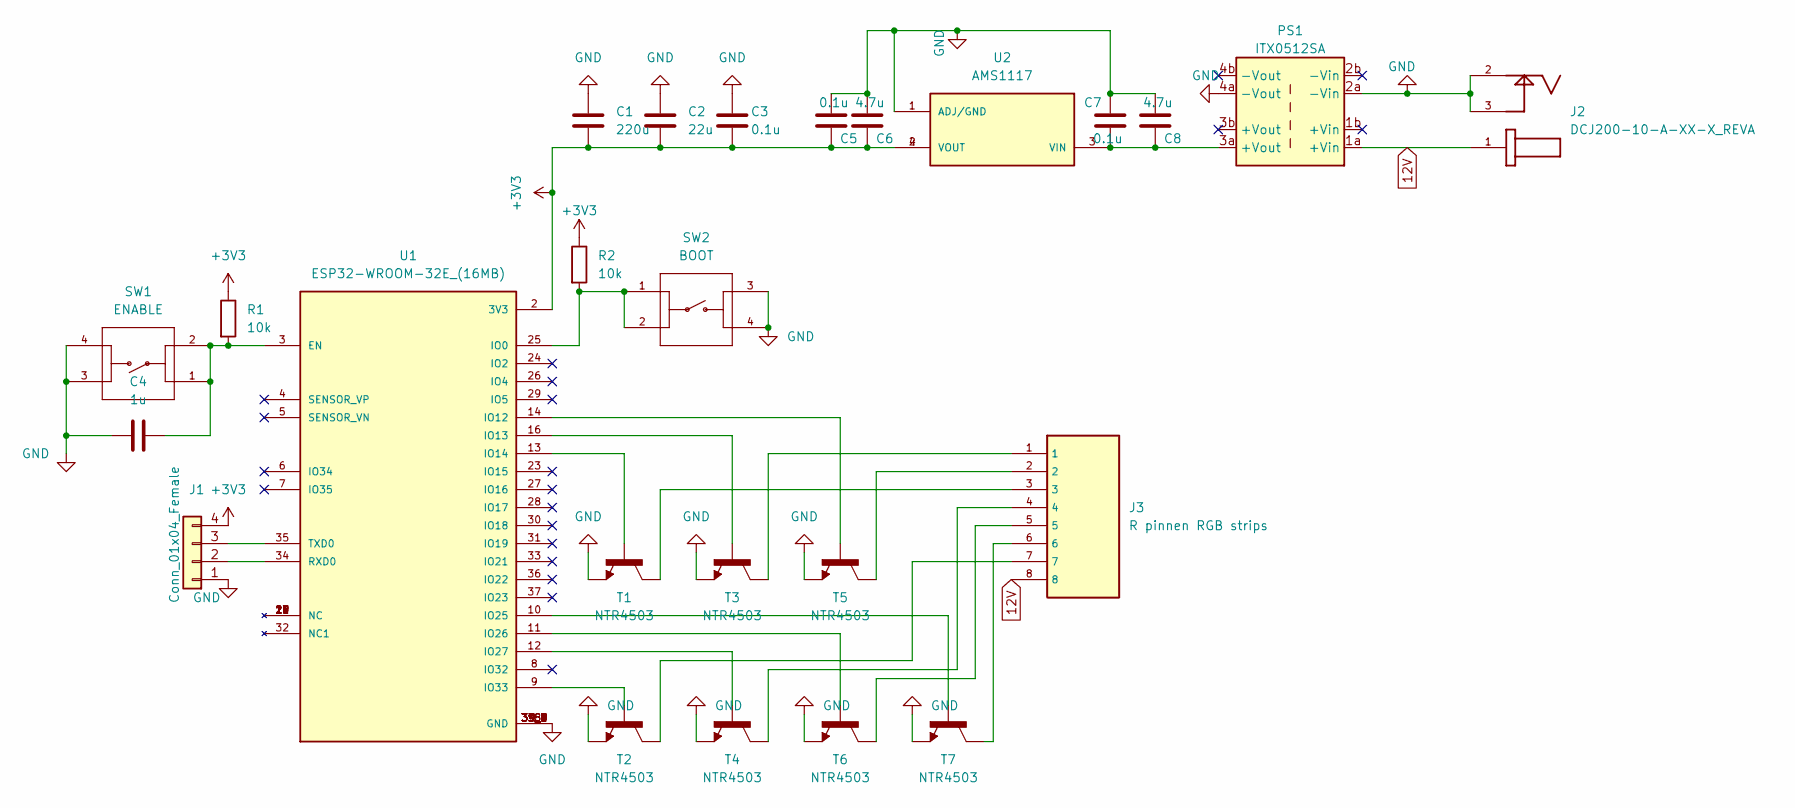
[picture p95: schematic 7segments_beide_groundplane.kicad_sch]

Parts:
C1: 220u; CAP_EEE0JA101WR
C2: 22u; C_0805_2012Metric
C3, C5, C7: 0.1u; C_0805_2012Metric
C4: 1u; C_0805_2012Metric
C6, C8: 4.7u; C_0805_2012Metric
J1: Conn_01x04_Female; PinHeader_1x04_P2.54mm_Vertical
J2: DCJ200-10-A-XX-X_REVA; GCT_DCJ200-10-A-XX-X_REVA
J3: R pinnen RGB strips; TE_1546215-8
PS1: ITX0512SA; Buck Converter
R1, R2: 10k; R_0805_2012Metric
SW1: ENABLE; SW_1825910-6-4
SW2: BOOT; SW_1825910-6-4
T1, T2, T3, T4, T5, T6, T7: NTR4503; SOT23
U1: ESP32-WROOM-32E_(16MB); XCVR_ESP32-WROOM-32E_(16MB); PARTREV 1.4
U2: AMS1117; SOT229P700X180-4N; PARTREV N/A

Connections:
12V: J2.1, J3.8, PS1.1a (+Vin)
+3V3: C1.1, C2.1, C3.1, C5.1, C6.1, J1.4, R1.1, R2.1, U1.2 (3V3), U2.2 (VOUT), U2.4 (VOUT)
GND: C1.2, C2.2, C3.2, C4.1, C5.2, C6.2, C7.1, C8.2, J1.1, J2.2, J2.3, PS1.2a (-Vin), PS1.4a (-Vout), SW1.3, SW1.4, SW2.3, SW2.4, T1.2, T2.2, T3.2, T4.2, T5.2, T6.2, T7.2, U1.1 (GND), U1.15 (GND), U1.38 (GND), U1.39_1 (GND), U1.39_2 (GND), U1.39_3 (GND), U1.39_4 (GND), U1.39_5 (GND), U1.39_6 (GND), U1.39_7 (GND), U1.39_8 (GND), U1.39_9 (GND), U2.1 (ADJ/GND); also elsewhere on the board
unnamed 3: C4.2, R1.2, SW1.1, SW1.2, U1.3 (EN); also elsewhere on the board
unnamed: C7.2, C8.1, PS1.3a (+Vout), U2.3 (VIN)
unnamed: J1.2, U1.34 (RXD0)
unnamed: J1.3, U1.35 (TXD0)
unnamed: J3.1, T3.3
unnamed: J3.2, T5.3
unnamed: J3.3, T1.3
unnamed: J3.4, T4.3
unnamed: J3.5, T6.3
unnamed: J3.6, T7.3
unnamed: J3.7, T2.3
unnamed 14: R2.2, SW2.1, SW2.2, U1.25 (IO0); also elsewhere on the board
unnamed: T1.1, U1.13 (IO14)
unnamed: T2.1, U1.9 (IO33)
unnamed: T3.1, U1.16 (IO13)
unnamed: T4.1, U1.12 (IO27)
unnamed: T5.1, U1.14 (IO12)
unnamed: T6.1, U1.11 (IO26)
unnamed: T7.1, U1.10 (IO25)

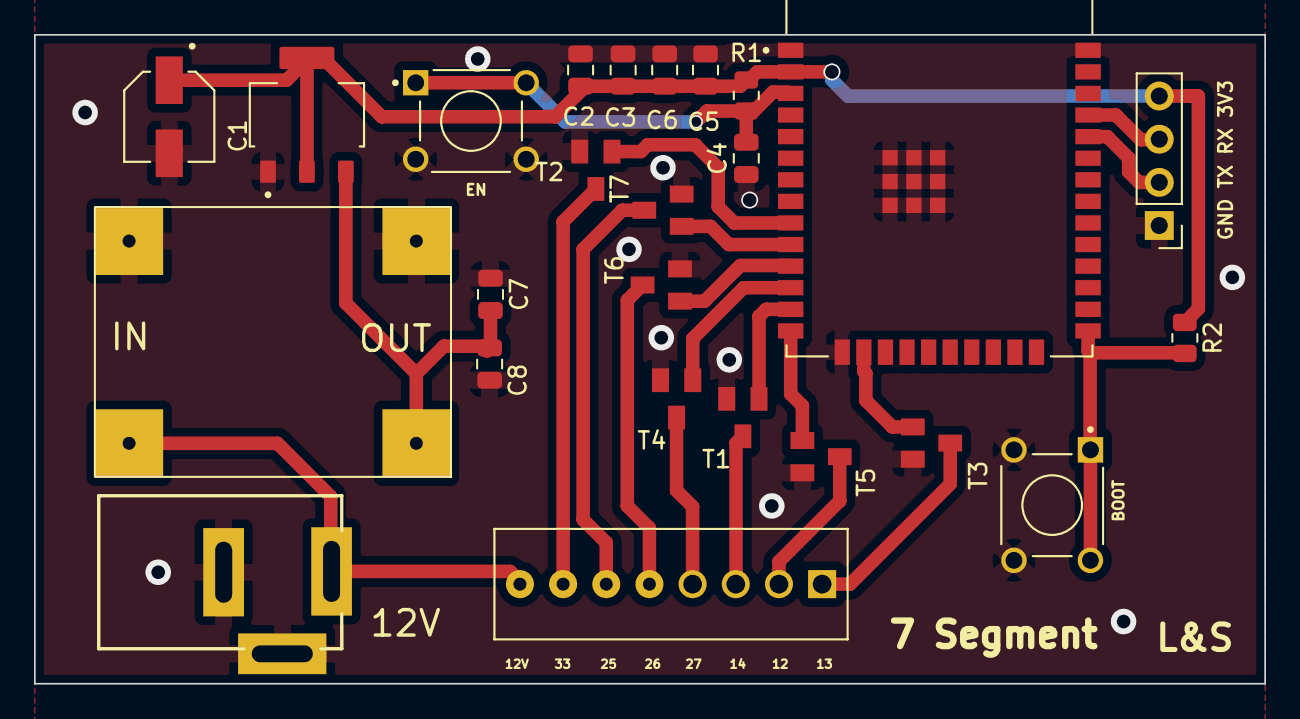
[picture p96: board 7segments_beide_groundplane.kicad_pcb from above]

Board: 2 copper layers, 72.4 x 38.2 mm, 25 parts (0 on the bottom side), 22 nets.

Other parts of the board:
BOOT: BOOT; SW_1825910-6-4
EN: ENABLE; SW_1825910-6-4

Their connections:
GND: BOOT.3, BOOT.4, EN.3, EN.4; also elsewhere on the board
unnamed 3: EN.1, EN.2; also elsewhere on the board
unnamed 14: BOOT.1, BOOT.2; also elsewhere on the board
