PLAN-IT-B/BachelorProefTrappenMaar/KiCad/Kicad-versie Bert/Buffer/Buffer/hernieuwdeBuffer_beide_groundplane.kicad_pcb

## KiCad design KiCad/Kicad-versie Bert/Buffer/Buffer/hernieuwdeBuffer_beide_groundplane.kicad_pcb (2022-04-19)

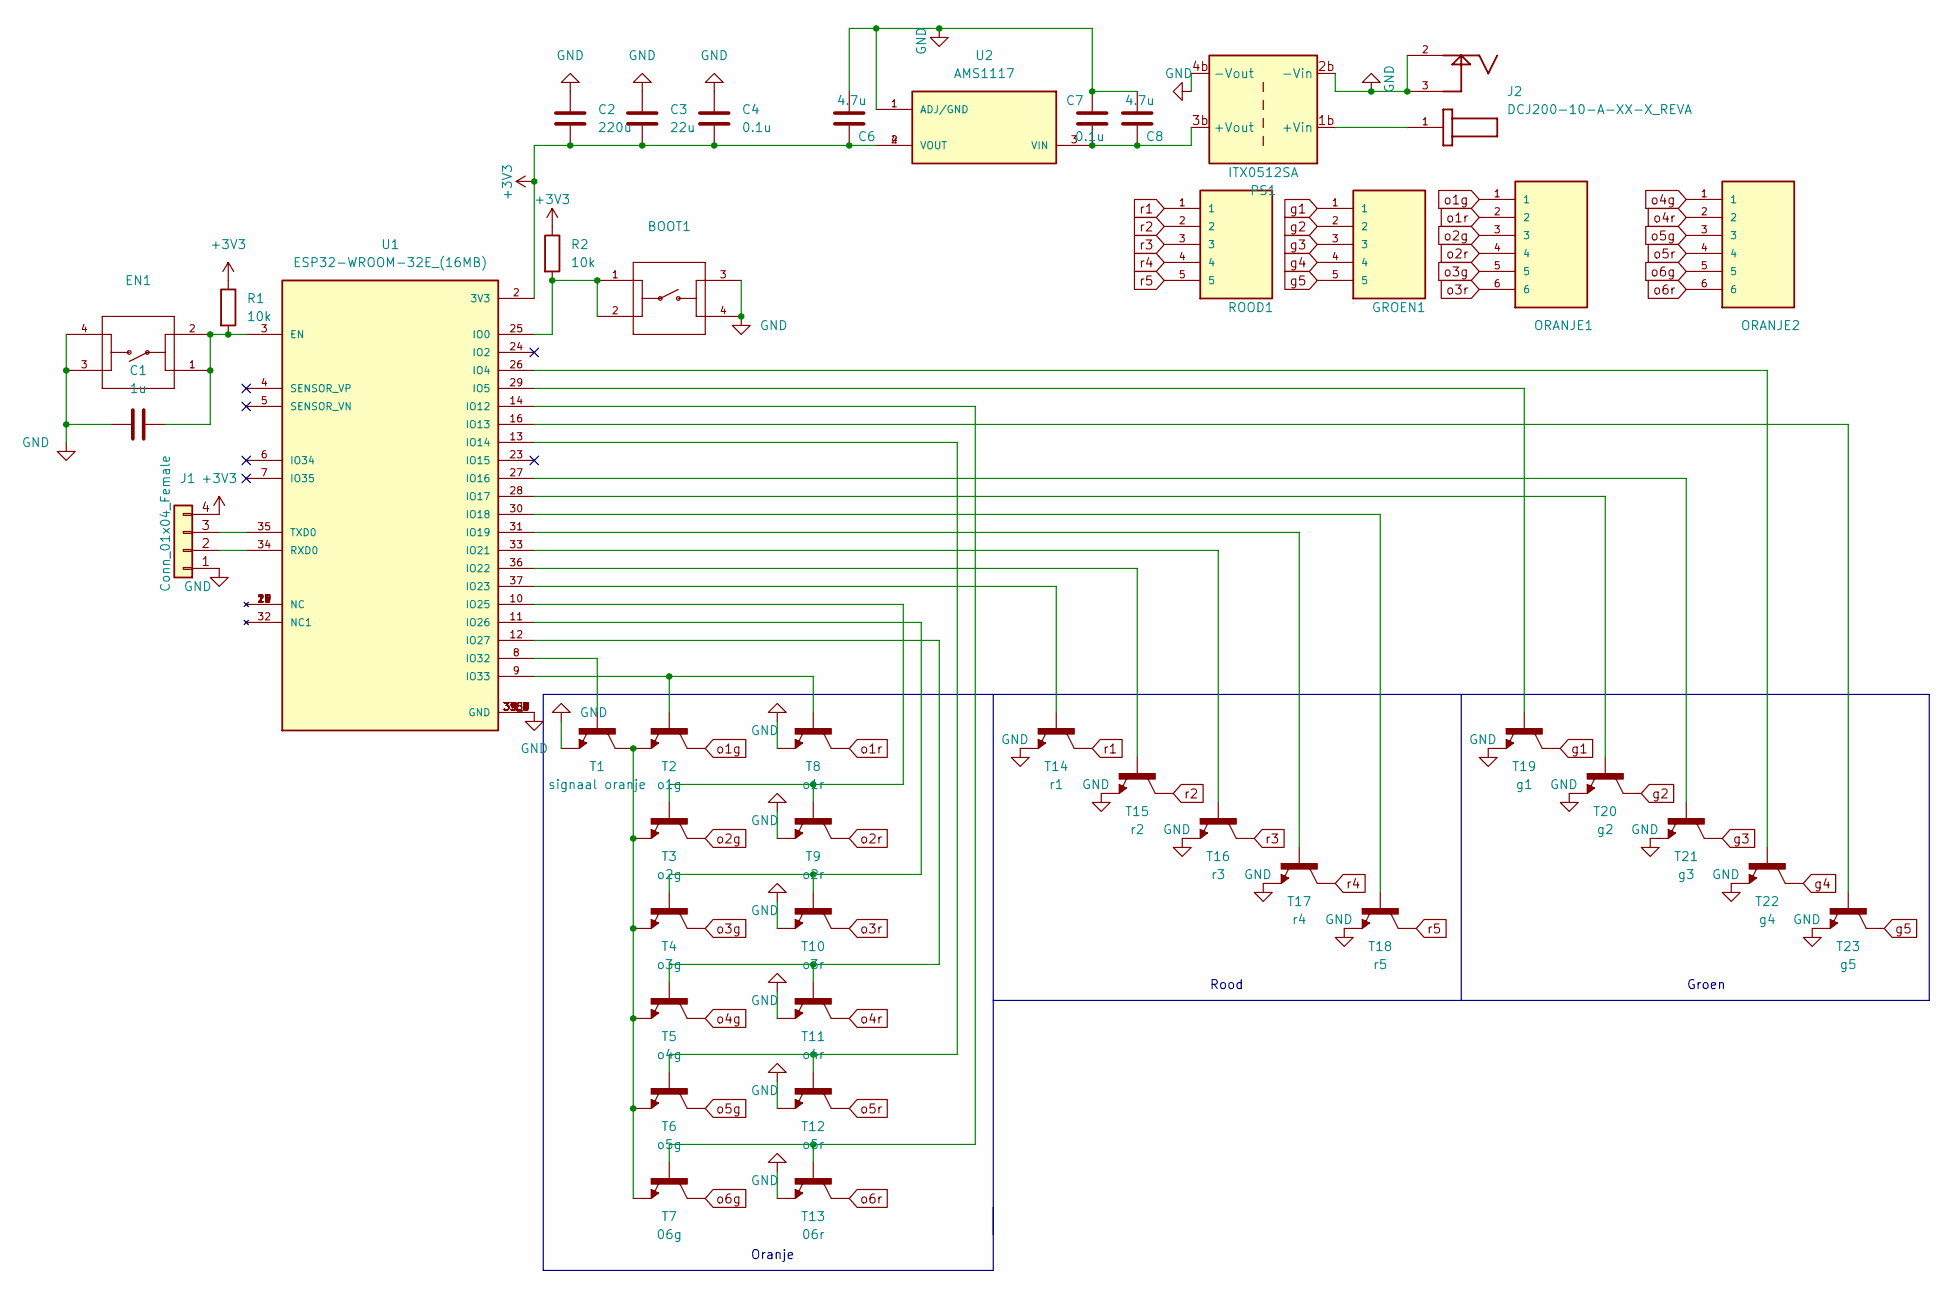
[picture p97: schematic hernieuwdeBuffer_beide_groundplane.kicad_sch]

Parts:
BOOT1: (no value)
C1: 1u; C_0805_2012Metric
C2: 220u; CAP_EEE0JA101WR
C3: 22u; C_0805_2012Metric
C4, C7: 0.1u; C_0805_2012Metric
C6, C8: 4.7u; C_0805_2012Metric
EN1: (no value)
GROEN1: (no value)
J1: Conn_01x04_Female; PinHeader_1x04_P2.54mm_Vertical
J2: DCJ200-10-A-XX-X_REVA; GCT_DCJ200-10-A-XX-X_REVA
ORANJE1, ORANJE2: (no value)
PS1: ITX0512SA; Buck Converter
R1, R2: 10k; R_0805_2012Metric
ROOD1: (no value)
T1: signaal oranje; SOT23
T2: o1g; SOT23
T3: o2g; SOT23
T4: o3g; SOT23
T5: o4g; SOT23
T6: o5g; SOT23
T7: 06g; SOT23
T8: o1r; SOT23
T9: o2r; SOT23
T10: o3r; SOT23
T11: o4r; SOT23
T12: o5r; SOT23
T13: 06r; SOT23
T14: r1; SOT23
T15: r2; SOT23
T16: r3; SOT23
T17: r4; SOT23
T18: r5; SOT23
T19: g1; SOT23
T20: g2; SOT23
T21: g3; SOT23
T22: g4; SOT23
T23: g5; SOT23
U1: ESP32-WROOM-32E_(16MB); XCVR_ESP32-WROOM-32E_(16MB); PARTREV 1.4
U2: AMS1117; SOT229P700X180-4N; PARTREV N/A

Connections:
+3V3: C2.1, C3.1, C4.1, C6.1, J1.4, R1.1, R2.1, U1.2 (3V3), U2.2 (VOUT), U2.4 (VOUT)
GND: BOOT1.3, BOOT1.4, C1.1, C2.2, C3.2, C4.2, C6.2, C7.1, C8.2, EN1.3, EN1.4, J1.1, J2.2, J2.3, PS1.2b (-Vin), PS1.4b (-Vout), T1.2, T8.2, T9.2, T10.2, T11.2, T12.2, T13.2, T14.2, T15.2, T16.2, T17.2, T18.2, T19.2, T20.2, T21.2, T22.2, T23.2, U1.1 (GND), U1.15 (GND), U1.38 (GND), U1.39_1 (GND), U1.39_2 (GND), U1.39_3 (GND), U1.39_4 (GND), U1.39_5 (GND), U1.39_6 (GND), U1.39_7 (GND), U1.39_8 (GND), U1.39_9 (GND), U2.1 (ADJ/GND)
unnamed: C1.2, EN1.1, EN1.2, R1.2, U1.3 (EN)
unnamed: C7.2, C8.1, PS1.3b (+Vout), U2.3 (VIN)
unnamed: J1.2, U1.34 (RXD0)
unnamed: J1.3, U1.35 (TXD0)
unnamed: J2.1, PS1.1b (+Vin)
unnamed: BOOT1.1, BOOT1.2, R2.2, U1.25 (IO0)
unnamed: T1.1, U1.8 (IO32)
unnamed: T1.3, T2.2, T3.2, T4.2, T5.2, T6.2, T7.2
unnamed: T2.1, T8.1, U1.9 (IO33)
unnamed: T3.1, T9.1, U1.10 (IO25)
unnamed: T4.1, T10.1, U1.11 (IO26)
unnamed: T5.1, T11.1, U1.12 (IO27)
unnamed: T6.1, T12.1, U1.13 (IO14)
unnamed: T7.1, T13.1, U1.14 (IO12)
unnamed: T14.1, U1.37 (IO23)
unnamed: T15.1, U1.36 (IO22)
unnamed: T16.1, U1.33 (IO21)
unnamed: T17.1, U1.31 (IO19)
unnamed: T18.1, U1.30 (IO18)
unnamed: T19.1, U1.29 (IO5)
unnamed: T20.1, U1.28 (IO17)
unnamed: T21.1, U1.27 (IO16)
unnamed: T22.1, U1.26 (IO4)
unnamed: T23.1, U1.16 (IO13)
g1: GROEN1.1, T19.3
g2: GROEN1.2, T20.3
g3: GROEN1.3, T21.3
g4: GROEN1.4, T22.3
g5: GROEN1.5, T23.3
o1g: ORANJE1.1, T2.3
o1r: ORANJE1.2, T8.3
o2g: ORANJE1.3, T3.3
o2r: ORANJE1.4, T9.3
o3g: ORANJE1.5, T4.3
o3r: ORANJE1.6, T10.3
o4g: ORANJE2.1, T5.3
o4r: ORANJE2.2, T11.3
o5g: ORANJE2.3, T6.3
o5r: ORANJE2.4, T12.3
o6g: ORANJE2.5, T7.3
o6r: ORANJE2.6, T13.3
r1: ROOD1.1, T14.3
r2: ROOD1.2, T15.3
r3: ROOD1.3, T16.3
r4: ROOD1.4, T17.3
r5: ROOD1.5, T18.3

Notes on the sheet:
Oranje
Groen
Rood

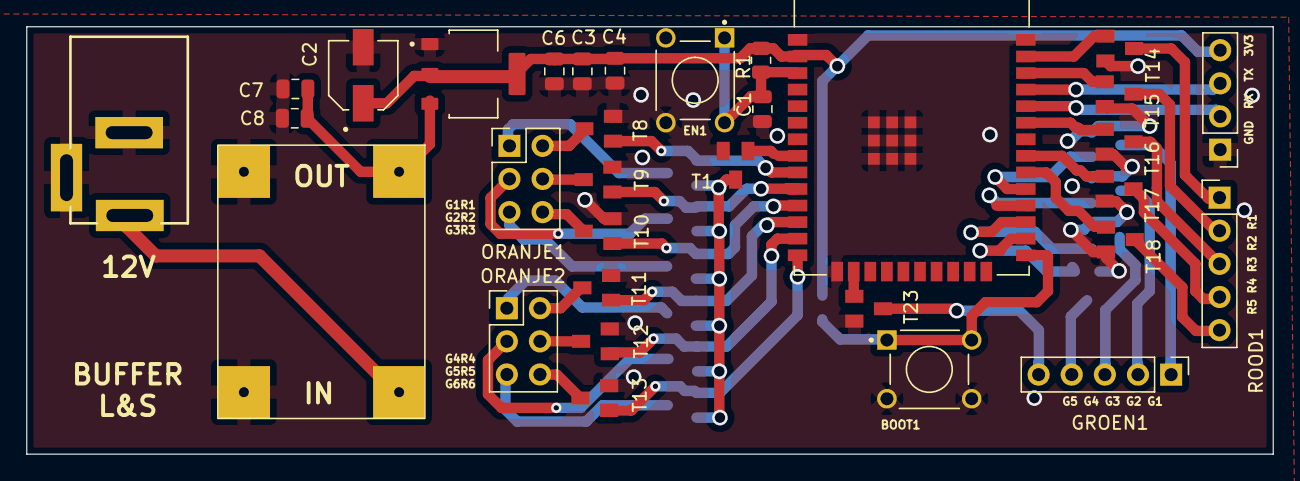
[picture p98: board hernieuwdeBuffer_beide_groundplane.kicad_pcb from above]

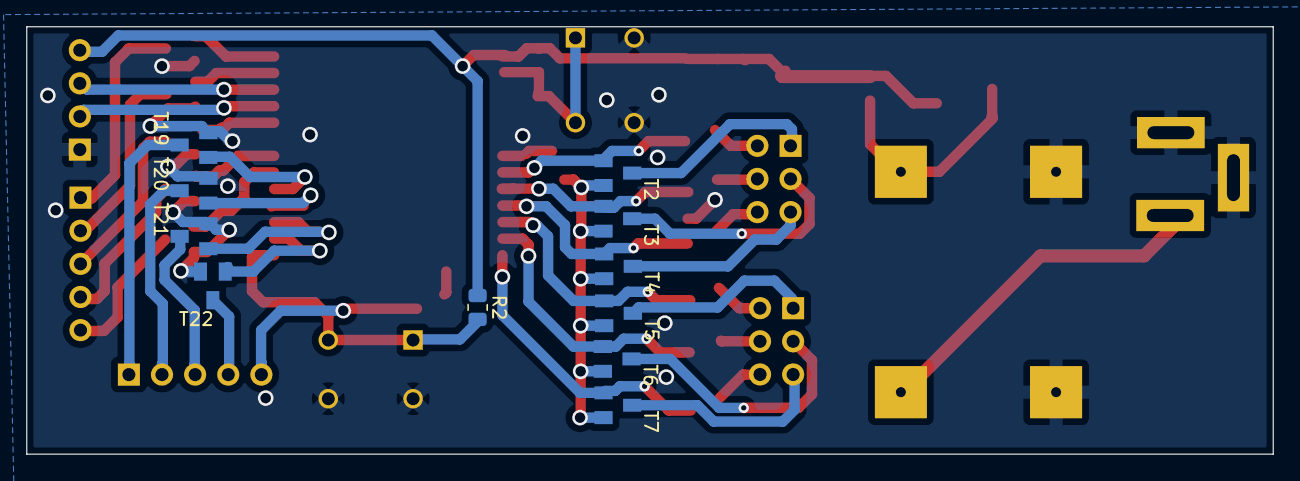
[picture p99: board hernieuwdeBuffer_beide_groundplane.kicad_pcb from below]

Board: 2 copper layers, 95.6 x 32.8 mm, 43 parts (11 on the bottom side), 48 nets.
