PLAN-IT-B/BachelorProefTrappenMaar/KiCad/7segments/7segments/7segments.kicad_sch

## KiCad design KiCad/7segments/7segments/7segments.kicad_sch (2022-04-07)

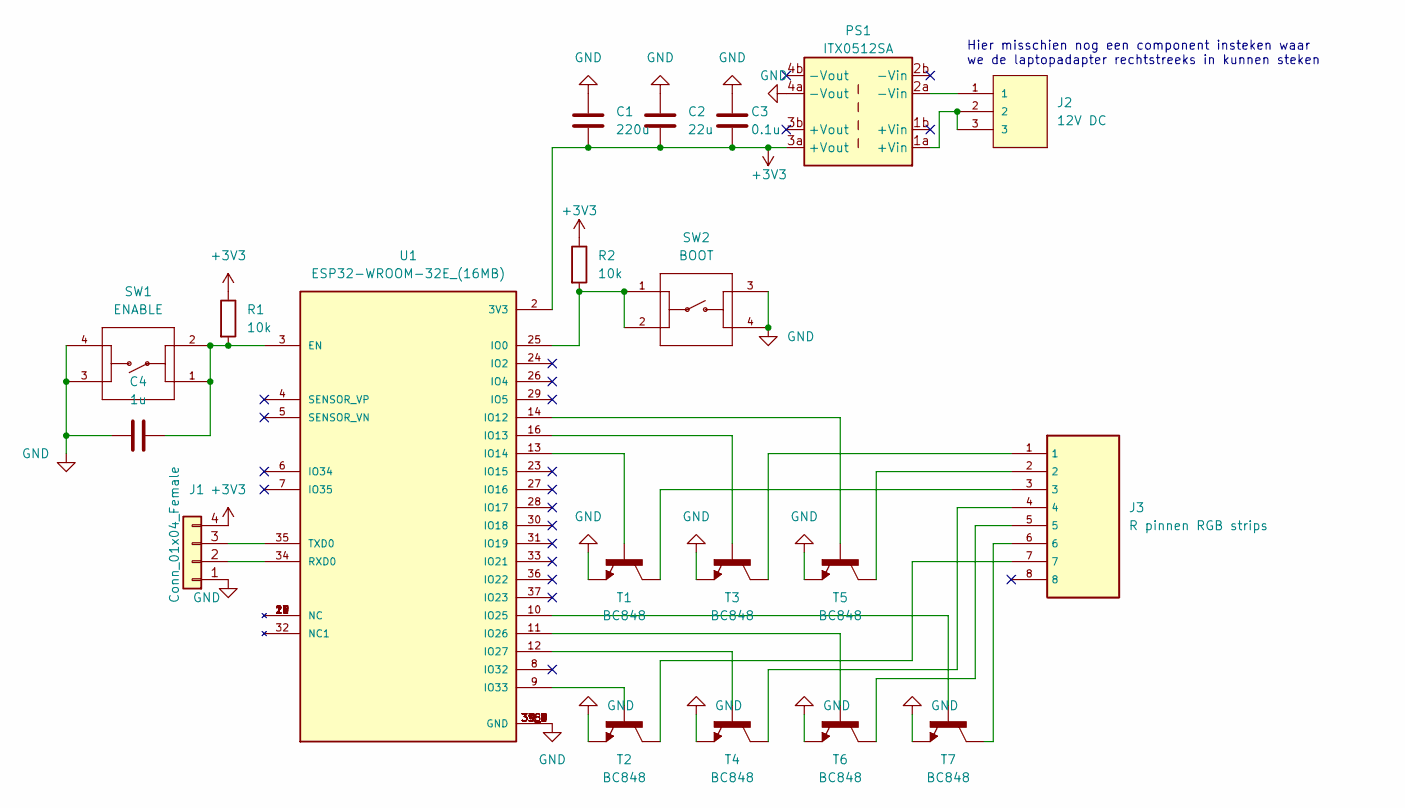
[picture p100: schematic 7segments.kicad_sch]

Parts:
C1: 220u; C_0805_2012Metric
C2: 22u; C_0805_2012Metric
C3: 0.1u; C_0805_2012Metric
C4: 1u; C_0805_2012Metric
J1: Conn_01x04_Female; PinHeader_1x04_P2.54mm_Vertical
J2: 12V DC; TE_282841-3
J3: R pinnen RGB strips; TE_282841-8
PS1: ITX0512SA; Buck Converter
R1, R2: 10k; R_0805_2012Metric
SW1: ENABLE; SW_1825910-6-4
SW2: BOOT; SW_1825910-6-4
T1, T2, T3, T4, T5, T6, T7: BC848; SOT23
U1: ESP32-WROOM-32E_(16MB); XCVR_ESP32-WROOM-32E_(16MB); PARTREV 1.4

Connections:
+3V3: C1.1, C2.1, C3.1, J1.4, PS1.3a (+Vout), R1.1, R2.1, U1.2 (3V3)
GND: C1.2, C2.2, C3.2, C4.1, J1.1, PS1.4a (-Vout), SW1.3, SW1.4, SW2.3, SW2.4, T1.2, T2.2, T3.2, T4.2, T5.2, T6.2, T7.2, U1.1 (GND), U1.15 (GND), U1.38 (GND), U1.39_1 (GND), U1.39_2 (GND), U1.39_3 (GND), U1.39_4 (GND), U1.39_5 (GND), U1.39_6 (GND), U1.39_7 (GND), U1.39_8 (GND), U1.39_9 (GND)
unnamed: C4.2, R1.2, SW1.1, SW1.2, U1.3 (EN)
unnamed: J1.2, U1.34 (RXD0)
unnamed: J1.3, U1.35 (TXD0)
unnamed: J2.1, PS1.2a (-Vin)
unnamed: J2.2, J2.3, PS1.1a (+Vin)
unnamed: J3.1, T3.3
unnamed: J3.2, T5.3
unnamed: J3.3, T1.3
unnamed: J3.4, T4.3
unnamed: J3.5, T6.3
unnamed: J3.6, T7.3
unnamed: J3.7, T2.3
unnamed: R2.2, SW2.1, SW2.2, U1.25 (IO0)
unnamed: T1.1, U1.13 (IO14)
unnamed: T2.1, U1.9 (IO33)
unnamed: T3.1, U1.16 (IO13)
unnamed: T4.1, U1.12 (IO27)
unnamed: T5.1, U1.14 (IO12)
unnamed: T6.1, U1.11 (IO26)
unnamed: T7.1, U1.10 (IO25)
unnamed: U1.17 (NC), U1.18 (NC), U1.19 (NC), U1.20 (NC), U1.21 (NC), U1.22 (NC)

Notes on the sheet:
Hier misschien nog een component insteken waar we de laptopadapter rechtstreeks in kunnen steken
