PLAN-IT-B/BachelorProefTrappenMaar/(commit log)

2022-02-16 Reed Relay
    begin van reed relay code met lcd
2022-02-21 blokschema's trappen maar
    Begin flowcharts waarin de stappen worden beschreven die de esp's doorlopen
2022-02-21 Update gedrag centrale ESP trappen maar.pdf
    reset functie toegevoegd aan flowchart voor wanneer de bandjes worden afgenomen, zodat de buffer helemaal leeg loopt
2022-02-21 Create Implementatie.docx
    in deze file wordt de implementatie uitgelegd met de basiselementen die we nodig hebben om de puzzel te realiseren
2022-02-22 toevoeging blacklight aan flowchart
2022-02-26 begin BOM
    Hierin staat voornamelijk de BOM voor de puzzel zelf en de buffer, het deel over de bijkomende puzzel werd hier nog niet in opgenomen
2022-02-27 Bemerkingen/ideeën BOM
2022-03-01 Create BOM.xlsx
    BOM in Excel
    [BOM.xlsx]
2022-03-01 update bom met link naar websites
    [BOM.xlsx]
2022-03-01 communicatie tussen 2 esp's proberen verwezenlijken
    nog niet geslaagd
2022-03-08 toevoeging 2e bestelling
    blacklight voor fietsgenerator
    [BOM.xlsx]
2022-03-08 nieuwe werkwijze om snelheid af te leiden
    overstappen naar spanningsdeler op fietsdynamo zodat we de spanning kunnen doorsturen naar een esp32 (ipv reed relay)
2022-03-08 toevoeging snelheid aflezen via esp
    werken met een gelijkrichter en spanningsdeler zodat spanning over weerstand kan doorgestuurd worden naar esp en zijn ingebouwde adc
2022-03-08 communicatie tussen esps
    deze map bevat enkel de juiste code voor de receiver
2022-03-22 functies uiteen halen
    aparte functie maken voor het versturen naar 7 segment
2022-03-28 goed begin voor buffer met rood, geel/oranje en groen
    Het geel/oranje werkt met een ledcWrite maar die functie bevat een delay voor groen, die nog niet helemaal op punt staat
2022-03-28 Problemen zoeken met senden en receiven
    [main.cpp]
2022-03-28 buffer rgb driver
2022-04-02 ontwerpen van pcb ontwerp voor de 7 segment displays
    [7segments.kicad_pcb, 7segments.kicad_sch, Buffer.kicad_pcb, Buffer.kicad_sch, standaard.kicad_pcb, standaard.kicad_sch]
2022-04-02 hernoemen map
    [standaard.kicad_pcb, standaard.kicad_sch]
2022-04-03 update standaard kicad schema
    [Buffer.kicad_sch, standaard.kicad_sch]
2022-04-03 kicad fiets
    [standaard.kicad_pcb, standaard.kicad_sch]
2022-04-03 aanpassingen fiets Kicad
    [standaard.kicad_pcb]
2022-04-03 kicad drawings
    [7segments.kicad_pcb, 7segments.kicad_sch, Buffer.kicad_pcb, Buffer.kicad_sch, hernieuwdeBuffer.kicad_pcb, hernieuwdeBuffer.kicad_sch]
2022-04-03 laatste aanpassingen Fiets Kicad (+voeding)
    [standaard.kicad_pcb, standaard.kicad_sch]
2022-04-04 updates standaard schema
    [hernieuwdeBuffer.kicad_pcb, hernieuwdeBuffer.kicad_sch, standaard.kicad_sch]
2022-04-05 aanpassingen
    aanpass kicad fiets
    [standaard.kicad_pcb, standaard.kicad_sch]
2022-04-05 kicad aanpassingen buffer
    [hernieuwdeBuffer.kicad_pcb, hernieuwdeBuffer.kicad_sch, standaard.kicad_sch]
2022-04-07 update buffer
    enkel schema van de buffer is volledig in orde met LDO!!!
    [7segments.kicad_pcb, 7segments.kicad_sch, hernieuwdeBuffer.kicad_pcb, hernieuwdeBuffer.kicad_sch]
2022-04-07 aanpassingen fiets (fouten eruit, ground plane, lijnen dikker)
    [standaard.kicad_pcb]
2022-04-07 betere versie kicad fiets
    [standaard.kicad_pcb, standaard.kicad_sch]
2022-04-09 7segments aangepast naar correcte versie (kicad)
    [7segments.kicad_pcb, 7segments.kicad_sch]
2022-04-09 laatste aanpassingen kicad 7segment
2022-04-09 aanpass kicad
    [7segments.kicad_pcb, 7segments.kicad_sch]
2022-04-09 updaten van 7 segment ground plane(s)
    versie voor 7 segment met 1 ground plane aan achterkant en andere versie met ground plane aan voor- en achterkant
    [7segment.kicad_pcb, 7segment.kicad_sch, 7segments.kicad_pcb, 7segments.kicad_sch, 7segments_beide_groundplane.kicad_pcb, 7segments_beide_groundplane.kicad_sch, hernieuwdeBuffer.kicad_pcb, hernieuwdeBuffer.kicad_sch]
2022-04-11 aanpassingen aan kicad ontwerpen van 7segment en buffer
    toevoeging van groundplanes
    [7segments.kicad_pcb, 7segments.kicad_sch, 7segments_beide_groundplane.kicad_pcb, 7segments_beide_groundplane.kicad_sch, hernieuwdeBuffer.kicad_sch, hernieuwdeBuffer_achterkant_groundplane.kicad_pcb, hernieuwdeBuffer_achterkant_groundplane.kicad_sch, hernieuwdeBuffer_beide_groundplane.kicad_pcb]
2022-04-11 cut-outs groundplanes onder antenne
    enkel voor 7 segments en buffer
    [7segments_beide_groundplane.kicad_pcb, 7segments_beide_groundplane.kicad_sch, hernieuwdeBuffer_beide_groundplane.kicad_pcb]
2022-04-11 aanmaak BOM 2e bestelronde
    [BOM.xlsx, BOM_2e_bestelronde.xlsx]
2022-04-12 aanpassingen 11/04 kicad
    [7segments_beide_groundplane.kicad_pcb, hernieuwdeBuffer.kicad_pcb, hernieuwdeBuffer.kicad_sch]
2022-04-12 update rgbdriver voor testen mosfets
2022-04-12 kicad fiets hertekend
    [7segments_beide_groundplane.kicad_sch, standaard.kicad_pcb, standaard.kicad_sch]
2022-04-12 testcode voor enkele ledstrip geel licht
2022-04-12 updates kroonsteentjes naar 2.54mm voor 7segment en buffer
    [7segments_beide_groundplane.kicad_pcb, 7segments_beide_groundplane.kicad_sch, hernieuwdeBuffer_beide_groundplane.kicad_pcb, hernieuwdeBuffer_beide_groundplane.kicad_sch]
2022-04-13 aanpassingen kicad fiets
    [standaard.kicad_pcb, standaard.kicad_sch]
2022-04-13 fiets hermaakt (2 versies level shifter)
    [hernieuwdeBuffer_beide_groundplane.kicad_sch, standaard.kicad_pcb, standaard.kicad_sch]
2022-04-14 aanmaak mapje voor finale ontwerpen
    [7segments_beide_groundplane.kicad_pcb, 7segments_beide_groundplane.kicad_sch, hernieuwdeBuffer_beide_groundplane.kicad_pcb, hernieuwdeBuffer_beide_groundplane.kicad_sch]
2022-04-14 definitieve ontwerpen in map PCB ontwerpen geplaatst
    [standaard.kicad_pcb, standaard.kicad_sch]
2022-04-14 laatste aanpassingen aan pcb ontwerpen
    [7segments_beide_groundplane.kicad_pcb, 7segments_beide_groundplane.kicad_sch, hernieuwdeBuffer_beide_groundplane.kicad_pcb, standaard.kicad_pcb]
2022-04-14 kopiëren van juiste pcb naar mapje over buffer
    [hernieuwdeBuffer_beide_groundplane.kicad_pcb]
2022-04-14 aanpassing 7 segment naar dc jack
    [7segments_beide_groundplane.kicad_pcb, 7segments_beide_groundplane.kicad_sch]
2022-04-19 kicad versie bert
    [7segments_beide_groundplane-B_Cu.gbl, 7segments_beide_groundplane-B_Mask.gbs, 7segments_beide_groundplane-B_Paste.gbp, 7segments_beide_groundplane-B_Silkscreen.gbo, 7segments_beide_groundplane-Edge_Cuts.gm1, 7segments_beide_groundplane-F_Cu.gtl, 7segments_beide_groundplane-F_Mask.gts, 7segments_beide_groundplane-F_Paste.gtp]
2022-04-19 assembly voor boxes en back-up code
    [Bovenzijde.SLDPRT, assembly.SLDASM, front plane.SLDPRT]
2022-04-19 aanpassingen code buffer leds
2022-04-19 code buffer met leds buffer
2022-04-19 solid works 7 segments
    juist gat voor kabel ontbreekt
    [Part4.SLDPRT, Part5.SLDPRT, Part6.SLDPRT, assembly.SLDASM, back plane.SLDPRT, front plane.SLDPRT]
2022-04-26 box fiets
    [BOX.SLDASM, bovenkant.SLDPRT, korte zijkant.SLDPRT, lange zijkant.SLDPRT, onderkant.SLDPRT]
2022-04-26 gat en dxf files 7 segments
    gat toegevoegd voor voeding 7 segments en aanmaak dxf files voor het laser cutten
    [BACK_PLANE.DXF, BACK_PLANE.SLDPRT, BOTTOM_PLANE.DXF, BOTTOM_PLANE.SLDPRT, Bovenzijde.SLDPRT, FRONT_PLANE.DXF, FRONT_PLANE.SLDPRT, LEFT_SIDE_PLANE.DXF]
2022-04-26 ruimte vrijmaken op github en kleine aanpassing 7 segments solidworks
    [7segment.kicad_pcb, 7segment.kicad_sch, 7segments.kicad_pcb, 7segments.kicad_sch, 7segments_beide_groundplane.kicad_pcb, 7segments_beide_groundplane.kicad_sch, 7segments_powerbank.kicad_pcb, 7segments_powerbank.kicad_sch]
2022-04-27 svg bestanden voor laser cutten
    [BOX.SLDASM, bovenkant.DXF, bovenkant.SLDPRT, korte zijkant.DXF, korte zijkant.SLDPRT, korte zijkant2.DXF, lange zijkant.DXF, lange zijkant.SLDPRT]
2022-04-28 laser cut files voor kleinere 7 segment en bovenkant fiets
    [Assem1.SLDASM, BACK_PLANE.DXF, BACK_PLANE.SLDPRT, BOTTOM_PLANE.DXF, BOTTOM_PLANE.SLDPRT, BOX.SLDASM, Bovenzijde.SLDPRT, FRONT_PLANE.DXF]
2022-04-28 aangepaste bovenkant voor fiets
    nu zijn het de juiste afmetingen voor het lcd scherm
2022-05-02 test your buddy + 7 segment led tester
2022-05-03 behuizing buffer voor lasercutten
    [Assem1.SLDASM, Part2.SLDPRT, achterkant.DXF, achterkant.SLDPRT, bovenkant.DXF, bovenkant.SLDPRT, buffer_klein_doosje.dxf, lange_zijkant1.DXF]
2022-05-09 aanpassing laatste boxen naar 3mm karton
    [3mm_Assem1.SLDASM, Assem1.SLDASM, BACK_PLANE.DXF, BACK_PLANE.SLDPRT, BOTTOM_PLANE.DXF, BOTTOM_PLANE.SLDPRT, FRONT_PLANE.DXF, FRONT_PLANE.SLDPRT]
2022-05-12 website map
    [BOM_2e_bestelronde.xlsx]
2022-05-13 aanpassingen led tester 7 segment
2022-05-13 goed code toevoegen, fotos website, ...
    [standaard.kicad_pcb, standaard.kicad_sch]
2022-05-15 aanpassingen aan eeschema en pcb fiets
    spanningsdeler gewijzigd en condensator juist georiënteerd
    [standaard.kicad_pcb, standaard.kicad_sch]
2022-05-15 BOM final
    [BOM(final version).xlsx, BOM_2e_bestelronde.xlsx]
